johnnyegel/Pico1541/docs/specs/task.md

# Task List: Root Directory Virtual Disk & Unified Location Architecture

- [x] 1. Canonical `DriveLocation` Type (`crates/pico1541-common/src/location.rs`)
- [x] 2. Root Directory Virtual Disk Track 18 Formatter (`crates/pico1541-manager/src/formats/virtual_disk.rs`)
- [x] 3. Unified CD Action Resolution & Location State Machine (`crates/pico1541-manager/src/tasks/mount_manager/cd_handler.rs`)
- [x] 4. Job Queue Selection for Root Slots & Mount Manager Integration (`crates/pico1541-manager/src/tasks/mount_manager/mod.rs`)
- [x] 5. Reactive OLED UI Integration & State Consolidation (`crates/pico1541-manager/src/tasks/ui/`, `rp2040/src/main.rs`, `rp2350/src/main.rs`)
- [x] 6. Full Verification, Release Target Checks & Code Cleanup
