johnnyegel/Pico1541/COMMERCIAL_LICENSE.md

# Commercial Licensing

This project is free for personal, non-commercial use. If you would like to manufacture and sell assembled 
Pico1541 units, I offer a commercial license for a flat royalty fee of 5 EUR/USD per sold unit. 

Please contact me at [johnnyege@gmail.com] to arrange a licensing agreement before beginning production.
