johnnyegel/Pico1541/tmp/1541 ROM disassembly.txt

<!DOCTYPE html>
<html lang="en-US">
<head>
	<meta charset="UTF-8">
	<title>pagetable.com &#8211; Some Assembly Required</title>
<meta name='robots' content='max-image-preview:large' />
<base href="/">
<meta name="viewport" content="width=device-width, initial-scale=1"><link rel="alternate" type="application/rss+xml" title="pagetable.com &raquo; Feed" href="https://www.pagetable.com/?feed=rss2" />
<link rel="alternate" type="application/rss+xml" title="pagetable.com &raquo; Comments Feed" href="https://www.pagetable.com/?feed=comments-rss2" />
<style id="wp-img-auto-sizes-contain-inline-css">
img:is([sizes=auto i],[sizes^="auto," i]){contain-intrinsic-size:3000px 1500px}
/*# sourceURL=wp-img-auto-sizes-contain-inline-css */
</style>
<style id="wp-emoji-styles-inline-css">

	img.wp-smiley, img.emoji {
		display: inline !important;
		border: none !important;
		box-shadow: none !important;
		height: 1em !important;
		width: 1em !important;
		margin: 0 0.07em !important;
		vertical-align: -0.1em !important;
		background: none !important;
		padding: 0 !important;
	}
/*# sourceURL=wp-emoji-styles-inline-css */
</style>
<style id="wp-block-library-inline-css">
:root{--wp-block-synced-color:#7a00df;--wp-block-synced-color--rgb:122,0,223;--wp-bound-block-color:var(--wp-block-synced-color);--wp-editor-canvas-background:#ddd;--wp-admin-theme-color:#007cba;--wp-admin-theme-color--rgb:0,124,186;--wp-admin-theme-color-darker-10:#006ba1;--wp-admin-theme-color-darker-10--rgb:0,107,160.5;--wp-admin-theme-color-darker-20:#005a87;--wp-admin-theme-color-darker-20--rgb:0,90,135;--wp-admin-border-width-focus:2px}@media (min-resolution:192dpi){:root{--wp-admin-border-width-focus:1.5px}}.wp-element-button{cursor:pointer}:root .has-very-light-gray-background-color{background-color:#eee}:root .has-very-dark-gray-background-color{background-color:#313131}:root .has-very-light-gray-color{color:#eee}:root .has-very-dark-gray-color{color:#313131}:root .has-vivid-green-cyan-to-vivid-cyan-blue-gradient-background{background:linear-gradient(135deg,#00d084,#0693e3)}:root .has-purple-crush-gradient-background{background:linear-gradient(135deg,#34e2e4,#4721fb 50%,#ab1dfe)}:root .has-hazy-dawn-gradient-background{background:linear-gradient(135deg,#faaca8,#dad0ec)}:root .has-subdued-olive-gradient-background{background:linear-gradient(135deg,#fafae1,#67a671)}:root .has-atomic-cream-gradient-background{background:linear-gradient(135deg,#fdd79a,#004a59)}:root .has-nightshade-gradient-background{background:linear-gradient(135deg,#330968,#31cdcf)}:root .has-midnight-gradient-background{background:linear-gradient(135deg,#020381,#2874fc)}:root{--wp--preset--font-size--normal:16px;--wp--preset--font-size--huge:42px}.has-regular-font-size{font-size:1em}.has-larger-font-size{font-size:2.625em}.has-normal-font-size{font-size:var(--wp--preset--font-size--normal)}.has-huge-font-size{font-size:var(--wp--preset--font-size--huge)}:root .has-text-align-center{text-align:center}:root .has-text-align-left{text-align:left}:root .has-text-align-right{text-align:right}.has-fit-text{white-space:nowrap!important}#end-resizable-editor-section{display:none}.aligncenter{clear:both}.items-justified-left{justify-content:flex-start}.items-justified-center{justify-content:center}.items-justified-right{justify-content:flex-end}.items-justified-space-between{justify-content:space-between}.screen-reader-text{word-wrap:normal!important;border:0;clip-path:inset(50%);height:1px;margin:-1px;overflow:hidden;padding:0;position:absolute;width:1px}.screen-reader-text:focus{background-color:#ddd;clip-path:none;color:#444;display:block;font-size:1em;height:auto;left:5px;line-height:normal;padding:15px 23px 14px;text-decoration:none;top:5px;width:auto;z-index:100000}html :where(.has-border-color){border-style:solid}html :where([style*=border-color]){border-style:solid}html :where([style*=border-top-color]){border-top-style:solid}html :where([style*=border-right-color]){border-right-style:solid}html :where([style*=border-bottom-color]){border-bottom-style:solid}html :where([style*=border-left-color]){border-left-style:solid}html :where([style*=border-width]){border-style:solid}html :where([style*=border-top-width]){border-top-style:solid}html :where([style*=border-right-width]){border-right-style:solid}html :where([style*=border-bottom-width]){border-bottom-style:solid}html :where([style*=border-left-width]){border-left-style:solid}html :where(img[class*=wp-image-]){height:auto;max-width:100%}:where(figure){margin:0 0 1em}html :where(.is-position-sticky){--wp-admin--admin-bar--position-offset:var(--wp-admin--admin-bar--height,0px)}@media screen and (max-width:600px){html :where(.is-position-sticky){--wp-admin--admin-bar--position-offset:0px}}

/*# sourceURL=/wp-includes/css/dist/block-library/common.min.css */
</style>
<style id="wp-block-heading-inline-css">
h1:where(.wp-block-heading).has-background,h2:where(.wp-block-heading).has-background,h3:where(.wp-block-heading).has-background,h4:where(.wp-block-heading).has-background,h5:where(.wp-block-heading).has-background,h6:where(.wp-block-heading).has-background{padding:1.25em 2.375em}h1.has-text-align-left[style*=writing-mode]:where([style*=vertical-lr]),h1.has-text-align-right[style*=writing-mode]:where([style*=vertical-rl]),h2.has-text-align-left[style*=writing-mode]:where([style*=vertical-lr]),h2.has-text-align-right[style*=writing-mode]:where([style*=vertical-rl]),h3.has-text-align-left[style*=writing-mode]:where([style*=vertical-lr]),h3.has-text-align-right[style*=writing-mode]:where([style*=vertical-rl]),h4.has-text-align-left[style*=writing-mode]:where([style*=vertical-lr]),h4.has-text-align-right[style*=writing-mode]:where([style*=vertical-rl]),h5.has-text-align-left[style*=writing-mode]:where([style*=vertical-lr]),h5.has-text-align-right[style*=writing-mode]:where([style*=vertical-rl]),h6.has-text-align-left[style*=writing-mode]:where([style*=vertical-lr]),h6.has-text-align-right[style*=writing-mode]:where([style*=vertical-rl]){rotate:180deg}
/*# sourceURL=https://www.pagetable.com/wp-includes/blocks/heading/style.min.css */
</style>
<style id="wp-block-latest-comments-inline-css">
ol.wp-block-latest-comments{box-sizing:border-box;margin-left:0}:where(.wp-block-latest-comments:not([style*=line-height] .wp-block-latest-comments__comment)){line-height:1.1}:where(.wp-block-latest-comments:not([style*=line-height] .wp-block-latest-comments__comment-excerpt p)){line-height:1.8}.has-dates :where(.wp-block-latest-comments:not([style*=line-height])),.has-excerpts :where(.wp-block-latest-comments:not([style*=line-height])){line-height:1.5}.wp-block-latest-comments .wp-block-latest-comments{padding-left:0}.wp-block-latest-comments__comment{list-style:none;margin-bottom:1em}.has-avatars .wp-block-latest-comments__comment{list-style:none;min-height:2.25em}.has-avatars .wp-block-latest-comments__comment .wp-block-latest-comments__comment-excerpt,.has-avatars .wp-block-latest-comments__comment .wp-block-latest-comments__comment-meta{margin-left:3.25em}.wp-block-latest-comments__comment-excerpt p{font-size:.875em;margin:.36em 0 1.4em}.wp-block-latest-comments__comment-date{display:block;font-size:.75em}.wp-block-latest-comments .avatar,.wp-block-latest-comments__comment-avatar{border-radius:1.5em;display:block;float:left;height:2.5em;margin-right:.75em;width:2.5em}.wp-block-latest-comments[class*=-font-size] a,.wp-block-latest-comments[style*=font-size] a{font-size:inherit}
/*# sourceURL=https://www.pagetable.com/wp-includes/blocks/latest-comments/style.min.css */
</style>
<style id="wp-block-search-inline-css">
.wp-block-search__button{margin-left:10px;word-break:normal}.wp-block-search__button.has-icon{line-height:0}.wp-block-search__button svg{fill:currentColor;height:1.25em;min-height:24px;min-width:24px;vertical-align:text-bottom;width:1.25em}:where(.wp-block-search__button){border:1px solid #ccc;padding:6px 10px}.wp-block-search__inside-wrapper{display:flex;flex:auto;flex-wrap:nowrap;max-width:100%}.wp-block-search__label{width:100%}.wp-block-search.wp-block-search__button-only .wp-block-search__button{box-sizing:border-box;display:flex;flex-shrink:0;justify-content:center;margin-left:0;max-width:100%}.wp-block-search.wp-block-search__button-only .wp-block-search__inside-wrapper{min-width:0!important;transition-property:width}.wp-block-search.wp-block-search__button-only .wp-block-search__input{flex-basis:100%;transition-duration:.3s}.wp-block-search.wp-block-search__button-only.wp-block-search__searchfield-hidden,.wp-block-search.wp-block-search__button-only.wp-block-search__searchfield-hidden .wp-block-search__inside-wrapper{overflow:hidden}.wp-block-search.wp-block-search__button-only.wp-block-search__searchfield-hidden .wp-block-search__input{border-left-width:0!important;border-right-width:0!important;flex-basis:0;flex-grow:0;margin:0;min-width:0!important;padding-left:0!important;padding-right:0!important;width:0!important}:where(.wp-block-search__input){appearance:none;border:1px solid #949494;flex-grow:1;font-family:inherit;font-size:inherit;font-style:inherit;font-weight:inherit;letter-spacing:inherit;line-height:inherit;margin-left:0;margin-right:0;min-width:3rem;padding:8px;text-decoration:unset!important;text-transform:inherit}:where(.wp-block-search__button-inside .wp-block-search__inside-wrapper){background-color:#fff;border:1px solid #949494;box-sizing:border-box;padding:4px}:where(.wp-block-search__button-inside .wp-block-search__inside-wrapper) .wp-block-search__input{border:none;border-radius:0;padding:0 4px}:where(.wp-block-search__button-inside .wp-block-search__inside-wrapper) .wp-block-search__input:focus{outline:none}:where(.wp-block-search__button-inside .wp-block-search__inside-wrapper) :where(.wp-block-search__button){padding:4px 8px}.wp-block-search.aligncenter .wp-block-search__inside-wrapper{margin:auto}.wp-block[data-align=right] .wp-block-search.wp-block-search__button-only .wp-block-search__inside-wrapper{float:right}
/*# sourceURL=https://www.pagetable.com/wp-includes/blocks/search/style.min.css */
</style>
<style id="wp-block-group-inline-css">
.wp-block-group{box-sizing:border-box}:where(.wp-block-group.wp-block-group-is-layout-constrained){position:relative}
/*# sourceURL=https://www.pagetable.com/wp-includes/blocks/group/style.min.css */
</style>

<style id="classic-theme-styles-inline-css">
/*! This file is auto-generated */
.wp-block-button__link{color:#fff;background-color:#32373c;border-radius:9999px;box-shadow:none;text-decoration:none;padding:calc(.667em + 2px) calc(1.333em + 2px);font-size:1.125em}.wp-block-file__button{background:#32373c;color:#fff;text-decoration:none}
/*# sourceURL=/wp-includes/css/classic-themes.min.css */
</style>

<style id="global-styles-inline-css">
:root{--wp--preset--aspect-ratio--square: 1;--wp--preset--aspect-ratio--4-3: 4/3;--wp--preset--aspect-ratio--3-4: 3/4;--wp--preset--aspect-ratio--3-2: 3/2;--wp--preset--aspect-ratio--2-3: 2/3;--wp--preset--aspect-ratio--16-9: 16/9;--wp--preset--aspect-ratio--9-16: 9/16;--wp--preset--color--black: #000000;--wp--preset--color--cyan-bluish-gray: #abb8c3;--wp--preset--color--white: #ffffff;--wp--preset--color--pale-pink: #f78da7;--wp--preset--color--vivid-red: #cf2e2e;--wp--preset--color--luminous-vivid-orange: #ff6900;--wp--preset--color--luminous-vivid-amber: #fcb900;--wp--preset--color--light-green-cyan: #7bdcb5;--wp--preset--color--vivid-green-cyan: #00d084;--wp--preset--color--pale-cyan-blue: #8ed1fc;--wp--preset--color--vivid-cyan-blue: #0693e3;--wp--preset--color--vivid-purple: #9b51e0;--wp--preset--color--contrast: var(--contrast);--wp--preset--color--contrast-2: var(--contrast-2);--wp--preset--color--contrast-3: var(--contrast-3);--wp--preset--color--base: var(--base);--wp--preset--color--base-2: var(--base-2);--wp--preset--color--base-3: var(--base-3);--wp--preset--color--accent: var(--accent);--wp--preset--gradient--vivid-cyan-blue-to-vivid-purple: linear-gradient(135deg,rgb(6,147,227) 0%,rgb(155,81,224) 100%);--wp--preset--gradient--light-green-cyan-to-vivid-green-cyan: linear-gradient(135deg,rgb(122,220,180) 0%,rgb(0,208,130) 100%);--wp--preset--gradient--luminous-vivid-amber-to-luminous-vivid-orange: linear-gradient(135deg,rgb(252,185,0) 0%,rgb(255,105,0) 100%);--wp--preset--gradient--luminous-vivid-orange-to-vivid-red: linear-gradient(135deg,rgb(255,105,0) 0%,rgb(207,46,46) 100%);--wp--preset--gradient--very-light-gray-to-cyan-bluish-gray: linear-gradient(135deg,rgb(238,238,238) 0%,rgb(169,184,195) 100%);--wp--preset--gradient--cool-to-warm-spectrum: linear-gradient(135deg,rgb(74,234,220) 0%,rgb(151,120,209) 20%,rgb(207,42,186) 40%,rgb(238,44,130) 60%,rgb(251,105,98) 80%,rgb(254,248,76) 100%);--wp--preset--gradient--blush-light-purple: linear-gradient(135deg,rgb(255,206,236) 0%,rgb(152,150,240) 100%);--wp--preset--gradient--blush-bordeaux: linear-gradient(135deg,rgb(254,205,165) 0%,rgb(254,45,45) 50%,rgb(107,0,62) 100%);--wp--preset--gradient--luminous-dusk: linear-gradient(135deg,rgb(255,203,112) 0%,rgb(199,81,192) 50%,rgb(65,88,208) 100%);--wp--preset--gradient--pale-ocean: linear-gradient(135deg,rgb(255,245,203) 0%,rgb(182,227,212) 50%,rgb(51,167,181) 100%);--wp--preset--gradient--electric-grass: linear-gradient(135deg,rgb(202,248,128) 0%,rgb(113,206,126) 100%);--wp--preset--gradient--midnight: linear-gradient(135deg,rgb(2,3,129) 0%,rgb(40,116,252) 100%);--wp--preset--font-size--small: 13px;--wp--preset--font-size--medium: 20px;--wp--preset--font-size--large: 36px;--wp--preset--font-size--x-large: 42px;--wp--preset--spacing--20: 0.44rem;--wp--preset--spacing--30: 0.67rem;--wp--preset--spacing--40: 1rem;--wp--preset--spacing--50: 1.5rem;--wp--preset--spacing--60: 2.25rem;--wp--preset--spacing--70: 3.38rem;--wp--preset--spacing--80: 5.06rem;--wp--preset--shadow--natural: 6px 6px 9px rgba(0, 0, 0, 0.2);--wp--preset--shadow--deep: 12px 12px 50px rgba(0, 0, 0, 0.4);--wp--preset--shadow--sharp: 6px 6px 0px rgba(0, 0, 0, 0.2);--wp--preset--shadow--outlined: 6px 6px 0px -3px rgb(255, 255, 255), 6px 6px rgb(0, 0, 0);--wp--preset--shadow--crisp: 6px 6px 0px rgb(0, 0, 0);}:where(body) { margin: 0; }:where(.is-layout-flex){gap: 0.5em;}:where(.is-layout-grid){gap: 0.5em;}body .is-layout-flex{display: flex;}.is-layout-flex{flex-wrap: wrap;align-items: center;}.is-layout-flex > :is(*, div){margin: 0;}body .is-layout-grid{display: grid;}.is-layout-grid > :is(*, div){margin: 0;}body{padding-top: 0px;padding-right: 0px;padding-bottom: 0px;padding-left: 0px;}:root :where(.wp-element-button, .wp-block-button__link){background-color: #32373c;border-width: 0;color: #fff;font-family: inherit;font-size: inherit;font-style: inherit;font-weight: inherit;letter-spacing: inherit;line-height: inherit;padding-top: calc(0.667em + 2px);padding-right: calc(1.333em + 2px);padding-bottom: calc(0.667em + 2px);padding-left: calc(1.333em + 2px);text-decoration: none;text-transform: inherit;}.has-black-color{color: var(--wp--preset--color--black) !important;}.has-cyan-bluish-gray-color{color: var(--wp--preset--color--cyan-bluish-gray) !important;}.has-white-color{color: var(--wp--preset--color--white) !important;}.has-pale-pink-color{color: var(--wp--preset--color--pale-pink) !important;}.has-vivid-red-color{color: var(--wp--preset--color--vivid-red) !important;}.has-luminous-vivid-orange-color{color: var(--wp--preset--color--luminous-vivid-orange) !important;}.has-luminous-vivid-amber-color{color: var(--wp--preset--color--luminous-vivid-amber) !important;}.has-light-green-cyan-color{color: var(--wp--preset--color--light-green-cyan) !important;}.has-vivid-green-cyan-color{color: var(--wp--preset--color--vivid-green-cyan) !important;}.has-pale-cyan-blue-color{color: var(--wp--preset--color--pale-cyan-blue) !important;}.has-vivid-cyan-blue-color{color: var(--wp--preset--color--vivid-cyan-blue) !important;}.has-vivid-purple-color{color: var(--wp--preset--color--vivid-purple) !important;}.has-contrast-color{color: var(--wp--preset--color--contrast) !important;}.has-contrast-2-color{color: var(--wp--preset--color--contrast-2) !important;}.has-contrast-3-color{color: var(--wp--preset--color--contrast-3) !important;}.has-base-color{color: var(--wp--preset--color--base) !important;}.has-base-2-color{color: var(--wp--preset--color--base-2) !important;}.has-base-3-color{color: var(--wp--preset--color--base-3) !important;}.has-accent-color{color: var(--wp--preset--color--accent) !important;}.has-black-background-color{background-color: var(--wp--preset--color--black) !important;}.has-cyan-bluish-gray-background-color{background-color: var(--wp--preset--color--cyan-bluish-gray) !important;}.has-white-background-color{background-color: var(--wp--preset--color--white) !important;}.has-pale-pink-background-color{background-color: var(--wp--preset--color--pale-pink) !important;}.has-vivid-red-background-color{background-color: var(--wp--preset--color--vivid-red) !important;}.has-luminous-vivid-orange-background-color{background-color: var(--wp--preset--color--luminous-vivid-orange) !important;}.has-luminous-vivid-amber-background-color{background-color: var(--wp--preset--color--luminous-vivid-amber) !important;}.has-light-green-cyan-background-color{background-color: var(--wp--preset--color--light-green-cyan) !important;}.has-vivid-green-cyan-background-color{background-color: var(--wp--preset--color--vivid-green-cyan) !important;}.has-pale-cyan-blue-background-color{background-color: var(--wp--preset--color--pale-cyan-blue) !important;}.has-vivid-cyan-blue-background-color{background-color: var(--wp--preset--color--vivid-cyan-blue) !important;}.has-vivid-purple-background-color{background-color: var(--wp--preset--color--vivid-purple) !important;}.has-contrast-background-color{background-color: var(--wp--preset--color--contrast) !important;}.has-contrast-2-background-color{background-color: var(--wp--preset--color--contrast-2) !important;}.has-contrast-3-background-color{background-color: var(--wp--preset--color--contrast-3) !important;}.has-base-background-color{background-color: var(--wp--preset--color--base) !important;}.has-base-2-background-color{background-color: var(--wp--preset--color--base-2) !important;}.has-base-3-background-color{background-color: var(--wp--preset--color--base-3) !important;}.has-accent-background-color{background-color: var(--wp--preset--color--accent) !important;}.has-black-border-color{border-color: var(--wp--preset--color--black) !important;}.has-cyan-bluish-gray-border-color{border-color: var(--wp--preset--color--cyan-bluish-gray) !important;}.has-white-border-color{border-color: var(--wp--preset--color--white) !important;}.has-pale-pink-border-color{border-color: var(--wp--preset--color--pale-pink) !important;}.has-vivid-red-border-color{border-color: var(--wp--preset--color--vivid-red) !important;}.has-luminous-vivid-orange-border-color{border-color: var(--wp--preset--color--luminous-vivid-orange) !important;}.has-luminous-vivid-amber-border-color{border-color: var(--wp--preset--color--luminous-vivid-amber) !important;}.has-light-green-cyan-border-color{border-color: var(--wp--preset--color--light-green-cyan) !important;}.has-vivid-green-cyan-border-color{border-color: var(--wp--preset--color--vivid-green-cyan) !important;}.has-pale-cyan-blue-border-color{border-color: var(--wp--preset--color--pale-cyan-blue) !important;}.has-vivid-cyan-blue-border-color{border-color: var(--wp--preset--color--vivid-cyan-blue) !important;}.has-vivid-purple-border-color{border-color: var(--wp--preset--color--vivid-purple) !important;}.has-contrast-border-color{border-color: var(--wp--preset--color--contrast) !important;}.has-contrast-2-border-color{border-color: var(--wp--preset--color--contrast-2) !important;}.has-contrast-3-border-color{border-color: var(--wp--preset--color--contrast-3) !important;}.has-base-border-color{border-color: var(--wp--preset--color--base) !important;}.has-base-2-border-color{border-color: var(--wp--preset--color--base-2) !important;}.has-base-3-border-color{border-color: var(--wp--preset--color--base-3) !important;}.has-accent-border-color{border-color: var(--wp--preset--color--accent) !important;}.has-vivid-cyan-blue-to-vivid-purple-gradient-background{background: var(--wp--preset--gradient--vivid-cyan-blue-to-vivid-purple) !important;}.has-light-green-cyan-to-vivid-green-cyan-gradient-background{background: var(--wp--preset--gradient--light-green-cyan-to-vivid-green-cyan) !important;}.has-luminous-vivid-amber-to-luminous-vivid-orange-gradient-background{background: var(--wp--preset--gradient--luminous-vivid-amber-to-luminous-vivid-orange) !important;}.has-luminous-vivid-orange-to-vivid-red-gradient-background{background: var(--wp--preset--gradient--luminous-vivid-orange-to-vivid-red) !important;}.has-very-light-gray-to-cyan-bluish-gray-gradient-background{background: var(--wp--preset--gradient--very-light-gray-to-cyan-bluish-gray) !important;}.has-cool-to-warm-spectrum-gradient-background{background: var(--wp--preset--gradient--cool-to-warm-spectrum) !important;}.has-blush-light-purple-gradient-background{background: var(--wp--preset--gradient--blush-light-purple) !important;}.has-blush-bordeaux-gradient-background{background: var(--wp--preset--gradient--blush-bordeaux) !important;}.has-luminous-dusk-gradient-background{background: var(--wp--preset--gradient--luminous-dusk) !important;}.has-pale-ocean-gradient-background{background: var(--wp--preset--gradient--pale-ocean) !important;}.has-electric-grass-gradient-background{background: var(--wp--preset--gradient--electric-grass) !important;}.has-midnight-gradient-background{background: var(--wp--preset--gradient--midnight) !important;}.has-small-font-size{font-size: var(--wp--preset--font-size--small) !important;}.has-medium-font-size{font-size: var(--wp--preset--font-size--medium) !important;}.has-large-font-size{font-size: var(--wp--preset--font-size--large) !important;}.has-x-large-font-size{font-size: var(--wp--preset--font-size--x-large) !important;}
/*# sourceURL=global-styles-inline-css */
</style>

<link rel='stylesheet' id='generate-style-css' href='https://www.pagetable.com/wp-content/themes/generatepress/assets/css/main.min.css?ver=3.5.1' media='all' />
<style id="generate-style-inline-css">
body{background-color:var(--base-2);color:var(--contrast);}a{color:var(--accent);}a{text-decoration:underline;}.entry-title a, .site-branding a, a.button, .wp-block-button__link, .main-navigation a{text-decoration:none;}a:hover, a:focus, a:active{color:var(--contrast);}.wp-block-group__inner-container{max-width:1200px;margin-left:auto;margin-right:auto;}:root{--contrast:#222222;--contrast-2:#575760;--contrast-3:#b2b2be;--base:#f0f0f0;--base-2:#f7f8f9;--base-3:#ffffff;--accent:#1e73be;}:root .has-contrast-color{color:var(--contrast);}:root .has-contrast-background-color{background-color:var(--contrast);}:root .has-contrast-2-color{color:var(--contrast-2);}:root .has-contrast-2-background-color{background-color:var(--contrast-2);}:root .has-contrast-3-color{color:var(--contrast-3);}:root .has-contrast-3-background-color{background-color:var(--contrast-3);}:root .has-base-color{color:var(--base);}:root .has-base-background-color{background-color:var(--base);}:root .has-base-2-color{color:var(--base-2);}:root .has-base-2-background-color{background-color:var(--base-2);}:root .has-base-3-color{color:var(--base-3);}:root .has-base-3-background-color{background-color:var(--base-3);}:root .has-accent-color{color:var(--accent);}:root .has-accent-background-color{background-color:var(--accent);}.top-bar{background-color:#636363;color:#ffffff;}.top-bar a{color:#ffffff;}.top-bar a:hover{color:#303030;}.site-header{background-color:var(--base-3);}.main-title a,.main-title a:hover{color:var(--contrast);}.site-description{color:var(--contrast-2);}.mobile-menu-control-wrapper .menu-toggle,.mobile-menu-control-wrapper .menu-toggle:hover,.mobile-menu-control-wrapper .menu-toggle:focus,.has-inline-mobile-toggle #site-navigation.toggled{background-color:rgba(0, 0, 0, 0.02);}.main-navigation,.main-navigation ul ul{background-color:var(--base-3);}.main-navigation .main-nav ul li a, .main-navigation .menu-toggle, .main-navigation .menu-bar-items{color:var(--contrast);}.main-navigation .main-nav ul li:not([class*="current-menu-"]):hover > a, .main-navigation .main-nav ul li:not([class*="current-menu-"]):focus > a, .main-navigation .main-nav ul li.sfHover:not([class*="current-menu-"]) > a, .main-navigation .menu-bar-item:hover > a, .main-navigation .menu-bar-item.sfHover > a{color:var(--accent);}button.menu-toggle:hover,button.menu-toggle:focus{color:var(--contrast);}.main-navigation .main-nav ul li[class*="current-menu-"] > a{color:var(--accent);}.navigation-search input[type="search"],.navigation-search input[type="search"]:active, .navigation-search input[type="search"]:focus, .main-navigation .main-nav ul li.search-item.active > a, .main-navigation .menu-bar-items .search-item.active > a{color:var(--accent);}.main-navigation ul ul{background-color:var(--base);}.separate-containers .inside-article, .separate-containers .comments-area, .separate-containers .page-header, .one-container .container, .separate-containers .paging-navigation, .inside-page-header{background-color:var(--base-3);}.entry-title a{color:var(--contrast);}.entry-title a:hover{color:var(--contrast-2);}.entry-meta{color:var(--contrast-2);}.sidebar .widget{background-color:var(--base-3);}.footer-widgets{background-color:var(--base-3);}.site-info{background-color:var(--base-3);}input[type="text"],input[type="email"],input[type="url"],input[type="password"],input[type="search"],input[type="tel"],input[type="number"],textarea,select{color:var(--contrast);background-color:var(--base-2);border-color:var(--base);}input[type="text"]:focus,input[type="email"]:focus,input[type="url"]:focus,input[type="password"]:focus,input[type="search"]:focus,input[type="tel"]:focus,input[type="number"]:focus,textarea:focus,select:focus{color:var(--contrast);background-color:var(--base-2);border-color:var(--contrast-3);}button,html input[type="button"],input[type="reset"],input[type="submit"],a.button,a.wp-block-button__link:not(.has-background){color:#ffffff;background-color:#55555e;}button:hover,html input[type="button"]:hover,input[type="reset"]:hover,input[type="submit"]:hover,a.button:hover,button:focus,html input[type="button"]:focus,input[type="reset"]:focus,input[type="submit"]:focus,a.button:focus,a.wp-block-button__link:not(.has-background):active,a.wp-block-button__link:not(.has-background):focus,a.wp-block-button__link:not(.has-background):hover{color:#ffffff;background-color:#3f4047;}a.generate-back-to-top{background-color:rgba( 0,0,0,0.4 );color:#ffffff;}a.generate-back-to-top:hover,a.generate-back-to-top:focus{background-color:rgba( 0,0,0,0.6 );color:#ffffff;}:root{--gp-search-modal-bg-color:var(--base-3);--gp-search-modal-text-color:var(--contrast);--gp-search-modal-overlay-bg-color:rgba(0,0,0,0.2);}@media (max-width:768px){.main-navigation .menu-bar-item:hover > a, .main-navigation .menu-bar-item.sfHover > a{background:none;color:var(--contrast);}}.nav-below-header .main-navigation .inside-navigation.grid-container, .nav-above-header .main-navigation .inside-navigation.grid-container{padding:0px 20px 0px 20px;}.site-main .wp-block-group__inner-container{padding:40px;}.separate-containers .paging-navigation{padding-top:20px;padding-bottom:20px;}.entry-content .alignwide, body:not(.no-sidebar) .entry-content .alignfull{margin-left:-40px;width:calc(100% + 80px);max-width:calc(100% + 80px);}.rtl .menu-item-has-children .dropdown-menu-toggle{padding-left:20px;}.rtl .main-navigation .main-nav ul li.menu-item-has-children > a{padding-right:20px;}@media (max-width:768px){.separate-containers .inside-article, .separate-containers .comments-area, .separate-containers .page-header, .separate-containers .paging-navigation, .one-container .site-content, .inside-page-header{padding:30px;}.site-main .wp-block-group__inner-container{padding:30px;}.inside-top-bar{padding-right:30px;padding-left:30px;}.inside-header{padding-right:30px;padding-left:30px;}.widget-area .widget{padding-top:30px;padding-right:30px;padding-bottom:30px;padding-left:30px;}.footer-widgets-container{padding-top:30px;padding-right:30px;padding-bottom:30px;padding-left:30px;}.inside-site-info{padding-right:30px;padding-left:30px;}.entry-content .alignwide, body:not(.no-sidebar) .entry-content .alignfull{margin-left:-30px;width:calc(100% + 60px);max-width:calc(100% + 60px);}.one-container .site-main .paging-navigation{margin-bottom:20px;}}/* End cached CSS */.is-right-sidebar{width:30%;}.is-left-sidebar{width:30%;}.site-content .content-area{width:70%;}@media (max-width:768px){.main-navigation .menu-toggle,.sidebar-nav-mobile:not(#sticky-placeholder){display:block;}.main-navigation ul,.gen-sidebar-nav,.main-navigation:not(.slideout-navigation):not(.toggled) .main-nav > ul,.has-inline-mobile-toggle #site-navigation .inside-navigation > *:not(.navigation-search):not(.main-nav){display:none;}.nav-align-right .inside-navigation,.nav-align-center .inside-navigation{justify-content:space-between;}.has-inline-mobile-toggle .mobile-menu-control-wrapper{display:flex;flex-wrap:wrap;}.has-inline-mobile-toggle .inside-header{flex-direction:row;text-align:left;flex-wrap:wrap;}.has-inline-mobile-toggle .header-widget,.has-inline-mobile-toggle #site-navigation{flex-basis:100%;}.nav-float-left .has-inline-mobile-toggle #site-navigation{order:10;}}
/*# sourceURL=generate-style-inline-css */
</style>
<link rel='stylesheet' id='ecae-frontend-css' href='https://www.pagetable.com/wp-content/plugins/easy-custom-auto-excerpt/assets/style-frontend.css?ver=2.5.0' media='all' />
<style id="ecae-frontend-inline-css">
.ecae-button { font-size: 14px !important; }
/*# sourceURL=ecae-frontend-inline-css */
</style>
<link rel='stylesheet' id='ecae-buttonskin-none-css' href='https://www.pagetable.com/wp-content/plugins/easy-custom-auto-excerpt/buttons/ecae-buttonskin-none.css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' media='all' />
<link rel="https://api.w.org/" href="https://www.pagetable.com/index.php?rest_route=/" /><link rel="EditURI" type="application/rsd+xml" title="RSD" href="https://www.pagetable.com/xmlrpc.php?rsd" />
<meta name="generator" content="WordPress 7.0" />
<style id="wp-custom-css">
pre, code { font-family: monospace; font-size: smaller }

blockquote { font-size: 1em }
</style>
</head>

<body class="home blog wp-embed-responsive wp-theme-generatepress right-sidebar nav-float-right separate-containers header-aligned-left dropdown-hover" itemtype="https://schema.org/Blog" itemscope>
	<a class="screen-reader-text skip-link" href="#content" title="Skip to content">Skip to content</a>		<header class="site-header has-inline-mobile-toggle" id="masthead" aria-label="Site"  itemtype="https://schema.org/WPHeader" itemscope>
			<div class="inside-header grid-container">
				<div class="site-branding">
						<h1 class="main-title" itemprop="headline">
					<a href="https://www.pagetable.com/" rel="home">pagetable.com</a>
				</h1>
						<p class="site-description" itemprop="description">Some Assembly Required</p>
					</div>	<nav class="main-navigation mobile-menu-control-wrapper" id="mobile-menu-control-wrapper" aria-label="Mobile Toggle">
				<button data-nav="site-navigation" class="menu-toggle" aria-controls="primary-menu" aria-expanded="false">
			<span class="gp-icon icon-menu-bars"><svg viewBox="0 0 512 512" aria-hidden="true" xmlns="http://www.w3.org/2000/svg" width="1em" height="1em"><path d="M0 96c0-13.255 10.745-24 24-24h464c13.255 0 24 10.745 24 24s-10.745 24-24 24H24c-13.255 0-24-10.745-24-24zm0 160c0-13.255 10.745-24 24-24h464c13.255 0 24 10.745 24 24s-10.745 24-24 24H24c-13.255 0-24-10.745-24-24zm0 160c0-13.255 10.745-24 24-24h464c13.255 0 24 10.745 24 24s-10.745 24-24 24H24c-13.255 0-24-10.745-24-24z" /></svg><svg viewBox="0 0 512 512" aria-hidden="true" xmlns="http://www.w3.org/2000/svg" width="1em" height="1em"><path d="M71.029 71.029c9.373-9.372 24.569-9.372 33.942 0L256 222.059l151.029-151.03c9.373-9.372 24.569-9.372 33.942 0 9.372 9.373 9.372 24.569 0 33.942L289.941 256l151.03 151.029c9.372 9.373 9.372 24.569 0 33.942-9.373 9.372-24.569 9.372-33.942 0L256 289.941l-151.029 151.03c-9.373 9.372-24.569 9.372-33.942 0-9.372-9.373-9.372-24.569 0-33.942L222.059 256 71.029 104.971c-9.372-9.373-9.372-24.569 0-33.942z" /></svg></span><span class="screen-reader-text">Menu</span>		</button>
	</nav>
			<nav class="main-navigation sub-menu-right" id="site-navigation" aria-label="Primary"  itemtype="https://schema.org/SiteNavigationElement" itemscope>
			<div class="inside-navigation grid-container">
								<button class="menu-toggle" aria-controls="primary-menu" aria-expanded="false">
					<span class="gp-icon icon-menu-bars"><svg viewBox="0 0 512 512" aria-hidden="true" xmlns="http://www.w3.org/2000/svg" width="1em" height="1em"><path d="M0 96c0-13.255 10.745-24 24-24h464c13.255 0 24 10.745 24 24s-10.745 24-24 24H24c-13.255 0-24-10.745-24-24zm0 160c0-13.255 10.745-24 24-24h464c13.255 0 24 10.745 24 24s-10.745 24-24 24H24c-13.255 0-24-10.745-24-24zm0 160c0-13.255 10.745-24 24-24h464c13.255 0 24 10.745 24 24s-10.745 24-24 24H24c-13.255 0-24-10.745-24-24z" /></svg><svg viewBox="0 0 512 512" aria-hidden="true" xmlns="http://www.w3.org/2000/svg" width="1em" height="1em"><path d="M71.029 71.029c9.373-9.372 24.569-9.372 33.942 0L256 222.059l151.029-151.03c9.373-9.372 24.569-9.372 33.942 0 9.372 9.373 9.372 24.569 0 33.942L289.941 256l151.03 151.029c9.372 9.373 9.372 24.569 0 33.942-9.373 9.372-24.569 9.372-33.942 0L256 289.941l-151.029 151.03c-9.373 9.372-24.569 9.372-33.942 0-9.372-9.373-9.372-24.569 0-33.942L222.059 256 71.029 104.971c-9.372-9.373-9.372-24.569 0-33.942z" /></svg></span><span class="mobile-menu">Menu</span>				</button>
						<div id="primary-menu" class="main-nav">
			<ul class="menu sf-menu">
				<li class="page_item page-item-7"><a href="https://www.pagetable.com/?page_id=7">About</a></li>
			</ul>
		</div>
					</div>
		</nav>
					</div>
		</header>
		
	<div class="site grid-container container hfeed" id="page">
				<div class="site-content" id="content">
			
	<div class="content-area" id="primary">
		<main class="site-main" id="main">
			<article id="post-1844" class="post-1844 post type-post status-publish format-standard hentry category-c64 category-commodore category-literature" itemtype="https://schema.org/CreativeWork" itemscope>
	<div class="inside-article">
					<header class="entry-header">
				<h2 class="entry-title" itemprop="headline"><a href="https://www.pagetable.com/?p=1844" rel="bookmark">Das Statistikbuch zum Commodore 64 [PDF]</a></h2>		<div class="entry-meta">
			<span class="posted-on"><time class="entry-date published" datetime="2026-06-06T10:00:00+02:00" itemprop="datePublished">2026-06-06</time></span> <span class="byline">by <span class="author vcard" itemprop="author" itemtype="https://schema.org/Person" itemscope><a class="url fn n" href="https://www.pagetable.com/?author=1" title="View all posts by Michael Steil" rel="author" itemprop="url"><span class="author-name" itemprop="name">Michael Steil</span></a></span></span> 		</div>
					</header>
			
			<div class="entry-summary" itemprop="text">
				<!-- Begin :: Generated by Easy Custom Auto Excerpt --><div class="ecae" style=""><div class="ecae-image ecae-table-right"><div class='ecae-table-cell'><p><a href="docs/dirk_books/Das Statistikbuch zum Commodore 64.pdf"><br />
Werner Vo&szlig;:<br />
<b>Das Statistikbuch zum Commodore 64</b><br />
D&uuml;sseldorf: Data Becker, 1985.<br />
ISBN 3-89011-102-5.<br />
(468 pages, 33 MB)</a><br />
<em>Danke an Dirk Wagner f&uuml;r die Bereitstellung des Buchs.</em><span class="ecae-button ecae-buttonskin-none" style="text-align:left" >  <a class="ecae-link" href="https://www.pagetable.com/?p=1844"><span>read more</span></a></span></p></div></div><!-- End :: Generated by Easy Custom Auto Excerpt -->			</div>

				<footer class="entry-meta" aria-label="Entry meta">
			<span class="cat-links"><span class="gp-icon icon-categories"><svg viewBox="0 0 512 512" aria-hidden="true" xmlns="http://www.w3.org/2000/svg" width="1em" height="1em"><path d="M0 112c0-26.51 21.49-48 48-48h110.014a48 48 0 0143.592 27.907l12.349 26.791A16 16 0 00228.486 128H464c26.51 0 48 21.49 48 48v224c0 26.51-21.49 48-48 48H48c-26.51 0-48-21.49-48-48V112z" /></svg></span><span class="screen-reader-text">Categories </span><a href="https://www.pagetable.com/?cat=41" rel="category">C64</a>, <a href="https://www.pagetable.com/?cat=8" rel="category">Commodore</a>, <a href="https://www.pagetable.com/?cat=20" rel="category">Literature</a></span> <span class="comments-link"><span class="gp-icon icon-comments"><svg viewBox="0 0 512 512" aria-hidden="true" xmlns="http://www.w3.org/2000/svg" width="1em" height="1em"><path d="M132.838 329.973a435.298 435.298 0 0016.769-9.004c13.363-7.574 26.587-16.142 37.419-25.507 7.544.597 15.27.925 23.098.925 54.905 0 105.634-15.311 143.285-41.28 23.728-16.365 43.115-37.692 54.155-62.645 54.739 22.205 91.498 63.272 91.498 110.286 0 42.186-29.558 79.498-75.09 102.828 23.46 49.216 75.09 101.709 75.09 101.709s-115.837-38.35-154.424-78.46c-9.956 1.12-20.297 1.758-30.793 1.758-88.727 0-162.927-43.071-181.007-100.61z"/><path d="M383.371 132.502c0 70.603-82.961 127.787-185.216 127.787-10.496 0-20.837-.639-30.793-1.757-38.587 40.093-154.424 78.429-154.424 78.429s51.63-52.472 75.09-101.67c-45.532-23.321-75.09-60.619-75.09-102.79C12.938 61.9 95.9 4.716 198.155 4.716 300.41 4.715 383.37 61.9 383.37 132.502z" /></svg></span><a href="https://www.pagetable.com/?p=1844#respond">Leave a comment</a></span> 		</footer>
			</div>
</article>
<article id="post-1842" class="post-1842 post type-post status-publish format-standard hentry category-c64 category-commodore category-literature" itemtype="https://schema.org/CreativeWork" itemscope>
	<div class="inside-article">
					<header class="entry-header">
				<h2 class="entry-title" itemprop="headline"><a href="https://www.pagetable.com/?p=1842" rel="bookmark">Das Schulbuch zum Commodore 64 [PDF]</a></h2>		<div class="entry-meta">
			<span class="posted-on"><time class="entry-date published" datetime="2026-05-30T10:00:00+02:00" itemprop="datePublished">2026-05-30</time></span> <span class="byline">by <span class="author vcard" itemprop="author" itemtype="https://schema.org/Person" itemscope><a class="url fn n" href="https://www.pagetable.com/?author=1" title="View all posts by Michael Steil" rel="author" itemprop="url"><span class="author-name" itemprop="name">Michael Steil</span></a></span></span> 		</div>
					</header>
			
			<div class="entry-summary" itemprop="text">
				<!-- Begin :: Generated by Easy Custom Auto Excerpt --><div class="ecae" style=""><div class="ecae-image ecae-table-right"><div class='ecae-table-cell'><p><a href="docs/dirk_books/Das Schulbuch zum Commodore 64.pdf"><br />
Werner Vo&szlig;:<br />
<b>Das Schulbuch zum Commodore 64</b><br />
D&uuml;sseldorf: Data Becker, 1984.<br />
ISBN 3-89011-019-3.<br />
(354 pages, 21 MB)</a><br />
<em>Danke an Dirk Wagner f&uuml;r die Bereitstellung des Buchs.</em><span class="ecae-button ecae-buttonskin-none" style="text-align:left" >  <a class="ecae-link" href="https://www.pagetable.com/?p=1842"><span>read more</span></a></span></p></div></div><!-- End :: Generated by Easy Custom Auto Excerpt -->			</div>

				<footer class="entry-meta" aria-label="Entry meta">
			<span class="cat-links"><span class="gp-icon icon-categories"><svg viewBox="0 0 512 512" aria-hidden="true" xmlns="http://www.w3.org/2000/svg" width="1em" height="1em"><path d="M0 112c0-26.51 21.49-48 48-48h110.014a48 48 0 0143.592 27.907l12.349 26.791A16 16 0 00228.486 128H464c26.51 0 48 21.49 48 48v224c0 26.51-21.49 48-48 48H48c-26.51 0-48-21.49-48-48V112z" /></svg></span><span class="screen-reader-text">Categories </span><a href="https://www.pagetable.com/?cat=41" rel="category">C64</a>, <a href="https://www.pagetable.com/?cat=8" rel="category">Commodore</a>, <a href="https://www.pagetable.com/?cat=20" rel="category">Literature</a></span> <span class="comments-link"><span class="gp-icon icon-comments"><svg viewBox="0 0 512 512" aria-hidden="true" xmlns="http://www.w3.org/2000/svg" width="1em" height="1em"><path d="M132.838 329.973a435.298 435.298 0 0016.769-9.004c13.363-7.574 26.587-16.142 37.419-25.507 7.544.597 15.27.925 23.098.925 54.905 0 105.634-15.311 143.285-41.28 23.728-16.365 43.115-37.692 54.155-62.645 54.739 22.205 91.498 63.272 91.498 110.286 0 42.186-29.558 79.498-75.09 102.828 23.46 49.216 75.09 101.709 75.09 101.709s-115.837-38.35-154.424-78.46c-9.956 1.12-20.297 1.758-30.793 1.758-88.727 0-162.927-43.071-181.007-100.61z"/><path d="M383.371 132.502c0 70.603-82.961 127.787-185.216 127.787-10.496 0-20.837-.639-30.793-1.757-38.587 40.093-154.424 78.429-154.424 78.429s51.63-52.472 75.09-101.67c-45.532-23.321-75.09-60.619-75.09-102.79C12.938 61.9 95.9 4.716 198.155 4.716 300.41 4.715 383.37 61.9 383.37 132.502z" /></svg></span><a href="https://www.pagetable.com/?p=1842#comments">2 Comments</a></span> 		</footer>
			</div>
</article>
<article id="post-1840" class="post-1840 post type-post status-publish format-standard hentry category-c64 category-commodore category-literature" itemtype="https://schema.org/CreativeWork" itemscope>
	<div class="inside-article">
					<header class="entry-header">
				<h2 class="entry-title" itemprop="headline"><a href="https://www.pagetable.com/?p=1840" rel="bookmark">Das Grafikbuch zum Commodore 64 [PDF]</a></h2>		<div class="entry-meta">
			<span class="posted-on"><time class="entry-date published" datetime="2026-05-23T10:00:00+02:00" itemprop="datePublished">2026-05-23</time></span> <span class="byline">by <span class="author vcard" itemprop="author" itemtype="https://schema.org/Person" itemscope><a class="url fn n" href="https://www.pagetable.com/?author=1" title="View all posts by Michael Steil" rel="author" itemprop="url"><span class="author-name" itemprop="name">Michael Steil</span></a></span></span> 		</div>
					</header>
			
			<div class="entry-summary" itemprop="text">
				<!-- Begin :: Generated by Easy Custom Auto Excerpt --><div class="ecae" style=""><div class="ecae-image ecae-table-right"><div class='ecae-table-cell'><p><a href="docs/dirk_books/Das Grafikbuch zum Commodore 64.pdf"><br />
Axel Plenge:<br />
<b>Das Grafikbuch zum Commodore 64</b><br />
D&uuml;sseldorf: Data Becker, 1984.<br />
ISBN 3-89011-009-6.<br />
(305 pages, 28 MB)</a><br />
<em>Danke an Dirk Wagner f&uuml;r die Bereitstellung des Buchs.</em><span class="ecae-button ecae-buttonskin-none" style="text-align:left" >  <a class="ecae-link" href="https://www.pagetable.com/?p=1840"><span>read more</span></a></span></p></div></div><!-- End :: Generated by Easy Custom Auto Excerpt -->			</div>

				<footer class="entry-meta" aria-label="Entry meta">
			<span class="cat-links"><span class="gp-icon icon-categories"><svg viewBox="0 0 512 512" aria-hidden="true" xmlns="http://www.w3.org/2000/svg" width="1em" height="1em"><path d="M0 112c0-26.51 21.49-48 48-48h110.014a48 48 0 0143.592 27.907l12.349 26.791A16 16 0 00228.486 128H464c26.51 0 48 21.49 48 48v224c0 26.51-21.49 48-48 48H48c-26.51 0-48-21.49-48-48V112z" /></svg></span><span class="screen-reader-text">Categories </span><a href="https://www.pagetable.com/?cat=41" rel="category">C64</a>, <a href="https://www.pagetable.com/?cat=8" rel="category">Commodore</a>, <a href="https://www.pagetable.com/?cat=20" rel="category">Literature</a></span> <span class="comments-link"><span class="gp-icon icon-comments"><svg viewBox="0 0 512 512" aria-hidden="true" xmlns="http://www.w3.org/2000/svg" width="1em" height="1em"><path d="M132.838 329.973a435.298 435.298 0 0016.769-9.004c13.363-7.574 26.587-16.142 37.419-25.507 7.544.597 15.27.925 23.098.925 54.905 0 105.634-15.311 143.285-41.28 23.728-16.365 43.115-37.692 54.155-62.645 54.739 22.205 91.498 63.272 91.498 110.286 0 42.186-29.558 79.498-75.09 102.828 23.46 49.216 75.09 101.709 75.09 101.709s-115.837-38.35-154.424-78.46c-9.956 1.12-20.297 1.758-30.793 1.758-88.727 0-162.927-43.071-181.007-100.61z"/><path d="M383.371 132.502c0 70.603-82.961 127.787-185.216 127.787-10.496 0-20.837-.639-30.793-1.757-38.587 40.093-154.424 78.429-154.424 78.429s51.63-52.472 75.09-101.67c-45.532-23.321-75.09-60.619-75.09-102.79C12.938 61.9 95.9 4.716 198.155 4.716 300.41 4.715 383.37 61.9 383.37 132.502z" /></svg></span><a href="https://www.pagetable.com/?p=1840#comments">2 Comments</a></span> 		</footer>
			</div>
</article>
<article id="post-1837" class="post-1837 post type-post status-publish format-standard hentry category-c64 category-commodore category-literature" itemtype="https://schema.org/CreativeWork" itemscope>
	<div class="inside-article">
					<header class="entry-header">
				<h2 class="entry-title" itemprop="headline"><a href="https://www.pagetable.com/?p=1837" rel="bookmark">Das Commodore-64-Spiele-Buch [PDF]</a></h2>		<div class="entry-meta">
			<span class="posted-on"><time class="entry-date published" datetime="2026-05-16T10:00:00+02:00" itemprop="datePublished">2026-05-16</time></span> <span class="byline">by <span class="author vcard" itemprop="author" itemtype="https://schema.org/Person" itemscope><a class="url fn n" href="https://www.pagetable.com/?author=1" title="View all posts by Michael Steil" rel="author" itemprop="url"><span class="author-name" itemprop="name">Michael Steil</span></a></span></span> 		</div>
					</header>
			
			<div class="entry-summary" itemprop="text">
				<!-- Begin :: Generated by Easy Custom Auto Excerpt --><div class="ecae" style=""><div class="ecae-image ecae-table-right"><div class='ecae-table-cell'><p><a href="docs/dirk_books/Das Commodore 64 Spiele-Buch.pdf"><br />
Owen Bishop:<br />
<b>Das Commodore-64-Spiele-Buch</b><br />
Frankfurt/M.: Commodore, 1984. (Commodore-Sachbuchreihe, Bd. 4)<br />
ISBN 3-89133-002-2.<br />
(162 pages, 29 MB)<br />
Aus dem Englischen &uuml;bertragen von Gudrun Breiter. Originaltitel: <i>The Commodore 64 Games Book &ndash; 21 Sensational Games</i> (Granada Publishing, 1983).</a><br />
<em>Danke an Dirk Wagner f&uuml;r die Bereitstellung des Buchs.</em><span class="ecae-button ecae-buttonskin-none" style="text-align:left" >  <a class="ecae-link" href="https://www.pagetable.com/?p=1837"><span>read more</span></a></span></p></div></div><!-- End :: Generated by Easy Custom Auto Excerpt -->			</div>

				<footer class="entry-meta" aria-label="Entry meta">
			<span class="cat-links"><span class="gp-icon icon-categories"><svg viewBox="0 0 512 512" aria-hidden="true" xmlns="http://www.w3.org/2000/svg" width="1em" height="1em"><path d="M0 112c0-26.51 21.49-48 48-48h110.014a48 48 0 0143.592 27.907l12.349 26.791A16 16 0 00228.486 128H464c26.51 0 48 21.49 48 48v224c0 26.51-21.49 48-48 48H48c-26.51 0-48-21.49-48-48V112z" /></svg></span><span class="screen-reader-text">Categories </span><a href="https://www.pagetable.com/?cat=41" rel="category">C64</a>, <a href="https://www.pagetable.com/?cat=8" rel="category">Commodore</a>, <a href="https://www.pagetable.com/?cat=20" rel="category">Literature</a></span> <span class="comments-link"><span class="gp-icon icon-comments"><svg viewBox="0 0 512 512" aria-hidden="true" xmlns="http://www.w3.org/2000/svg" width="1em" height="1em"><path d="M132.838 329.973a435.298 435.298 0 0016.769-9.004c13.363-7.574 26.587-16.142 37.419-25.507 7.544.597 15.27.925 23.098.925 54.905 0 105.634-15.311 143.285-41.28 23.728-16.365 43.115-37.692 54.155-62.645 54.739 22.205 91.498 63.272 91.498 110.286 0 42.186-29.558 79.498-75.09 102.828 23.46 49.216 75.09 101.709 75.09 101.709s-115.837-38.35-154.424-78.46c-9.956 1.12-20.297 1.758-30.793 1.758-88.727 0-162.927-43.071-181.007-100.61z"/><path d="M383.371 132.502c0 70.603-82.961 127.787-185.216 127.787-10.496 0-20.837-.639-30.793-1.757-38.587 40.093-154.424 78.429-154.424 78.429s51.63-52.472 75.09-101.67c-45.532-23.321-75.09-60.619-75.09-102.79C12.938 61.9 95.9 4.716 198.155 4.716 300.41 4.715 383.37 61.9 383.37 132.502z" /></svg></span><a href="https://www.pagetable.com/?p=1837#comments">6 Comments</a></span> 		</footer>
			</div>
</article>
<article id="post-1860" class="post-1860 post type-post status-publish format-standard hentry category-2 category-archeology category-basic category-c64 category-commodore category-literature" itemtype="https://schema.org/CreativeWork" itemscope>
	<div class="inside-article">
					<header class="entry-header">
				<h2 class="entry-title" itemprop="headline"><a href="https://www.pagetable.com/?p=1860" rel="bookmark">Das Nikolaus-Heusler-Archiv</a></h2>		<div class="entry-meta">
			<span class="posted-on"><time class="entry-date published" datetime="2026-05-09T08:47:24+02:00" itemprop="datePublished">2026-05-09</time></span> <span class="byline">by <span class="author vcard" itemprop="author" itemtype="https://schema.org/Person" itemscope><a class="url fn n" href="https://www.pagetable.com/?author=1" title="View all posts by Michael Steil" rel="author" itemprop="url"><span class="author-name" itemprop="name">Michael Steil</span></a></span></span> 		</div>
					</header>
			
			<div class="entry-summary" itemprop="text">
				<!-- Begin :: Generated by Easy Custom Auto Excerpt --><div class="ecae" style=""><div class="ecae-image ecae-table-right"><div class="ecae-table-cell" style="width:200px;padding:0px 0px 0px 0px;"><a href="/docs/nheusler/">Screenshot des Heusler-Archivs auf pagetable.com</a></div><div class='ecae-table-cell'><p>Nikolaus Heusler zählt zu den produktivsten Autoren des <em>64&#8217;er Magazins</em>: hunderte Beiträge zwischen 1987 und 1995. Heusler, Jahrgang 1969, hatte seinen C64 zu Weihnachten 1983 bekommen; heute arbeitet er beim Europäischen Patentamt in München.<span class="ecae-button ecae-buttonskin-none" style="text-align:left" >  <a class="ecae-link" href="https://www.pagetable.com/?p=1860"><span>read more</span></a></span></p></div></div><!-- End :: Generated by Easy Custom Auto Excerpt -->			</div>

				<footer class="entry-meta" aria-label="Entry meta">
			<span class="cat-links"><span class="gp-icon icon-categories"><svg viewBox="0 0 512 512" aria-hidden="true" xmlns="http://www.w3.org/2000/svg" width="1em" height="1em"><path d="M0 112c0-26.51 21.49-48 48-48h110.014a48 48 0 0143.592 27.907l12.349 26.791A16 16 0 00228.486 128H464c26.51 0 48 21.49 48 48v224c0 26.51-21.49 48-48 48H48c-26.51 0-48-21.49-48-48V112z" /></svg></span><span class="screen-reader-text">Categories </span><a href="https://www.pagetable.com/?cat=2" rel="category">6502</a>, <a href="https://www.pagetable.com/?cat=5" rel="category">Archeology</a>, <a href="https://www.pagetable.com/?cat=6" rel="category">BASIC</a>, <a href="https://www.pagetable.com/?cat=41" rel="category">C64</a>, <a href="https://www.pagetable.com/?cat=8" rel="category">Commodore</a>, <a href="https://www.pagetable.com/?cat=20" rel="category">Literature</a></span> <span class="comments-link"><span class="gp-icon icon-comments"><svg viewBox="0 0 512 512" aria-hidden="true" xmlns="http://www.w3.org/2000/svg" width="1em" height="1em"><path d="M132.838 329.973a435.298 435.298 0 0016.769-9.004c13.363-7.574 26.587-16.142 37.419-25.507 7.544.597 15.27.925 23.098.925 54.905 0 105.634-15.311 143.285-41.28 23.728-16.365 43.115-37.692 54.155-62.645 54.739 22.205 91.498 63.272 91.498 110.286 0 42.186-29.558 79.498-75.09 102.828 23.46 49.216 75.09 101.709 75.09 101.709s-115.837-38.35-154.424-78.46c-9.956 1.12-20.297 1.758-30.793 1.758-88.727 0-162.927-43.071-181.007-100.61z"/><path d="M383.371 132.502c0 70.603-82.961 127.787-185.216 127.787-10.496 0-20.837-.639-30.793-1.757-38.587 40.093-154.424 78.429-154.424 78.429s51.63-52.472 75.09-101.67c-45.532-23.321-75.09-60.619-75.09-102.79C12.938 61.9 95.9 4.716 198.155 4.716 300.41 4.715 383.37 61.9 383.37 132.502z" /></svg></span><a href="https://www.pagetable.com/?p=1860#comments">3 Comments</a></span> 		</footer>
			</div>
</article>
<article id="post-1854" class="post-1854 post type-post status-publish format-standard hentry category-archeology category-postscript" itemtype="https://schema.org/CreativeWork" itemscope>
	<div class="inside-article">
					<header class="entry-header">
				<h2 class="entry-title" itemprop="headline"><a href="https://www.pagetable.com/?p=1854" rel="bookmark">Running Adobe&#8217;s 1991 PostScript Interpreter in the Browser</a></h2>		<div class="entry-meta">
			<span class="posted-on"><time class="updated" datetime="2026-05-01T15:04:54+02:00" itemprop="dateModified">2026-05-01</time><time class="entry-date published" datetime="2026-05-01T13:51:35+02:00" itemprop="datePublished">2026-05-01</time></span> <span class="byline">by <span class="author vcard" itemprop="author" itemtype="https://schema.org/Person" itemscope><a class="url fn n" href="https://www.pagetable.com/?author=1" title="View all posts by Michael Steil" rel="author" itemprop="url"><span class="author-name" itemprop="name">Michael Steil</span></a></span></span> 		</div>
					</header>
			
			<div class="entry-summary" itemprop="text">
				<!-- Begin :: Generated by Easy Custom Auto Excerpt --><div class="ecae" style=""><div class="ecae-image ecae-table-right"><div class="ecae-table-cell" style="width:200px;padding:0px 0px 0px 0px;"><a href="https://www.pagetable.com/retro-ps/">retro-ps in the browser, rendering the cart's own test page</a></div><div class='ecae-table-cell'><p>The <a href="https://www.pagetable.com/?p=1673">HP C2089A &ldquo;PostScript Cartridge Plus&rdquo;</a>, a 1991 add-on for the LaserJet II/III, adds PostScript Level 2 support through Adobe&rsquo;s own reference interpreter (version 2010.118) on a 2 MB ROM.<span class="ecae-button ecae-buttonskin-none" style="text-align:left" >  <a class="ecae-link" href="https://www.pagetable.com/?p=1854"><span>read more</span></a></span></p></div></div><!-- End :: Generated by Easy Custom Auto Excerpt -->			</div>

				<footer class="entry-meta" aria-label="Entry meta">
			<span class="cat-links"><span class="gp-icon icon-categories"><svg viewBox="0 0 512 512" aria-hidden="true" xmlns="http://www.w3.org/2000/svg" width="1em" height="1em"><path d="M0 112c0-26.51 21.49-48 48-48h110.014a48 48 0 0143.592 27.907l12.349 26.791A16 16 0 00228.486 128H464c26.51 0 48 21.49 48 48v224c0 26.51-21.49 48-48 48H48c-26.51 0-48-21.49-48-48V112z" /></svg></span><span class="screen-reader-text">Categories </span><a href="https://www.pagetable.com/?cat=5" rel="category">Archeology</a>, <a href="https://www.pagetable.com/?cat=24" rel="category">PostScript</a></span> <span class="comments-link"><span class="gp-icon icon-comments"><svg viewBox="0 0 512 512" aria-hidden="true" xmlns="http://www.w3.org/2000/svg" width="1em" height="1em"><path d="M132.838 329.973a435.298 435.298 0 0016.769-9.004c13.363-7.574 26.587-16.142 37.419-25.507 7.544.597 15.27.925 23.098.925 54.905 0 105.634-15.311 143.285-41.28 23.728-16.365 43.115-37.692 54.155-62.645 54.739 22.205 91.498 63.272 91.498 110.286 0 42.186-29.558 79.498-75.09 102.828 23.46 49.216 75.09 101.709 75.09 101.709s-115.837-38.35-154.424-78.46c-9.956 1.12-20.297 1.758-30.793 1.758-88.727 0-162.927-43.071-181.007-100.61z"/><path d="M383.371 132.502c0 70.603-82.961 127.787-185.216 127.787-10.496 0-20.837-.639-30.793-1.757-38.587 40.093-154.424 78.429-154.424 78.429s51.63-52.472 75.09-101.67c-45.532-23.321-75.09-60.619-75.09-102.79C12.938 61.9 95.9 4.716 198.155 4.716 300.41 4.715 383.37 61.9 383.37 132.502z" /></svg></span><a href="https://www.pagetable.com/?p=1854#comments">8 Comments</a></span> 		</footer>
			</div>
</article>
<article id="post-1850" class="post-1850 post type-post status-publish format-standard hentry category-archeology category-postscript" itemtype="https://schema.org/CreativeWork" itemscope>
	<div class="inside-article">
					<header class="entry-header">
				<h2 class="entry-title" itemprop="headline"><a href="https://www.pagetable.com/?p=1850" rel="bookmark">PacificPage P·E PostScript Cartridge for HP LaserJet II/III</a></h2>		<div class="entry-meta">
			<span class="posted-on"><time class="entry-date published" datetime="2026-04-25T10:00:00+02:00" itemprop="datePublished">2026-04-25</time></span> <span class="byline">by <span class="author vcard" itemprop="author" itemtype="https://schema.org/Person" itemscope><a class="url fn n" href="https://www.pagetable.com/?author=1" title="View all posts by Michael Steil" rel="author" itemprop="url"><span class="author-name" itemprop="name">Michael Steil</span></a></span></span> 		</div>
					</header>
			
			<div class="entry-summary" itemprop="text">
				<!-- Begin :: Generated by Easy Custom Auto Excerpt --><div class="ecae" style=""><div class="ecae-image ecae-table-right"><div class="ecae-table-cell" style="width:200px;padding:0px 0px 0px 0px;"></div><div class='ecae-table-cell'><p>PostScript came to the desktop in 1985 with the Apple LaserWriter, and within a year or two several other companies had joined Adobe&rsquo;s licensee list. HP was late — its own Adobe PostScript cartridge for the LaserJet II/III family didn&rsquo;t ship until 1991.<span class="ecae-button ecae-buttonskin-none" style="text-align:left" >  <a class="ecae-link" href="https://www.pagetable.com/?p=1850"><span>read more</span></a></span></p></div></div><!-- End :: Generated by Easy Custom Auto Excerpt -->			</div>

				<footer class="entry-meta" aria-label="Entry meta">
			<span class="cat-links"><span class="gp-icon icon-categories"><svg viewBox="0 0 512 512" aria-hidden="true" xmlns="http://www.w3.org/2000/svg" width="1em" height="1em"><path d="M0 112c0-26.51 21.49-48 48-48h110.014a48 48 0 0143.592 27.907l12.349 26.791A16 16 0 00228.486 128H464c26.51 0 48 21.49 48 48v224c0 26.51-21.49 48-48 48H48c-26.51 0-48-21.49-48-48V112z" /></svg></span><span class="screen-reader-text">Categories </span><a href="https://www.pagetable.com/?cat=5" rel="category">Archeology</a>, <a href="https://www.pagetable.com/?cat=24" rel="category">PostScript</a></span> <span class="comments-link"><span class="gp-icon icon-comments"><svg viewBox="0 0 512 512" aria-hidden="true" xmlns="http://www.w3.org/2000/svg" width="1em" height="1em"><path d="M132.838 329.973a435.298 435.298 0 0016.769-9.004c13.363-7.574 26.587-16.142 37.419-25.507 7.544.597 15.27.925 23.098.925 54.905 0 105.634-15.311 143.285-41.28 23.728-16.365 43.115-37.692 54.155-62.645 54.739 22.205 91.498 63.272 91.498 110.286 0 42.186-29.558 79.498-75.09 102.828 23.46 49.216 75.09 101.709 75.09 101.709s-115.837-38.35-154.424-78.46c-9.956 1.12-20.297 1.758-30.793 1.758-88.727 0-162.927-43.071-181.007-100.61z"/><path d="M383.371 132.502c0 70.603-82.961 127.787-185.216 127.787-10.496 0-20.837-.639-30.793-1.757-38.587 40.093-154.424 78.429-154.424 78.429s51.63-52.472 75.09-101.67c-45.532-23.321-75.09-60.619-75.09-102.79C12.938 61.9 95.9 4.716 198.155 4.716 300.41 4.715 383.37 61.9 383.37 132.502z" /></svg></span><a href="https://www.pagetable.com/?p=1850#comments">3 Comments</a></span> 		</footer>
			</div>
</article>
<article id="post-1827" class="post-1827 post type-post status-publish format-standard hentry category-c64 category-commodore category-literature" itemtype="https://schema.org/CreativeWork" itemscope>
	<div class="inside-article">
					<header class="entry-header">
				<h2 class="entry-title" itemprop="headline"><a href="https://www.pagetable.com/?p=1827" rel="bookmark">Lohnsteuerjahresausgleich? Einkommensteuererklärung? Mein C 64 hilft mir dabei! [PDF]</a></h2>		<div class="entry-meta">
			<span class="posted-on"><time class="entry-date published" datetime="2026-04-18T10:00:00+02:00" itemprop="datePublished">2026-04-18</time></span> <span class="byline">by <span class="author vcard" itemprop="author" itemtype="https://schema.org/Person" itemscope><a class="url fn n" href="https://www.pagetable.com/?author=1" title="View all posts by Michael Steil" rel="author" itemprop="url"><span class="author-name" itemprop="name">Michael Steil</span></a></span></span> 		</div>
					</header>
			
			<div class="entry-summary" itemprop="text">
				<!-- Begin :: Generated by Easy Custom Auto Excerpt --><div class="ecae" style=""><div class="ecae-image ecae-table-right"><div class='ecae-table-cell'><p><a href="docs/dirk_books/Lohnsteuerjahresausgleich.pdf"><br />
Ilona Kwiatkowski, Peter Vogt:<br />
<b>Lohnsteuerjahresausgleich? Einkommensteuererkl&auml;rung? Mein C 64 hilft mir dabei!</b><br />
Heidelberg: H&uuml;thig, 1985.<br />
(204 pages, 16 MB)</a><br />
<em>Danke an Dirk Wagner f&uuml;r die Bereitstellung des Buchs.</em><span class="ecae-button ecae-buttonskin-none" style="text-align:left" >  <a class="ecae-link" href="https://www.pagetable.com/?p=1827"><span>read more</span></a></span></p></div></div><!-- End :: Generated by Easy Custom Auto Excerpt -->			</div>

				<footer class="entry-meta" aria-label="Entry meta">
			<span class="cat-links"><span class="gp-icon icon-categories"><svg viewBox="0 0 512 512" aria-hidden="true" xmlns="http://www.w3.org/2000/svg" width="1em" height="1em"><path d="M0 112c0-26.51 21.49-48 48-48h110.014a48 48 0 0143.592 27.907l12.349 26.791A16 16 0 00228.486 128H464c26.51 0 48 21.49 48 48v224c0 26.51-21.49 48-48 48H48c-26.51 0-48-21.49-48-48V112z" /></svg></span><span class="screen-reader-text">Categories </span><a href="https://www.pagetable.com/?cat=41" rel="category">C64</a>, <a href="https://www.pagetable.com/?cat=8" rel="category">Commodore</a>, <a href="https://www.pagetable.com/?cat=20" rel="category">Literature</a></span> <span class="comments-link"><span class="gp-icon icon-comments"><svg viewBox="0 0 512 512" aria-hidden="true" xmlns="http://www.w3.org/2000/svg" width="1em" height="1em"><path d="M132.838 329.973a435.298 435.298 0 0016.769-9.004c13.363-7.574 26.587-16.142 37.419-25.507 7.544.597 15.27.925 23.098.925 54.905 0 105.634-15.311 143.285-41.28 23.728-16.365 43.115-37.692 54.155-62.645 54.739 22.205 91.498 63.272 91.498 110.286 0 42.186-29.558 79.498-75.09 102.828 23.46 49.216 75.09 101.709 75.09 101.709s-115.837-38.35-154.424-78.46c-9.956 1.12-20.297 1.758-30.793 1.758-88.727 0-162.927-43.071-181.007-100.61z"/><path d="M383.371 132.502c0 70.603-82.961 127.787-185.216 127.787-10.496 0-20.837-.639-30.793-1.757-38.587 40.093-154.424 78.429-154.424 78.429s51.63-52.472 75.09-101.67c-45.532-23.321-75.09-60.619-75.09-102.79C12.938 61.9 95.9 4.716 198.155 4.716 300.41 4.715 383.37 61.9 383.37 132.502z" /></svg></span><a href="https://www.pagetable.com/?p=1827#comments">1 Comment</a></span> 		</footer>
			</div>
</article>
<article id="post-1825" class="post-1825 post type-post status-publish format-standard hentry category-c64 category-commodore category-literature" itemtype="https://schema.org/CreativeWork" itemscope>
	<div class="inside-article">
					<header class="entry-header">
				<h2 class="entry-title" itemprop="headline"><a href="https://www.pagetable.com/?p=1825" rel="bookmark">Einführung in CAD mit dem Commodore 64 [PDF]</a></h2>		<div class="entry-meta">
			<span class="posted-on"><time class="updated" datetime="2026-04-16T07:36:38+02:00" itemprop="dateModified">2026-04-16</time><time class="entry-date published" datetime="2026-04-15T19:08:05+02:00" itemprop="datePublished">2026-04-15</time></span> <span class="byline">by <span class="author vcard" itemprop="author" itemtype="https://schema.org/Person" itemscope><a class="url fn n" href="https://www.pagetable.com/?author=1" title="View all posts by Michael Steil" rel="author" itemprop="url"><span class="author-name" itemprop="name">Michael Steil</span></a></span></span> 		</div>
					</header>
			
			<div class="entry-summary" itemprop="text">
				<!-- Begin :: Generated by Easy Custom Auto Excerpt --><div class="ecae" style=""><div class="ecae-image ecae-table-right"><div class='ecae-table-cell'><p><a href="docs/dirk_books/Einführung in CAD mit dem Commodore 64.pdf"><br />
Werner Heift:<br />
<b>Einf&uuml;hrung in CAD mit dem Commodore 64</b><br />
D&uuml;sseldorf: Data Becker, 1985.<br />
ISBN 3-89011-067-3.<br />
(322 pages, 18 MB)</a><br />
<em>Danke an Dirk Wagner f&uuml;r die Bereitstellung des Buchs.</em><span class="ecae-button ecae-buttonskin-none" style="text-align:left" >  <a class="ecae-link" href="https://www.pagetable.com/?p=1825"><span>read more</span></a></span></p></div></div><!-- End :: Generated by Easy Custom Auto Excerpt -->			</div>

				<footer class="entry-meta" aria-label="Entry meta">
			<span class="cat-links"><span class="gp-icon icon-categories"><svg viewBox="0 0 512 512" aria-hidden="true" xmlns="http://www.w3.org/2000/svg" width="1em" height="1em"><path d="M0 112c0-26.51 21.49-48 48-48h110.014a48 48 0 0143.592 27.907l12.349 26.791A16 16 0 00228.486 128H464c26.51 0 48 21.49 48 48v224c0 26.51-21.49 48-48 48H48c-26.51 0-48-21.49-48-48V112z" /></svg></span><span class="screen-reader-text">Categories </span><a href="https://www.pagetable.com/?cat=41" rel="category">C64</a>, <a href="https://www.pagetable.com/?cat=8" rel="category">Commodore</a>, <a href="https://www.pagetable.com/?cat=20" rel="category">Literature</a></span> <span class="comments-link"><span class="gp-icon icon-comments"><svg viewBox="0 0 512 512" aria-hidden="true" xmlns="http://www.w3.org/2000/svg" width="1em" height="1em"><path d="M132.838 329.973a435.298 435.298 0 0016.769-9.004c13.363-7.574 26.587-16.142 37.419-25.507 7.544.597 15.27.925 23.098.925 54.905 0 105.634-15.311 143.285-41.28 23.728-16.365 43.115-37.692 54.155-62.645 54.739 22.205 91.498 63.272 91.498 110.286 0 42.186-29.558 79.498-75.09 102.828 23.46 49.216 75.09 101.709 75.09 101.709s-115.837-38.35-154.424-78.46c-9.956 1.12-20.297 1.758-30.793 1.758-88.727 0-162.927-43.071-181.007-100.61z"/><path d="M383.371 132.502c0 70.603-82.961 127.787-185.216 127.787-10.496 0-20.837-.639-30.793-1.757-38.587 40.093-154.424 78.429-154.424 78.429s51.63-52.472 75.09-101.67c-45.532-23.321-75.09-60.619-75.09-102.79C12.938 61.9 95.9 4.716 198.155 4.716 300.41 4.715 383.37 61.9 383.37 132.502z" /></svg></span><a href="https://www.pagetable.com/?p=1825#comments">1 Comment</a></span> 		</footer>
			</div>
</article>
<article id="post-1820" class="post-1820 post type-post status-publish format-standard hentry category-c64 category-commodore category-literature" itemtype="https://schema.org/CreativeWork" itemscope>
	<div class="inside-article">
					<header class="entry-header">
				<h2 class="entry-title" itemprop="headline"><a href="https://www.pagetable.com/?p=1820" rel="bookmark">Das große Drucker-Buch [PDF]</a></h2>		<div class="entry-meta">
			<span class="posted-on"><time class="updated" datetime="2026-04-16T07:36:40+02:00" itemprop="dateModified">2026-04-16</time><time class="entry-date published" datetime="2026-04-04T22:18:34+02:00" itemprop="datePublished">2026-04-04</time></span> <span class="byline">by <span class="author vcard" itemprop="author" itemtype="https://schema.org/Person" itemscope><a class="url fn n" href="https://www.pagetable.com/?author=1" title="View all posts by Michael Steil" rel="author" itemprop="url"><span class="author-name" itemprop="name">Michael Steil</span></a></span></span> 		</div>
					</header>
			
			<div class="entry-summary" itemprop="text">
				<!-- Begin :: Generated by Easy Custom Auto Excerpt --><div class="ecae" style=""><div class="ecae-image ecae-table-right"><div class='ecae-table-cell'><p><a href="/docs/dirk_books/Das große Drucker-Buch.pdf"><br />
Rolf Br&uuml;ckmann, Klaus Gerits, Thomas Wiens:<br />
<b>Das gro&szlig;e Drucker-Buch</b><br />
D&uuml;sseldorf: Data Becker, 1984.<br />
ISBN 3-89011-020-7.<br />
(392 pages, 26 MB)</a><br />
<em>Danke an Dirk Wagner f&uuml;r die Bereitstellung des Buchs.</em><span class="ecae-button ecae-buttonskin-none" style="text-align:left" >  <a class="ecae-link" href="https://www.pagetable.com/?p=1820"><span>read more</span></a></span></p></div></div><!-- End :: Generated by Easy Custom Auto Excerpt -->			</div>

				<footer class="entry-meta" aria-label="Entry meta">
			<span class="cat-links"><span class="gp-icon icon-categories"><svg viewBox="0 0 512 512" aria-hidden="true" xmlns="http://www.w3.org/2000/svg" width="1em" height="1em"><path d="M0 112c0-26.51 21.49-48 48-48h110.014a48 48 0 0143.592 27.907l12.349 26.791A16 16 0 00228.486 128H464c26.51 0 48 21.49 48 48v224c0 26.51-21.49 48-48 48H48c-26.51 0-48-21.49-48-48V112z" /></svg></span><span class="screen-reader-text">Categories </span><a href="https://www.pagetable.com/?cat=41" rel="category">C64</a>, <a href="https://www.pagetable.com/?cat=8" rel="category">Commodore</a>, <a href="https://www.pagetable.com/?cat=20" rel="category">Literature</a></span> <span class="comments-link"><span class="gp-icon icon-comments"><svg viewBox="0 0 512 512" aria-hidden="true" xmlns="http://www.w3.org/2000/svg" width="1em" height="1em"><path d="M132.838 329.973a435.298 435.298 0 0016.769-9.004c13.363-7.574 26.587-16.142 37.419-25.507 7.544.597 15.27.925 23.098.925 54.905 0 105.634-15.311 143.285-41.28 23.728-16.365 43.115-37.692 54.155-62.645 54.739 22.205 91.498 63.272 91.498 110.286 0 42.186-29.558 79.498-75.09 102.828 23.46 49.216 75.09 101.709 75.09 101.709s-115.837-38.35-154.424-78.46c-9.956 1.12-20.297 1.758-30.793 1.758-88.727 0-162.927-43.071-181.007-100.61z"/><path d="M383.371 132.502c0 70.603-82.961 127.787-185.216 127.787-10.496 0-20.837-.639-30.793-1.757-38.587 40.093-154.424 78.429-154.424 78.429s51.63-52.472 75.09-101.67c-45.532-23.321-75.09-60.619-75.09-102.79C12.938 61.9 95.9 4.716 198.155 4.716 300.41 4.715 383.37 61.9 383.37 132.502z" /></svg></span><a href="https://www.pagetable.com/?p=1820#comments">1 Comment</a></span> 		</footer>
			</div>
</article>
<article id="post-1816" class="post-1816 post type-post status-publish format-standard hentry category-archeology category-c128 category-c64 category-commodore category-floppy-disks category-geos category-uncategorized" itemtype="https://schema.org/CreativeWork" itemscope>
	<div class="inside-article">
					<header class="entry-header">
				<h2 class="entry-title" itemprop="headline"><a href="https://www.pagetable.com/?p=1816" rel="bookmark">Klaus Finke&rsquo;s Commodore 64/128 GEOS Disk Collection</a></h2>		<div class="entry-meta">
			<span class="posted-on"><time class="entry-date published" datetime="2026-03-30T20:26:48+02:00" itemprop="datePublished">2026-03-30</time></span> <span class="byline">by <span class="author vcard" itemprop="author" itemtype="https://schema.org/Person" itemscope><a class="url fn n" href="https://www.pagetable.com/?author=1" title="View all posts by Michael Steil" rel="author" itemprop="url"><span class="author-name" itemprop="name">Michael Steil</span></a></span></span> 		</div>
					</header>
			
			<div class="entry-summary" itemprop="text">
				<!-- Begin :: Generated by Easy Custom Auto Excerpt --><div class="ecae" style=""><p>This is a collection of 111 Commodore 64/128 disk images from a box of CMD FD-2000 high-density floppy disks. The disks came from the estate of Klaus Finke (1945–2016), a GEOS community organizer from Suhl, Thuringia.<span class="ecae-button ecae-buttonskin-none" style="text-align:left" >  <a class="ecae-link" href="https://www.pagetable.com/?p=1816"><span>read more</span></a></span></p></div><!-- End :: Generated by Easy Custom Auto Excerpt -->			</div>

				<footer class="entry-meta" aria-label="Entry meta">
			<span class="cat-links"><span class="gp-icon icon-categories"><svg viewBox="0 0 512 512" aria-hidden="true" xmlns="http://www.w3.org/2000/svg" width="1em" height="1em"><path d="M0 112c0-26.51 21.49-48 48-48h110.014a48 48 0 0143.592 27.907l12.349 26.791A16 16 0 00228.486 128H464c26.51 0 48 21.49 48 48v224c0 26.51-21.49 48-48 48H48c-26.51 0-48-21.49-48-48V112z" /></svg></span><span class="screen-reader-text">Categories </span><a href="https://www.pagetable.com/?cat=5" rel="category">Archeology</a>, <a href="https://www.pagetable.com/?cat=40" rel="category">C128</a>, <a href="https://www.pagetable.com/?cat=41" rel="category">C64</a>, <a href="https://www.pagetable.com/?cat=8" rel="category">Commodore</a>, <a href="https://www.pagetable.com/?cat=13" rel="category">Floppy Disks</a>, <a href="https://www.pagetable.com/?cat=15" rel="category">GEOS</a>, <a href="https://www.pagetable.com/?cat=1" rel="category">Uncategorized</a></span> <span class="comments-link"><span class="gp-icon icon-comments"><svg viewBox="0 0 512 512" aria-hidden="true" xmlns="http://www.w3.org/2000/svg" width="1em" height="1em"><path d="M132.838 329.973a435.298 435.298 0 0016.769-9.004c13.363-7.574 26.587-16.142 37.419-25.507 7.544.597 15.27.925 23.098.925 54.905 0 105.634-15.311 143.285-41.28 23.728-16.365 43.115-37.692 54.155-62.645 54.739 22.205 91.498 63.272 91.498 110.286 0 42.186-29.558 79.498-75.09 102.828 23.46 49.216 75.09 101.709 75.09 101.709s-115.837-38.35-154.424-78.46c-9.956 1.12-20.297 1.758-30.793 1.758-88.727 0-162.927-43.071-181.007-100.61z"/><path d="M383.371 132.502c0 70.603-82.961 127.787-185.216 127.787-10.496 0-20.837-.639-30.793-1.757-38.587 40.093-154.424 78.429-154.424 78.429s51.63-52.472 75.09-101.67c-45.532-23.321-75.09-60.619-75.09-102.79C12.938 61.9 95.9 4.716 198.155 4.716 300.41 4.715 383.37 61.9 383.37 132.502z" /></svg></span><a href="https://www.pagetable.com/?p=1816#respond">Leave a comment</a></span> 		</footer>
			</div>
</article>
<article id="post-1810" class="post-1810 post type-post status-publish format-standard hentry category-2 category-c64 category-commodore category-final-cartridge-iii" itemtype="https://schema.org/CreativeWork" itemscope>
	<div class="inside-article">
					<header class="entry-header">
				<h2 class="entry-title" itemprop="headline"><a href="https://www.pagetable.com/?p=1810" rel="bookmark">How the Final Cartridge III Freezer works</a></h2>		<div class="entry-meta">
			<span class="posted-on"><time class="entry-date published" datetime="2025-06-14T18:21:34+02:00" itemprop="datePublished">2025-06-14</time></span> <span class="byline">by <span class="author vcard" itemprop="author" itemtype="https://schema.org/Person" itemscope><a class="url fn n" href="https://www.pagetable.com/?author=1" title="View all posts by Michael Steil" rel="author" itemprop="url"><span class="author-name" itemprop="name">Michael Steil</span></a></span></span> 		</div>
					</header>
			
			<div class="entry-summary" itemprop="text">
				<!-- Begin :: Generated by Easy Custom Auto Excerpt --><div class="ecae" style=""><div class="ecae-image ecae-table-right"><div class='ecae-table-cell'><p><em>by Daniël Mantione</em><span class="ecae-button ecae-buttonskin-none" style="text-align:left" >  <a class="ecae-link" href="https://www.pagetable.com/?p=1810"><span>read more</span></a></span></p></div></div><!-- End :: Generated by Easy Custom Auto Excerpt -->			</div>

				<footer class="entry-meta" aria-label="Entry meta">
			<span class="cat-links"><span class="gp-icon icon-categories"><svg viewBox="0 0 512 512" aria-hidden="true" xmlns="http://www.w3.org/2000/svg" width="1em" height="1em"><path d="M0 112c0-26.51 21.49-48 48-48h110.014a48 48 0 0143.592 27.907l12.349 26.791A16 16 0 00228.486 128H464c26.51 0 48 21.49 48 48v224c0 26.51-21.49 48-48 48H48c-26.51 0-48-21.49-48-48V112z" /></svg></span><span class="screen-reader-text">Categories </span><a href="https://www.pagetable.com/?cat=2" rel="category">6502</a>, <a href="https://www.pagetable.com/?cat=41" rel="category">C64</a>, <a href="https://www.pagetable.com/?cat=8" rel="category">Commodore</a>, <a href="https://www.pagetable.com/?cat=12" rel="category">Final Cartridge III</a></span> <span class="comments-link"><span class="gp-icon icon-comments"><svg viewBox="0 0 512 512" aria-hidden="true" xmlns="http://www.w3.org/2000/svg" width="1em" height="1em"><path d="M132.838 329.973a435.298 435.298 0 0016.769-9.004c13.363-7.574 26.587-16.142 37.419-25.507 7.544.597 15.27.925 23.098.925 54.905 0 105.634-15.311 143.285-41.28 23.728-16.365 43.115-37.692 54.155-62.645 54.739 22.205 91.498 63.272 91.498 110.286 0 42.186-29.558 79.498-75.09 102.828 23.46 49.216 75.09 101.709 75.09 101.709s-115.837-38.35-154.424-78.46c-9.956 1.12-20.297 1.758-30.793 1.758-88.727 0-162.927-43.071-181.007-100.61z"/><path d="M383.371 132.502c0 70.603-82.961 127.787-185.216 127.787-10.496 0-20.837-.639-30.793-1.757-38.587 40.093-154.424 78.429-154.424 78.429s51.63-52.472 75.09-101.67c-45.532-23.321-75.09-60.619-75.09-102.79C12.938 61.9 95.9 4.716 198.155 4.716 300.41 4.715 383.37 61.9 383.37 132.502z" /></svg></span><a href="https://www.pagetable.com/?p=1810#comments">10 Comments</a></span> 		</footer>
			</div>
</article>
<article id="post-1804" class="post-1804 post type-post status-publish format-standard hentry category-c64 category-literature" itemtype="https://schema.org/CreativeWork" itemscope>
	<div class="inside-article">
					<header class="entry-header">
				<h2 class="entry-title" itemprop="headline"><a href="https://www.pagetable.com/?p=1804" rel="bookmark">64 Tips &amp; Tricks [PDF]</a></h2>		<div class="entry-meta">
			<span class="posted-on"><time class="entry-date published" datetime="2025-05-25T16:53:12+02:00" itemprop="datePublished">2025-05-25</time></span> <span class="byline">by <span class="author vcard" itemprop="author" itemtype="https://schema.org/Person" itemscope><a class="url fn n" href="https://www.pagetable.com/?author=1" title="View all posts by Michael Steil" rel="author" itemprop="url"><span class="author-name" itemprop="name">Michael Steil</span></a></span></span> 		</div>
					</header>
			
			<div class="entry-summary" itemprop="text">
				<!-- Begin :: Generated by Easy Custom Auto Excerpt --><div class="ecae" style=""><div class="ecae-image ecae-table-right"><div class='ecae-table-cell'><p><a href="docs/dirk_books/64 Tips &#038; Tricks.pdf"><br />Michael Angerhausen, Lothar Englisch, Klaus Gerits, Frank Thrun:<br />64 Tips &amp; Tricks<br />Düsseldorf: Data Becker, 1984. (4. erweiterte und überarbeitete Auflage)<br />ISBN 3-89011-001-0.<br />(386 pages, 26 MB)</a><br />
<em>Danke an Dirk Wagner für die Bereitstellung des Buchs.</em><span class="ecae-button ecae-buttonskin-none" style="text-align:left" >  <a class="ecae-link" href="https://www.pagetable.com/?p=1804"><span>read more</span></a></span></p></div></div><!-- End :: Generated by Easy Custom Auto Excerpt -->			</div>

				<footer class="entry-meta" aria-label="Entry meta">
			<span class="cat-links"><span class="gp-icon icon-categories"><svg viewBox="0 0 512 512" aria-hidden="true" xmlns="http://www.w3.org/2000/svg" width="1em" height="1em"><path d="M0 112c0-26.51 21.49-48 48-48h110.014a48 48 0 0143.592 27.907l12.349 26.791A16 16 0 00228.486 128H464c26.51 0 48 21.49 48 48v224c0 26.51-21.49 48-48 48H48c-26.51 0-48-21.49-48-48V112z" /></svg></span><span class="screen-reader-text">Categories </span><a href="https://www.pagetable.com/?cat=41" rel="category">C64</a>, <a href="https://www.pagetable.com/?cat=20" rel="category">Literature</a></span> <span class="comments-link"><span class="gp-icon icon-comments"><svg viewBox="0 0 512 512" aria-hidden="true" xmlns="http://www.w3.org/2000/svg" width="1em" height="1em"><path d="M132.838 329.973a435.298 435.298 0 0016.769-9.004c13.363-7.574 26.587-16.142 37.419-25.507 7.544.597 15.27.925 23.098.925 54.905 0 105.634-15.311 143.285-41.28 23.728-16.365 43.115-37.692 54.155-62.645 54.739 22.205 91.498 63.272 91.498 110.286 0 42.186-29.558 79.498-75.09 102.828 23.46 49.216 75.09 101.709 75.09 101.709s-115.837-38.35-154.424-78.46c-9.956 1.12-20.297 1.758-30.793 1.758-88.727 0-162.927-43.071-181.007-100.61z"/><path d="M383.371 132.502c0 70.603-82.961 127.787-185.216 127.787-10.496 0-20.837-.639-30.793-1.757-38.587 40.093-154.424 78.429-154.424 78.429s51.63-52.472 75.09-101.67c-45.532-23.321-75.09-60.619-75.09-102.79C12.938 61.9 95.9 4.716 198.155 4.716 300.41 4.715 383.37 61.9 383.37 132.502z" /></svg></span><a href="https://www.pagetable.com/?p=1804#comments">3 Comments</a></span> 		</footer>
			</div>
</article>
<article id="post-1798" class="post-1798 post type-post status-publish format-standard hentry category-2 category-archeology category-literature" itemtype="https://schema.org/CreativeWork" itemscope>
	<div class="inside-article">
					<header class="entry-header">
				<h2 class="entry-title" itemprop="headline"><a href="https://www.pagetable.com/?p=1798" rel="bookmark">6502 Illegal Opcodes in the Siemens PC 100 Assembly Manual (1980)</a></h2>		<div class="entry-meta">
			<span class="posted-on"><time class="updated" datetime="2025-05-13T15:16:54+02:00" itemprop="dateModified">2025-05-13</time><time class="entry-date published" datetime="2025-05-08T14:17:06+02:00" itemprop="datePublished">2025-05-08</time></span> <span class="byline">by <span class="author vcard" itemprop="author" itemtype="https://schema.org/Person" itemscope><a class="url fn n" href="https://www.pagetable.com/?author=1" title="View all posts by Michael Steil" rel="author" itemprop="url"><span class="author-name" itemprop="name">Michael Steil</span></a></span></span> 		</div>
					</header>
			
			<div class="entry-summary" itemprop="text">
				<!-- Begin :: Generated by Easy Custom Auto Excerpt --><div class="ecae" style=""><div class="ecae-image ecae-table-right"><div class='ecae-table-cell'><p>The 6502&rsquo;s <a href="https://www.pagetable.com/?p=39">&ldquo;illegal&rdquo; opcodes</a> were of intense interest to home computer enthusiasts, and analyses were published in <a href="https://www.atarimagazines.com/compute/issue41/Extra_Instructions.php">various</a> <a href="https://www.64er-magazin.de/8503/opcodes.html">magazines</a>. But one would have never expected a company like Siemens to document illegal opcodes in a programming manual from 1980.<span class="ecae-button ecae-buttonskin-none" style="text-align:left" >  <a class="ecae-link" href="https://www.pagetable.com/?p=1798"><span>read more</span></a></span></p></div></div><!-- End :: Generated by Easy Custom Auto Excerpt -->			</div>

				<footer class="entry-meta" aria-label="Entry meta">
			<span class="cat-links"><span class="gp-icon icon-categories"><svg viewBox="0 0 512 512" aria-hidden="true" xmlns="http://www.w3.org/2000/svg" width="1em" height="1em"><path d="M0 112c0-26.51 21.49-48 48-48h110.014a48 48 0 0143.592 27.907l12.349 26.791A16 16 0 00228.486 128H464c26.51 0 48 21.49 48 48v224c0 26.51-21.49 48-48 48H48c-26.51 0-48-21.49-48-48V112z" /></svg></span><span class="screen-reader-text">Categories </span><a href="https://www.pagetable.com/?cat=2" rel="category">6502</a>, <a href="https://www.pagetable.com/?cat=5" rel="category">Archeology</a>, <a href="https://www.pagetable.com/?cat=20" rel="category">Literature</a></span> <span class="comments-link"><span class="gp-icon icon-comments"><svg viewBox="0 0 512 512" aria-hidden="true" xmlns="http://www.w3.org/2000/svg" width="1em" height="1em"><path d="M132.838 329.973a435.298 435.298 0 0016.769-9.004c13.363-7.574 26.587-16.142 37.419-25.507 7.544.597 15.27.925 23.098.925 54.905 0 105.634-15.311 143.285-41.28 23.728-16.365 43.115-37.692 54.155-62.645 54.739 22.205 91.498 63.272 91.498 110.286 0 42.186-29.558 79.498-75.09 102.828 23.46 49.216 75.09 101.709 75.09 101.709s-115.837-38.35-154.424-78.46c-9.956 1.12-20.297 1.758-30.793 1.758-88.727 0-162.927-43.071-181.007-100.61z"/><path d="M383.371 132.502c0 70.603-82.961 127.787-185.216 127.787-10.496 0-20.837-.639-30.793-1.757-38.587 40.093-154.424 78.429-154.424 78.429s51.63-52.472 75.09-101.67c-45.532-23.321-75.09-60.619-75.09-102.79C12.938 61.9 95.9 4.716 198.155 4.716 300.41 4.715 383.37 61.9 383.37 132.502z" /></svg></span><a href="https://www.pagetable.com/?p=1798#comments">1 Comment</a></span> 		</footer>
			</div>
</article>
<article id="post-1795" class="post-1795 post type-post status-publish format-standard hentry category-2 category-archeology category-literature" itemtype="https://schema.org/CreativeWork" itemscope>
	<div class="inside-article">
					<header class="entry-header">
				<h2 class="entry-title" itemprop="headline"><a href="https://www.pagetable.com/?p=1795" rel="bookmark">Siemens Personal Computer PC 100 Bedienungsanleitung, Ausgabe 1981/1982</a></h2>		<div class="entry-meta">
			<span class="posted-on"><time class="updated" datetime="2025-05-08T14:17:40+02:00" itemprop="dateModified">2025-05-08</time><time class="entry-date published" datetime="2025-05-07T17:44:39+02:00" itemprop="datePublished">2025-05-07</time></span> <span class="byline">by <span class="author vcard" itemprop="author" itemtype="https://schema.org/Person" itemscope><a class="url fn n" href="https://www.pagetable.com/?author=1" title="View all posts by Michael Steil" rel="author" itemprop="url"><span class="author-name" itemprop="name">Michael Steil</span></a></span></span> 		</div>
					</header>
			
			<div class="entry-summary" itemprop="text">
				<!-- Begin :: Generated by Easy Custom Auto Excerpt --><div class="ecae" style=""><div class="ecae-image ecae-table-right"><div class='ecae-table-cell'><p>The Siemens PC 100 was a version of the 6502-based &ldquo;AIM-65&rdquo; SBC in a case and with slightly modified ROMs. Siemens offered a set of German-language manuals, which included translated Assembler (<a href="https://www.pagetable.com/?p=1522">MOS Resident Assembler</a>) and BASIC (<a href="https://www.pagetable.com/?p=46">Microsoft</a> <a href="https://www.pagetable.com/?p=774">BASIC</a>) manuals, but also a general manual (&ldquo;Bedienungsanleitung&rdquo;).<span class="ecae-button ecae-buttonskin-none" style="text-align:left" >  <a class="ecae-link" href="https://www.pagetable.com/?p=1795"><span>read more</span></a></span></p></div></div><!-- End :: Generated by Easy Custom Auto Excerpt -->			</div>

				<footer class="entry-meta" aria-label="Entry meta">
			<span class="cat-links"><span class="gp-icon icon-categories"><svg viewBox="0 0 512 512" aria-hidden="true" xmlns="http://www.w3.org/2000/svg" width="1em" height="1em"><path d="M0 112c0-26.51 21.49-48 48-48h110.014a48 48 0 0143.592 27.907l12.349 26.791A16 16 0 00228.486 128H464c26.51 0 48 21.49 48 48v224c0 26.51-21.49 48-48 48H48c-26.51 0-48-21.49-48-48V112z" /></svg></span><span class="screen-reader-text">Categories </span><a href="https://www.pagetable.com/?cat=2" rel="category">6502</a>, <a href="https://www.pagetable.com/?cat=5" rel="category">Archeology</a>, <a href="https://www.pagetable.com/?cat=20" rel="category">Literature</a></span> <span class="comments-link"><span class="gp-icon icon-comments"><svg viewBox="0 0 512 512" aria-hidden="true" xmlns="http://www.w3.org/2000/svg" width="1em" height="1em"><path d="M132.838 329.973a435.298 435.298 0 0016.769-9.004c13.363-7.574 26.587-16.142 37.419-25.507 7.544.597 15.27.925 23.098.925 54.905 0 105.634-15.311 143.285-41.28 23.728-16.365 43.115-37.692 54.155-62.645 54.739 22.205 91.498 63.272 91.498 110.286 0 42.186-29.558 79.498-75.09 102.828 23.46 49.216 75.09 101.709 75.09 101.709s-115.837-38.35-154.424-78.46c-9.956 1.12-20.297 1.758-30.793 1.758-88.727 0-162.927-43.071-181.007-100.61z"/><path d="M383.371 132.502c0 70.603-82.961 127.787-185.216 127.787-10.496 0-20.837-.639-30.793-1.757-38.587 40.093-154.424 78.429-154.424 78.429s51.63-52.472 75.09-101.67c-45.532-23.321-75.09-60.619-75.09-102.79C12.938 61.9 95.9 4.716 198.155 4.716 300.41 4.715 383.37 61.9 383.37 132.502z" /></svg></span><a href="https://www.pagetable.com/?p=1795#respond">Leave a comment</a></span> 		</footer>
			</div>
</article>
<article id="post-1792" class="post-1792 post type-post status-publish format-standard hentry category-c64 category-commodore" itemtype="https://schema.org/CreativeWork" itemscope>
	<div class="inside-article">
					<header class="entry-header">
				<h2 class="entry-title" itemprop="headline"><a href="https://www.pagetable.com/?p=1792" rel="bookmark">Brotkastenfreunde Interview</a></h2>		<div class="entry-meta">
			<span class="posted-on"><time class="entry-date published" datetime="2025-05-04T14:58:02+02:00" itemprop="datePublished">2025-05-04</time></span> <span class="byline">by <span class="author vcard" itemprop="author" itemtype="https://schema.org/Person" itemscope><a class="url fn n" href="https://www.pagetable.com/?author=1" title="View all posts by Michael Steil" rel="author" itemprop="url"><span class="author-name" itemprop="name">Michael Steil</span></a></span></span> 		</div>
					</header>
			
			<div class="entry-summary" itemprop="text">
				<!-- Begin :: Generated by Easy Custom Auto Excerpt --><div class="ecae" style=""><p>In <a href="https://sgs6bw.podcaster.de/brotkastenfreunde/brotkastenfreunde-017-interview-mit-michael-steil/">Folge 017</a> des C64-Podcasts Brotkastenfreunde bin ich diesmal Gast.</p></div><!-- End :: Generated by Easy Custom Auto Excerpt -->			</div>

				<footer class="entry-meta" aria-label="Entry meta">
			<span class="cat-links"><span class="gp-icon icon-categories"><svg viewBox="0 0 512 512" aria-hidden="true" xmlns="http://www.w3.org/2000/svg" width="1em" height="1em"><path d="M0 112c0-26.51 21.49-48 48-48h110.014a48 48 0 0143.592 27.907l12.349 26.791A16 16 0 00228.486 128H464c26.51 0 48 21.49 48 48v224c0 26.51-21.49 48-48 48H48c-26.51 0-48-21.49-48-48V112z" /></svg></span><span class="screen-reader-text">Categories </span><a href="https://www.pagetable.com/?cat=41" rel="category">C64</a>, <a href="https://www.pagetable.com/?cat=8" rel="category">Commodore</a></span> <span class="comments-link"><span class="gp-icon icon-comments"><svg viewBox="0 0 512 512" aria-hidden="true" xmlns="http://www.w3.org/2000/svg" width="1em" height="1em"><path d="M132.838 329.973a435.298 435.298 0 0016.769-9.004c13.363-7.574 26.587-16.142 37.419-25.507 7.544.597 15.27.925 23.098.925 54.905 0 105.634-15.311 143.285-41.28 23.728-16.365 43.115-37.692 54.155-62.645 54.739 22.205 91.498 63.272 91.498 110.286 0 42.186-29.558 79.498-75.09 102.828 23.46 49.216 75.09 101.709 75.09 101.709s-115.837-38.35-154.424-78.46c-9.956 1.12-20.297 1.758-30.793 1.758-88.727 0-162.927-43.071-181.007-100.61z"/><path d="M383.371 132.502c0 70.603-82.961 127.787-185.216 127.787-10.496 0-20.837-.639-30.793-1.757-38.587 40.093-154.424 78.429-154.424 78.429s51.63-52.472 75.09-101.67c-45.532-23.321-75.09-60.619-75.09-102.79C12.938 61.9 95.9 4.716 198.155 4.716 300.41 4.715 383.37 61.9 383.37 132.502z" /></svg></span><a href="https://www.pagetable.com/?p=1792#comments">2 Comments</a></span> 		</footer>
			</div>
</article>
<article id="post-1788" class="post-1788 post type-post status-publish format-standard hentry category-archeology category-c64 category-literature" itemtype="https://schema.org/CreativeWork" itemscope>
	<div class="inside-article">
					<header class="entry-header">
				<h2 class="entry-title" itemprop="headline"><a href="https://www.pagetable.com/?p=1788" rel="bookmark">Das Titelbild vom 64&#8217;er Sonderheft 2/85</a></h2>		<div class="entry-meta">
			<span class="posted-on"><time class="entry-date published" datetime="2025-04-06T21:48:34+02:00" itemprop="datePublished">2025-04-06</time></span> <span class="byline">by <span class="author vcard" itemprop="author" itemtype="https://schema.org/Person" itemscope><a class="url fn n" href="https://www.pagetable.com/?author=1" title="View all posts by Michael Steil" rel="author" itemprop="url"><span class="author-name" itemprop="name">Michael Steil</span></a></span></span> 		</div>
					</header>
			
			<div class="entry-summary" itemprop="text">
				<!-- Begin :: Generated by Easy Custom Auto Excerpt --><div class="ecae" style=""><div class="ecae-image ecae-table-right"><div class='ecae-table-cell'><p>Am 25. März 1985 kam das zweite 64&#8217;er Sonderheft mit dem Thema <em>Abenteuerspiele</em> raus. Genau 40 Jahre später ist es nun <a href="https://www.64er-magazin.de/SH8502/">als HTML und PDF online verfügbar</a> – im Kontext des Projekts <a href="https://www.64er-magazin.de">64er-magazin.de</a>. Der Drachenreiter auf dem Original-Titelblatt ist der damals 18jährige <a href="http://www.dreisechzig.net">Boris Schneider-Johne</a> – wer genau schaut, wird auf der Website erkennen, dass wir das Bild aktualisiert haben:<span class="ecae-button ecae-buttonskin-none" style="text-align:left" >  <a class="ecae-link" href="https://www.pagetable.com/?p=1788"><span>read more</span></a></span></p></div></div><!-- End :: Generated by Easy Custom Auto Excerpt -->			</div>

				<footer class="entry-meta" aria-label="Entry meta">
			<span class="cat-links"><span class="gp-icon icon-categories"><svg viewBox="0 0 512 512" aria-hidden="true" xmlns="http://www.w3.org/2000/svg" width="1em" height="1em"><path d="M0 112c0-26.51 21.49-48 48-48h110.014a48 48 0 0143.592 27.907l12.349 26.791A16 16 0 00228.486 128H464c26.51 0 48 21.49 48 48v224c0 26.51-21.49 48-48 48H48c-26.51 0-48-21.49-48-48V112z" /></svg></span><span class="screen-reader-text">Categories </span><a href="https://www.pagetable.com/?cat=5" rel="category">Archeology</a>, <a href="https://www.pagetable.com/?cat=41" rel="category">C64</a>, <a href="https://www.pagetable.com/?cat=20" rel="category">Literature</a></span> <span class="comments-link"><span class="gp-icon icon-comments"><svg viewBox="0 0 512 512" aria-hidden="true" xmlns="http://www.w3.org/2000/svg" width="1em" height="1em"><path d="M132.838 329.973a435.298 435.298 0 0016.769-9.004c13.363-7.574 26.587-16.142 37.419-25.507 7.544.597 15.27.925 23.098.925 54.905 0 105.634-15.311 143.285-41.28 23.728-16.365 43.115-37.692 54.155-62.645 54.739 22.205 91.498 63.272 91.498 110.286 0 42.186-29.558 79.498-75.09 102.828 23.46 49.216 75.09 101.709 75.09 101.709s-115.837-38.35-154.424-78.46c-9.956 1.12-20.297 1.758-30.793 1.758-88.727 0-162.927-43.071-181.007-100.61z"/><path d="M383.371 132.502c0 70.603-82.961 127.787-185.216 127.787-10.496 0-20.837-.639-30.793-1.757-38.587 40.093-154.424 78.429-154.424 78.429s51.63-52.472 75.09-101.67c-45.532-23.321-75.09-60.619-75.09-102.79C12.938 61.9 95.9 4.716 198.155 4.716 300.41 4.715 383.37 61.9 383.37 132.502z" /></svg></span><a href="https://www.pagetable.com/?p=1788#comments">1 Comment</a></span> 		</footer>
			</div>
</article>
<article id="post-1764" class="post-1764 post type-post status-publish format-standard hentry category-2 category-c128 category-c64 category-commodore category-github category-literature category-vic-20" itemtype="https://schema.org/CreativeWork" itemscope>
	<div class="inside-article">
					<header class="entry-header">
				<h2 class="entry-title" itemprop="headline"><a href="https://www.pagetable.com/?p=1764" rel="bookmark">64&#039;er Magazin – mit 40 Jahren Verzögerung jetzt monatlich im Web</a></h2>		<div class="entry-meta">
			<span class="posted-on"><time class="entry-date published" datetime="2024-03-20T09:15:35+01:00" itemprop="datePublished">2024-03-20</time></span> <span class="byline">by <span class="author vcard" itemprop="author" itemtype="https://schema.org/Person" itemscope><a class="url fn n" href="https://www.pagetable.com/?author=1" title="View all posts by Michael Steil" rel="author" itemprop="url"><span class="author-name" itemprop="name">Michael Steil</span></a></span></span> 		</div>
					</header>
			
			<div class="entry-summary" itemprop="text">
				<!-- Begin :: Generated by Easy Custom Auto Excerpt --><div class="ecae" style=""><div class="ecae-image ecae-table-right"><div class='ecae-table-cell'><p>Zum 40jährigen Jubiläum des <em>64&#8217;er Magazins</em> präsentieren wir das Kunstprojekt <a href="https://www.64er-magazin.de">www.64er-magazin.de</a>: eine Website, die so tut, als wäre 1984. Exakt 40 Jahre nach der ursprünglichen Veröffentlichung erscheint hier jeden Monat eine neue Ausgabe:<span class="ecae-button ecae-buttonskin-none" style="text-align:left" >  <a class="ecae-link" href="https://www.pagetable.com/?p=1764"><span>read more</span></a></span></p></div></div><!-- End :: Generated by Easy Custom Auto Excerpt -->			</div>

				<footer class="entry-meta" aria-label="Entry meta">
			<span class="cat-links"><span class="gp-icon icon-categories"><svg viewBox="0 0 512 512" aria-hidden="true" xmlns="http://www.w3.org/2000/svg" width="1em" height="1em"><path d="M0 112c0-26.51 21.49-48 48-48h110.014a48 48 0 0143.592 27.907l12.349 26.791A16 16 0 00228.486 128H464c26.51 0 48 21.49 48 48v224c0 26.51-21.49 48-48 48H48c-26.51 0-48-21.49-48-48V112z" /></svg></span><span class="screen-reader-text">Categories </span><a href="https://www.pagetable.com/?cat=2" rel="category">6502</a>, <a href="https://www.pagetable.com/?cat=40" rel="category">C128</a>, <a href="https://www.pagetable.com/?cat=41" rel="category">C64</a>, <a href="https://www.pagetable.com/?cat=8" rel="category">Commodore</a>, <a href="https://www.pagetable.com/?cat=16" rel="category">GitHub</a>, <a href="https://www.pagetable.com/?cat=20" rel="category">Literature</a>, <a href="https://www.pagetable.com/?cat=34" rel="category">VIC-20</a></span> <span class="comments-link"><span class="gp-icon icon-comments"><svg viewBox="0 0 512 512" aria-hidden="true" xmlns="http://www.w3.org/2000/svg" width="1em" height="1em"><path d="M132.838 329.973a435.298 435.298 0 0016.769-9.004c13.363-7.574 26.587-16.142 37.419-25.507 7.544.597 15.27.925 23.098.925 54.905 0 105.634-15.311 143.285-41.28 23.728-16.365 43.115-37.692 54.155-62.645 54.739 22.205 91.498 63.272 91.498 110.286 0 42.186-29.558 79.498-75.09 102.828 23.46 49.216 75.09 101.709 75.09 101.709s-115.837-38.35-154.424-78.46c-9.956 1.12-20.297 1.758-30.793 1.758-88.727 0-162.927-43.071-181.007-100.61z"/><path d="M383.371 132.502c0 70.603-82.961 127.787-185.216 127.787-10.496 0-20.837-.639-30.793-1.757-38.587 40.093-154.424 78.429-154.424 78.429s51.63-52.472 75.09-101.67c-45.532-23.321-75.09-60.619-75.09-102.79C12.938 61.9 95.9 4.716 198.155 4.716 300.41 4.715 383.37 61.9 383.37 132.502z" /></svg></span><a href="https://www.pagetable.com/?p=1764#comments">13 Comments</a></span> 		</footer>
			</div>
</article>
<article id="post-1760" class="post-1760 post type-post status-publish format-standard hentry category-2 category-basic category-c64 category-commodore category-trivia" itemtype="https://schema.org/CreativeWork" itemscope>
	<div class="inside-article">
					<header class="entry-header">
				<h2 class="entry-title" itemprop="headline"><a href="https://www.pagetable.com/?p=1760" rel="bookmark">Silo S01E06: 38911 BYTES FREE</a></h2>		<div class="entry-meta">
			<span class="posted-on"><time class="entry-date published" datetime="2023-07-21T22:53:22+02:00" itemprop="datePublished">2023-07-21</time></span> <span class="byline">by <span class="author vcard" itemprop="author" itemtype="https://schema.org/Person" itemscope><a class="url fn n" href="https://www.pagetable.com/?author=1" title="View all posts by Michael Steil" rel="author" itemprop="url"><span class="author-name" itemprop="name">Michael Steil</span></a></span></span> 		</div>
					</header>
			
			<div class="entry-summary" itemprop="text">
				<!-- Begin :: Generated by Easy Custom Auto Excerpt --><div class="ecae" style=""><div class="ecae-image ecae-table-right"><div class='ecae-table-cell'>
<p><video width="100%" autoplay loop muted><source src="docs/silo_38911/silo_38911.mp4" type="video/mp4"></video></p></div></div><!-- End :: Generated by Easy Custom Auto Excerpt -->			</div>

				<footer class="entry-meta" aria-label="Entry meta">
			<span class="cat-links"><span class="gp-icon icon-categories"><svg viewBox="0 0 512 512" aria-hidden="true" xmlns="http://www.w3.org/2000/svg" width="1em" height="1em"><path d="M0 112c0-26.51 21.49-48 48-48h110.014a48 48 0 0143.592 27.907l12.349 26.791A16 16 0 00228.486 128H464c26.51 0 48 21.49 48 48v224c0 26.51-21.49 48-48 48H48c-26.51 0-48-21.49-48-48V112z" /></svg></span><span class="screen-reader-text">Categories </span><a href="https://www.pagetable.com/?cat=2" rel="category">6502</a>, <a href="https://www.pagetable.com/?cat=6" rel="category">BASIC</a>, <a href="https://www.pagetable.com/?cat=41" rel="category">C64</a>, <a href="https://www.pagetable.com/?cat=8" rel="category">Commodore</a>, <a href="https://www.pagetable.com/?cat=33" rel="category">Trivia</a></span> <span class="comments-link"><span class="gp-icon icon-comments"><svg viewBox="0 0 512 512" aria-hidden="true" xmlns="http://www.w3.org/2000/svg" width="1em" height="1em"><path d="M132.838 329.973a435.298 435.298 0 0016.769-9.004c13.363-7.574 26.587-16.142 37.419-25.507 7.544.597 15.27.925 23.098.925 54.905 0 105.634-15.311 143.285-41.28 23.728-16.365 43.115-37.692 54.155-62.645 54.739 22.205 91.498 63.272 91.498 110.286 0 42.186-29.558 79.498-75.09 102.828 23.46 49.216 75.09 101.709 75.09 101.709s-115.837-38.35-154.424-78.46c-9.956 1.12-20.297 1.758-30.793 1.758-88.727 0-162.927-43.071-181.007-100.61z"/><path d="M383.371 132.502c0 70.603-82.961 127.787-185.216 127.787-10.496 0-20.837-.639-30.793-1.757-38.587 40.093-154.424 78.429-154.424 78.429s51.63-52.472 75.09-101.67c-45.532-23.321-75.09-60.619-75.09-102.79C12.938 61.9 95.9 4.716 198.155 4.716 300.41 4.715 383.37 61.9 383.37 132.502z" /></svg></span><a href="https://www.pagetable.com/?p=1760#respond">Leave a comment</a></span> 		</footer>
			</div>
</article>
<article id="post-1753" class="post-1753 post type-post status-publish format-standard hentry category-archeology category-presentation" itemtype="https://schema.org/CreativeWork" itemscope>
	<div class="inside-article">
					<header class="entry-header">
				<h2 class="entry-title" itemprop="headline"><a href="https://www.pagetable.com/?p=1753" rel="bookmark">[Ankündigung] Vortrag &#8220;Apollo Guidance Computer&#8221; an der Embedded Computing Conference in Winterthur</a></h2>		<div class="entry-meta">
			<span class="posted-on"><time class="entry-date published" datetime="2023-05-16T14:44:05+02:00" itemprop="datePublished">2023-05-16</time></span> <span class="byline">by <span class="author vcard" itemprop="author" itemtype="https://schema.org/Person" itemscope><a class="url fn n" href="https://www.pagetable.com/?author=1" title="View all posts by Michael Steil" rel="author" itemprop="url"><span class="author-name" itemprop="name">Michael Steil</span></a></span></span> 		</div>
					</header>
			
			<div class="entry-summary" itemprop="text">
				<!-- Begin :: Generated by Easy Custom Auto Excerpt --><div class="ecae" style=""><div class="ecae-image ecae-table-right"><div class='ecae-table-cell'><p><em>This post is about an upcoming talk in German.</em><span class="ecae-button ecae-buttonskin-none" style="text-align:left" >  <a class="ecae-link" href="https://www.pagetable.com/?p=1753"><span>read more</span></a></span></p></div></div><!-- End :: Generated by Easy Custom Auto Excerpt -->			</div>

				<footer class="entry-meta" aria-label="Entry meta">
			<span class="cat-links"><span class="gp-icon icon-categories"><svg viewBox="0 0 512 512" aria-hidden="true" xmlns="http://www.w3.org/2000/svg" width="1em" height="1em"><path d="M0 112c0-26.51 21.49-48 48-48h110.014a48 48 0 0143.592 27.907l12.349 26.791A16 16 0 00228.486 128H464c26.51 0 48 21.49 48 48v224c0 26.51-21.49 48-48 48H48c-26.51 0-48-21.49-48-48V112z" /></svg></span><span class="screen-reader-text">Categories </span><a href="https://www.pagetable.com/?cat=5" rel="category">Archeology</a>, <a href="https://www.pagetable.com/?cat=25" rel="category">Presentation</a></span> <span class="comments-link"><span class="gp-icon icon-comments"><svg viewBox="0 0 512 512" aria-hidden="true" xmlns="http://www.w3.org/2000/svg" width="1em" height="1em"><path d="M132.838 329.973a435.298 435.298 0 0016.769-9.004c13.363-7.574 26.587-16.142 37.419-25.507 7.544.597 15.27.925 23.098.925 54.905 0 105.634-15.311 143.285-41.28 23.728-16.365 43.115-37.692 54.155-62.645 54.739 22.205 91.498 63.272 91.498 110.286 0 42.186-29.558 79.498-75.09 102.828 23.46 49.216 75.09 101.709 75.09 101.709s-115.837-38.35-154.424-78.46c-9.956 1.12-20.297 1.758-30.793 1.758-88.727 0-162.927-43.071-181.007-100.61z"/><path d="M383.371 132.502c0 70.603-82.961 127.787-185.216 127.787-10.496 0-20.837-.639-30.793-1.757-38.587 40.093-154.424 78.429-154.424 78.429s51.63-52.472 75.09-101.67c-45.532-23.321-75.09-60.619-75.09-102.79C12.938 61.9 95.9 4.716 198.155 4.716 300.41 4.715 383.37 61.9 383.37 132.502z" /></svg></span><a href="https://www.pagetable.com/?p=1753#comments">2 Comments</a></span> 		</footer>
			</div>
</article>
		<nav id="nav-below" class="paging-navigation" aria-label="Archive Page">
								<div class="nav-previous">
						<span class="gp-icon icon-arrow"><svg viewBox="0 0 330 512" aria-hidden="true" xmlns="http://www.w3.org/2000/svg" width="1em" height="1em"><path d="M305.913 197.085c0 2.266-1.133 4.815-2.833 6.514L171.087 335.593c-1.7 1.7-4.249 2.832-6.515 2.832s-4.815-1.133-6.515-2.832L26.064 203.599c-1.7-1.7-2.832-4.248-2.832-6.514s1.132-4.816 2.832-6.515l14.162-14.163c1.7-1.699 3.966-2.832 6.515-2.832 2.266 0 4.815 1.133 6.515 2.832l111.316 111.317 111.316-111.317c1.7-1.699 4.249-2.832 6.515-2.832s4.815 1.133 6.515 2.832l14.162 14.163c1.7 1.7 2.833 4.249 2.833 6.515z" /></svg></span>						<span class="prev" title="Previous"><a href="https://www.pagetable.com/docs/1541rom/1541%20ROM%20disassembly.txt/?paged=2" >Older posts</a></span>
					</div>
					<div class="nav-links"><span aria-current="page" class="page-numbers current"><span class="screen-reader-text">Page</span>1</span>
<a class="page-numbers" href="https://www.pagetable.com/docs/1541rom/1541%20ROM%20disassembly.txt/?paged=2"><span class="screen-reader-text">Page</span>2</a>
<span class="page-numbers dots">&hellip;</span>
<a class="page-numbers" href="https://www.pagetable.com/docs/1541rom/1541%20ROM%20disassembly.txt/?paged=15"><span class="screen-reader-text">Page</span>15</a>
<a class="next page-numbers" href="https://www.pagetable.com/docs/1541rom/1541%20ROM%20disassembly.txt/?paged=2">Next <span aria-hidden="true">&rarr;</span></a></div>		</nav>
				</main>
	</div>

	<div class="widget-area sidebar is-right-sidebar" id="right-sidebar">
	<div class="inside-right-sidebar">
		<aside id="block-2" class="widget inner-padding widget_block widget_search"><form role="search" method="get" action="https://www.pagetable.com/" class="wp-block-search__button-outside wp-block-search__text-button wp-block-search"    ><label class="wp-block-search__label" for="wp-block-search__input-1" >Search</label><div class="wp-block-search__inside-wrapper" ><input class="wp-block-search__input" id="wp-block-search__input-1" placeholder="" value="" type="search" name="s" required /><button aria-label="Search" class="wp-block-search__button wp-element-button" type="submit" >Search</button></div></form></aside><aside id="block-8" class="widget inner-padding widget_block">Mastodon:<br/><a rel="me" href="https://mastodon.social/@pagetable">@pagetable@mastodon.social</a>
<br/><br/>
GitHub:<br/><a href="https://github.com/mist64">github.com/mist64</a></aside><aside id="meta-2" class="widget inner-padding widget_meta"><h2 class="widget-title">Meta</h2>
		<ul>
						<li><a href="https://www.pagetable.com/wp-login.php">Log in</a></li>
			<li><a href="https://www.pagetable.com/?feed=rss2">Entries feed</a></li>
			<li><a href="https://www.pagetable.com/?feed=comments-rss2">Comments feed</a></li>

			<li><a href="https://wordpress.org/">WordPress.org</a></li>
		</ul>

		</aside><aside id="block-4" class="widget inner-padding widget_block">
<div class="wp-block-group"><div class="wp-block-group__inner-container is-layout-flow wp-block-group-is-layout-flow">
<h2 class="wp-block-heading">Recent Comments</h2>

<ol class="wp-block-latest-comments"><li class="wp-block-latest-comments__comment"><article><footer class="wp-block-latest-comments__comment-meta"><a class="wp-block-latest-comments__comment-author" href="https://www.pallawi.com/mumbai-airport-escorts.html">Mumbai Airport Escorts</a> on <a class="wp-block-latest-comments__comment-link" href="https://www.pagetable.com/?p=978#comment-112282">A Visual Defragmenter for the Commodore 64</a></footer></article></li><li class="wp-block-latest-comments__comment"><article><footer class="wp-block-latest-comments__comment-meta"><a class="wp-block-latest-comments__comment-author" href="https://www.ishasharma.net/">Mumbai model hot sexy Girls</a> on <a class="wp-block-latest-comments__comment-link" href="https://www.pagetable.com/?p=978#comment-112277">A Visual Defragmenter for the Commodore 64</a></footer></article></li><li class="wp-block-latest-comments__comment"><article><footer class="wp-block-latest-comments__comment-meta"><a class="wp-block-latest-comments__comment-author" href="https://www.pallawi.com/">Escort In mumbai</a> on <a class="wp-block-latest-comments__comment-link" href="https://www.pagetable.com/?p=978#comment-112275">A Visual Defragmenter for the Commodore 64</a></footer></article></li><li class="wp-block-latest-comments__comment"><article><footer class="wp-block-latest-comments__comment-meta"><a class="wp-block-latest-comments__comment-author" href="https://www.aditiraut.com/">Mumbai Escorts Services</a> on <a class="wp-block-latest-comments__comment-link" href="https://www.pagetable.com/?p=978#comment-112274">A Visual Defragmenter for the Commodore 64</a></footer></article></li><li class="wp-block-latest-comments__comment"><article><footer class="wp-block-latest-comments__comment-meta"><a class="wp-block-latest-comments__comment-author" href="https://www.seona.in/">Escorts In Mumbai</a> on <a class="wp-block-latest-comments__comment-link" href="https://www.pagetable.com/?p=978#comment-112273">A Visual Defragmenter for the Commodore 64</a></footer></article></li></ol></div></div>
</aside>	</div>
</div>

	</div>
</div>

<div class="site-footer">
			<footer class="site-info" aria-label="Site"  itemtype="https://schema.org/WPFooter" itemscope>
			<div class="inside-site-info grid-container">
								<div class="copyright-bar">
					<span class="copyright">&copy; 2026 pagetable.com</span> &bull; Built with <a href="https://generatepress.com" itemprop="url">GeneratePress</a>				</div>
			</div>
		</footer>
		</div>

<script id="generate-a11y">!function(){"use strict";if("querySelector"in document&&"addEventListener"in window){var e=document.body;e.addEventListener("mousedown",function(){e.classList.add("using-mouse")}),e.addEventListener("keydown",function(){e.classList.remove("using-mouse")})}}();</script><script id="generate-menu-js-extra">
var generatepressMenu = {"toggleOpenedSubMenus":"1","openSubMenuLabel":"Open Sub-Menu","closeSubMenuLabel":"Close Sub-Menu"};
//# sourceURL=generate-menu-js-extra
</script>
<script id="generate-menu-js" src="https://www.pagetable.com/wp-content/themes/generatepress/assets/js/menu.min.js?ver=3.5.1"></script>
<script id="wp-emoji-settings" type="application/json">
{"baseUrl":"https://s.w.org/images/core/emoji/17.0.2/72x72/","ext":".png","svgUrl":"https://s.w.org/images/core/emoji/17.0.2/svg/","svgExt":".svg","source":{"concatemoji":"https://www.pagetable.com/wp-includes/js/wp-emoji-release.min.js?ver=7.0"}}
</script>
<script type="module">
/*! This file is auto-generated */
const a=JSON.parse(document.getElementById("wp-emoji-settings").textContent),o=(window._wpemojiSettings=a,"wpEmojiSettingsSupports"),s=["flag","emoji"];function i(e){try{var t={supportTests:e,timestamp:(new Date).valueOf()};sessionStorage.setItem(o,JSON.stringify(t))}catch(e){}}function c(e,t,n){e.clearRect(0,0,e.canvas.width,e.canvas.height),e.fillText(t,0,0);t=new Uint32Array(e.getImageData(0,0,e.canvas.width,e.canvas.height).data);e.clearRect(0,0,e.canvas.width,e.canvas.height),e.fillText(n,0,0);const a=new Uint32Array(e.getImageData(0,0,e.canvas.width,e.canvas.height).data);return t.every((e,t)=>e===a[t])}function p(e,t){e.clearRect(0,0,e.canvas.width,e.canvas.height),e.fillText(t,0,0);var n=e.getImageData(16,16,1,1);for(let e=0;e<n.data.length;e++)if(0!==n.data[e])return!1;return!0}function u(e,t,n,a){switch(t){case"flag":return n(e,"\ud83c\udff3\ufe0f\u200d\u26a7\ufe0f","\ud83c\udff3\ufe0f\u200b\u26a7\ufe0f")?!1:!n(e,"\ud83c\udde8\ud83c\uddf6","\ud83c\udde8\u200b\ud83c\uddf6")&&!n(e,"\ud83c\udff4\udb40\udc67\udb40\udc62\udb40\udc65\udb40\udc6e\udb40\udc67\udb40\udc7f","\ud83c\udff4\u200b\udb40\udc67\u200b\udb40\udc62\u200b\udb40\udc65\u200b\udb40\udc6e\u200b\udb40\udc67\u200b\udb40\udc7f");case"emoji":return!a(e,"\ud83e\u1fac8")}return!1}function f(e,t,n,a){let r;const o=(r="undefined"!=typeof WorkerGlobalScope&&self instanceof WorkerGlobalScope?new OffscreenCanvas(300,150):document.createElement("canvas")).getContext("2d",{willReadFrequently:!0}),s=(o.textBaseline="top",o.font="600 32px Arial",{});return e.forEach(e=>{s[e]=t(o,e,n,a)}),s}function r(e){var t=document.createElement("script");t.src=e,t.defer=!0,document.head.appendChild(t)}a.supports={everything:!0,everythingExceptFlag:!0},new Promise(t=>{let n=function(){try{var e=JSON.parse(sessionStorage.getItem(o));if("object"==typeof e&&"number"==typeof e.timestamp&&(new Date).valueOf()<e.timestamp+604800&&"object"==typeof e.supportTests)return e.supportTests}catch(e){}return null}();if(!n){if("undefined"!=typeof Worker&&"undefined"!=typeof OffscreenCanvas&&"undefined"!=typeof URL&&URL.createObjectURL&&"undefined"!=typeof Blob)try{var e="postMessage("+f.toString()+"("+[JSON.stringify(s),u.toString(),c.toString(),p.toString()].join(",")+"));",a=new Blob([e],{type:"text/javascript"});const r=new Worker(URL.createObjectURL(a),{name:"wpTestEmojiSupports"});return void(r.onmessage=e=>{i(n=e.data),r.terminate(),t(n)})}catch(e){}i(n=f(s,u,c,p))}t(n)}).then(e=>{for(const n in e)a.supports[n]=e[n],a.supports.everything=a.supports.everything&&a.supports[n],"flag"!==n&&(a.supports.everythingExceptFlag=a.supports.everythingExceptFlag&&a.supports[n]);var t;a.supports.everythingExceptFlag=a.supports.everythingExceptFlag&&!a.supports.flag,a.supports.everything||((t=a.source||{}).concatemoji?r(t.concatemoji):t.wpemoji&&t.twemoji&&(r(t.twemoji),r(t.wpemoji)))});
//# sourceURL=https://www.pagetable.com/wp-includes/js/wp-emoji-loader.min.js
</script>

</body>
</html>
