johnnyegel/Pico1541/hardware/kicad/Pico1541v2/Pico1541v2-schematic.pdf

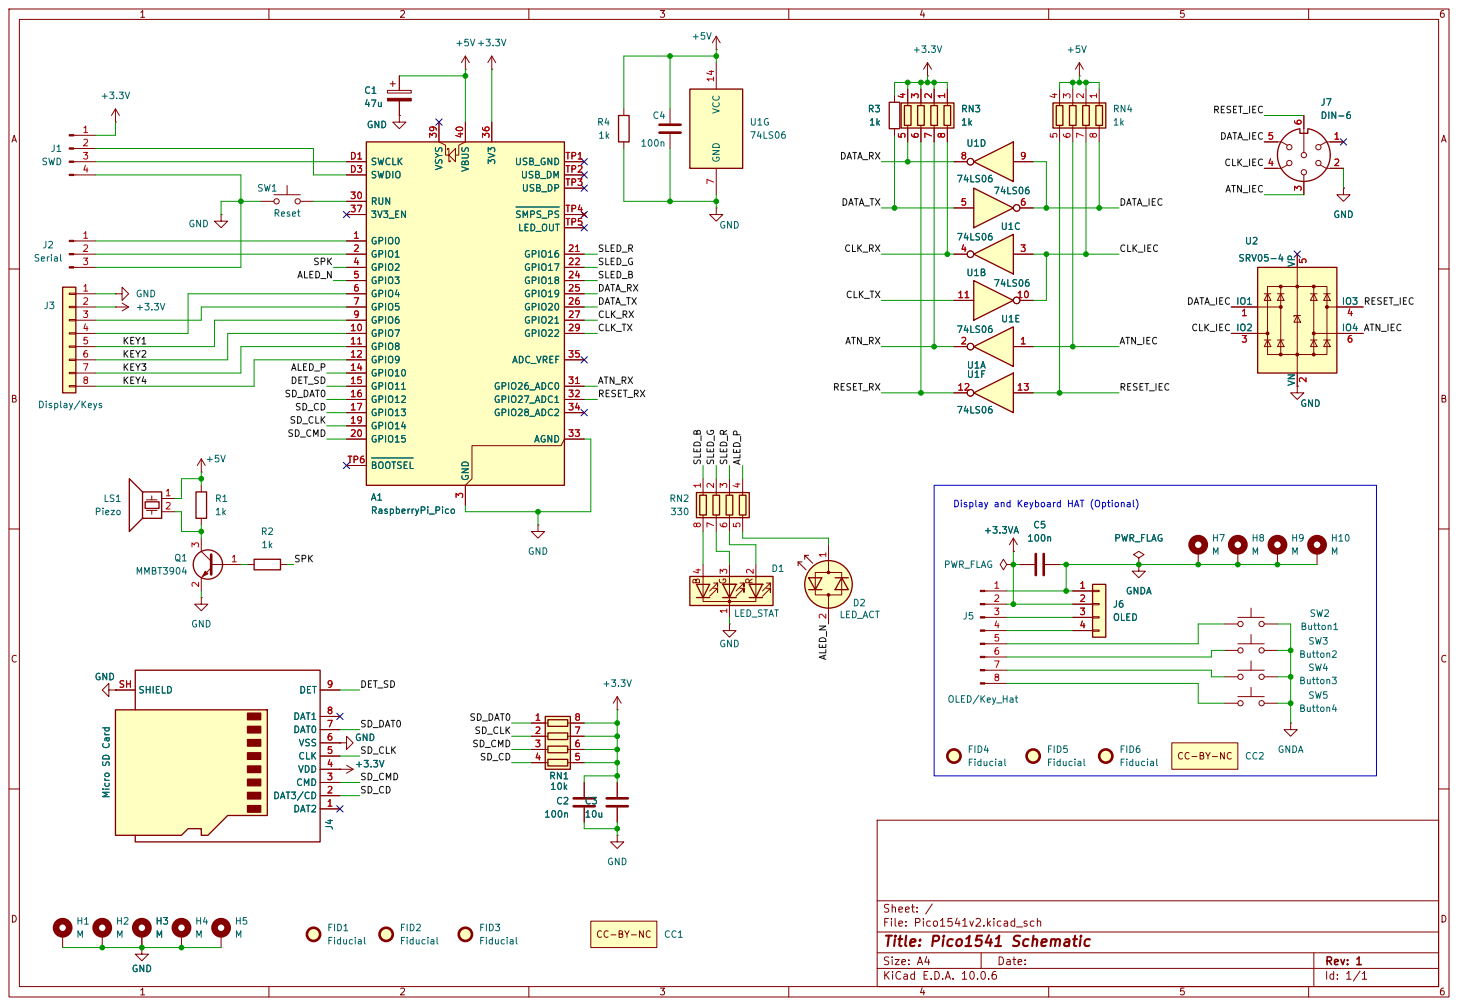
[picture p1: page 1]

Size: A4 | Rev: 1
KiCad E.D.A. 10.0.6 | Id: 1/1
