johnnyegel/Pico1541/hardware/kicad/Pico1541v2/Pico1541v2.pdf

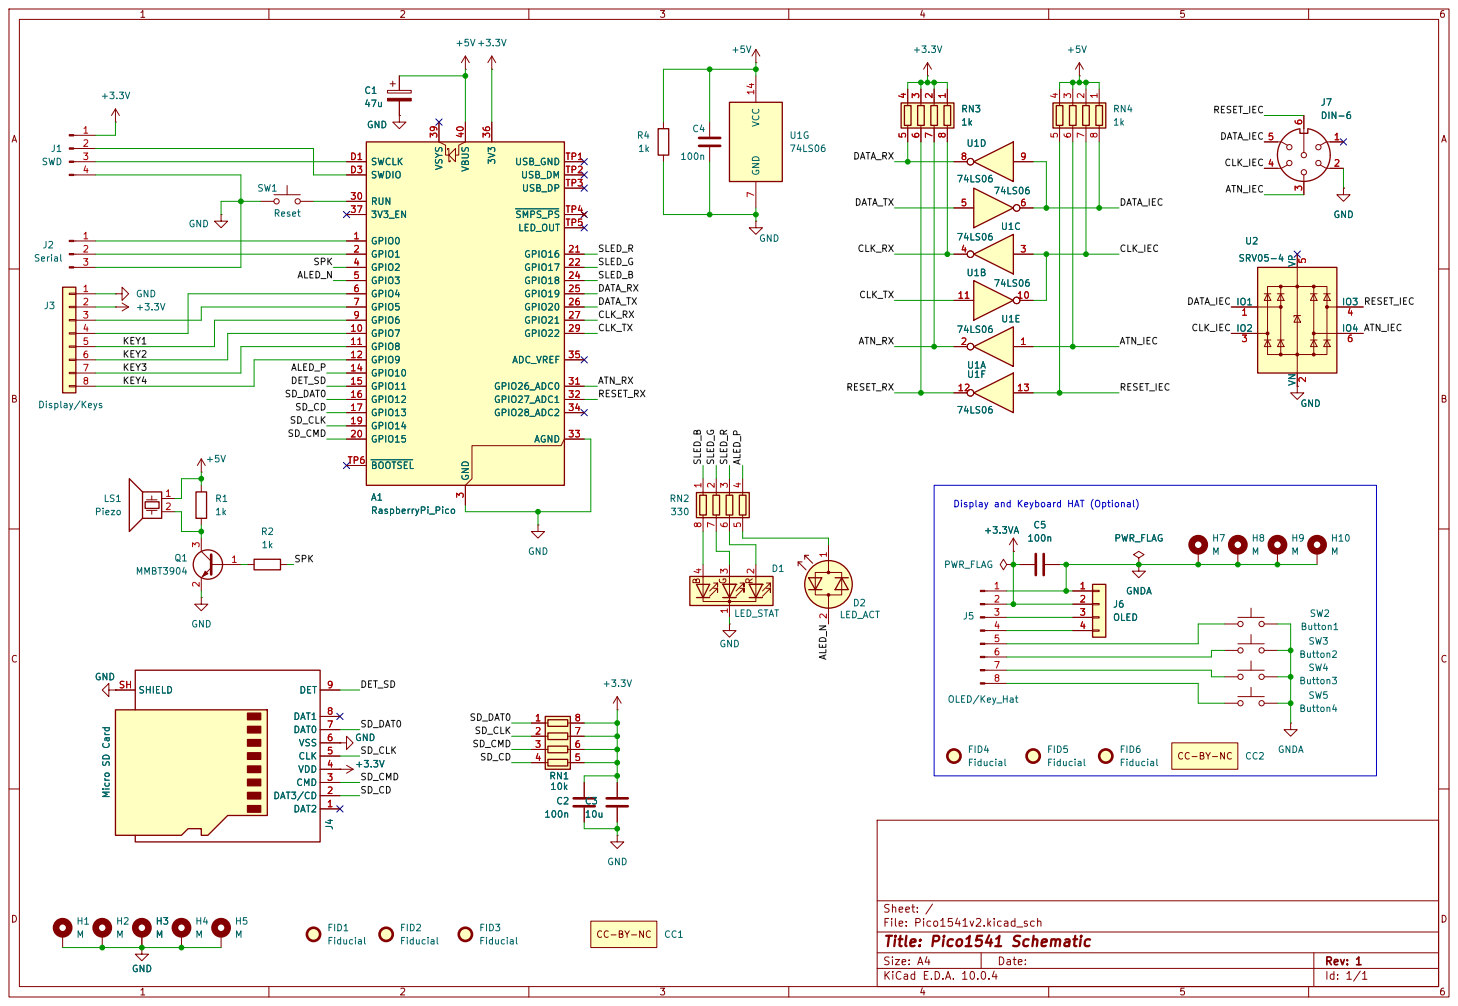
[picture p2: page 1]

Size: A4 | Rev: 1
KiCad E.D.A. 10.0.4 | Id: 1/1
