johnnyegel/Pico1541/hardware/kicad/Pico1541/Pico1541.pdf

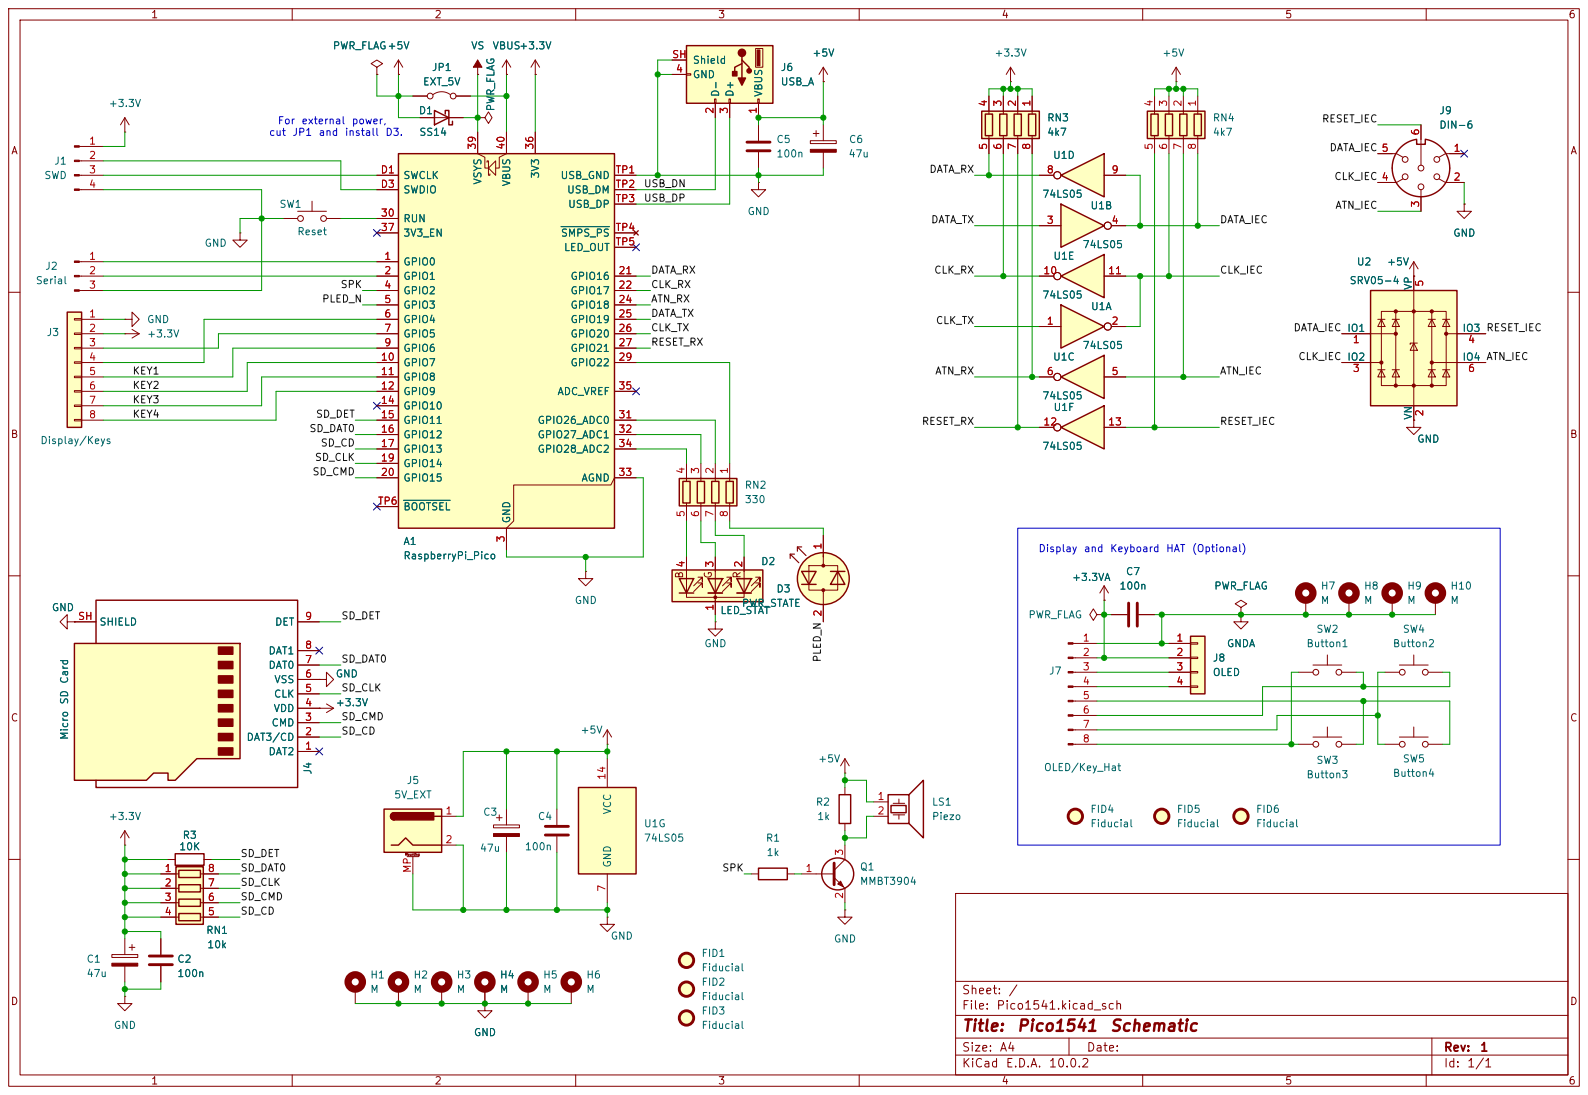
[picture p3: page 1]

3 3 | 10k 1 6 6
2 2 | 7 7

Size: A4 | Rev: 1
KiCad E.D.A. 10.0.2 | Id: 1/1
