johnnyegel/Pico1541/hardware/kicad/Pico1541/Pico1541-schematic.pdf

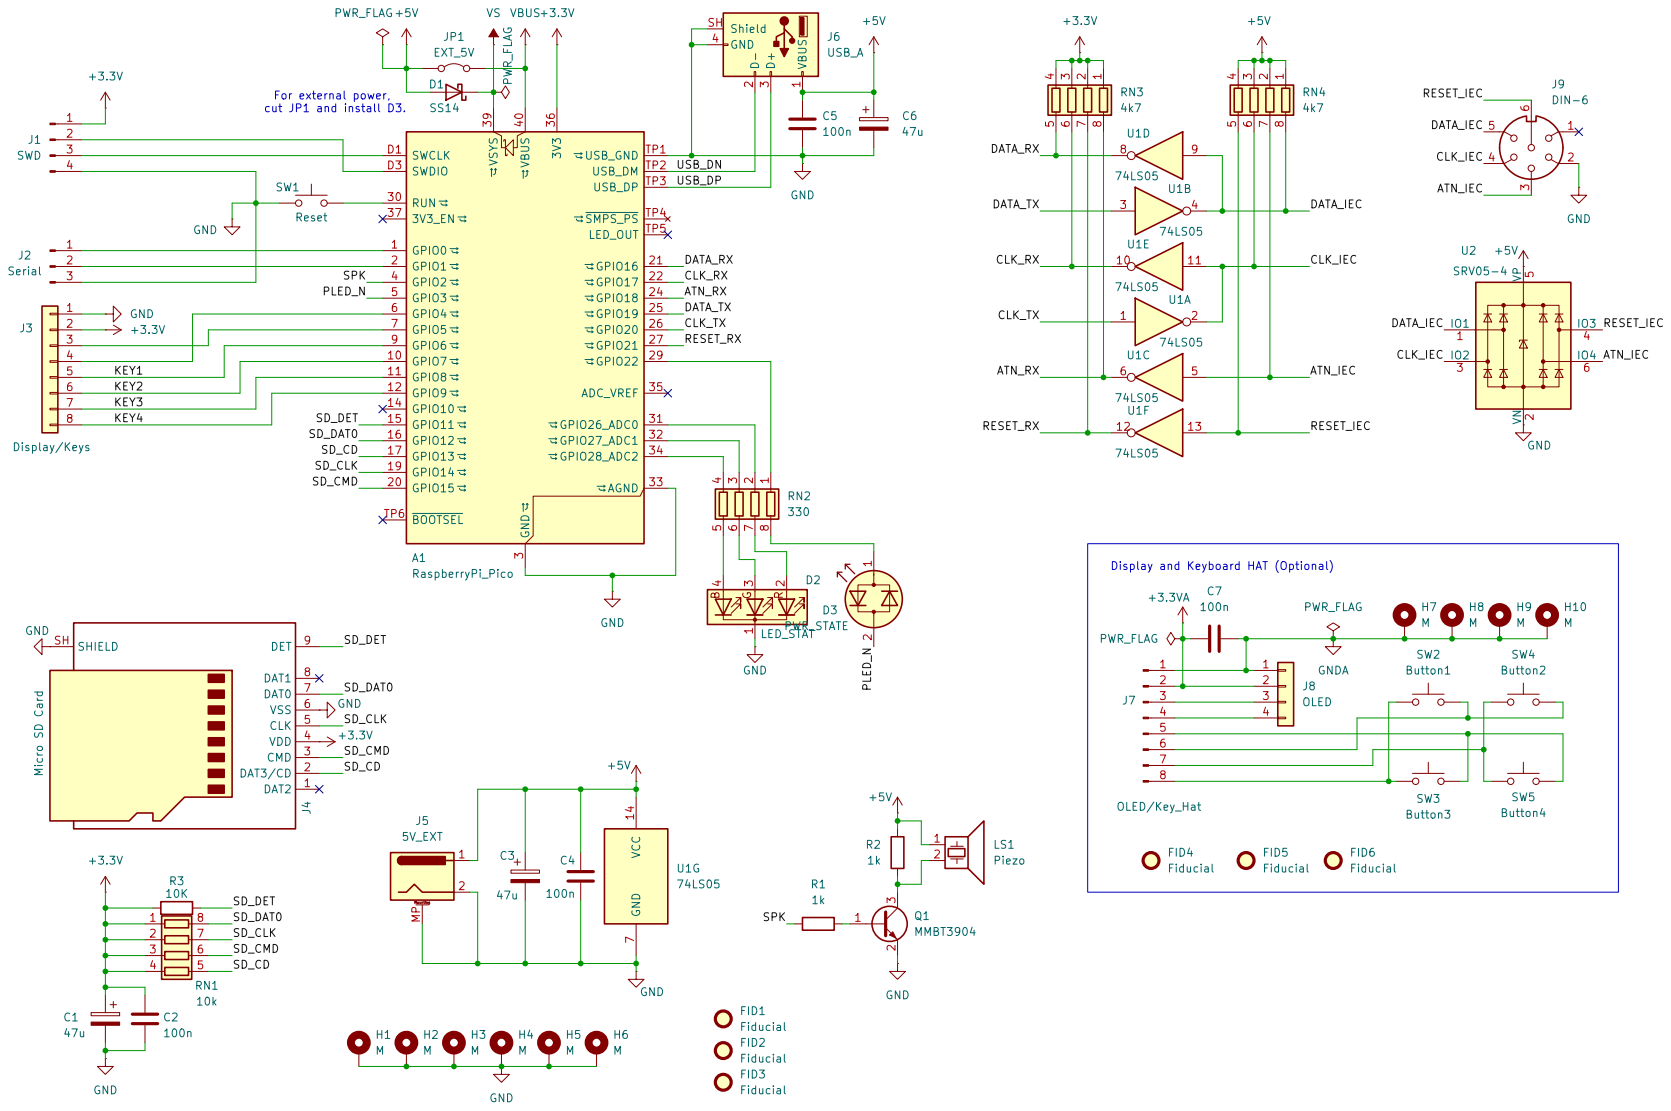
[picture p4: page 1]
