johnnyegel/Pico1541/hardware/kicad/Pico1541v2/Pico1541v2.kicad_pcb

## KiCad design hardware/kicad/Pico1541v2/Pico1541v2.kicad_pcb (2026-08-21)

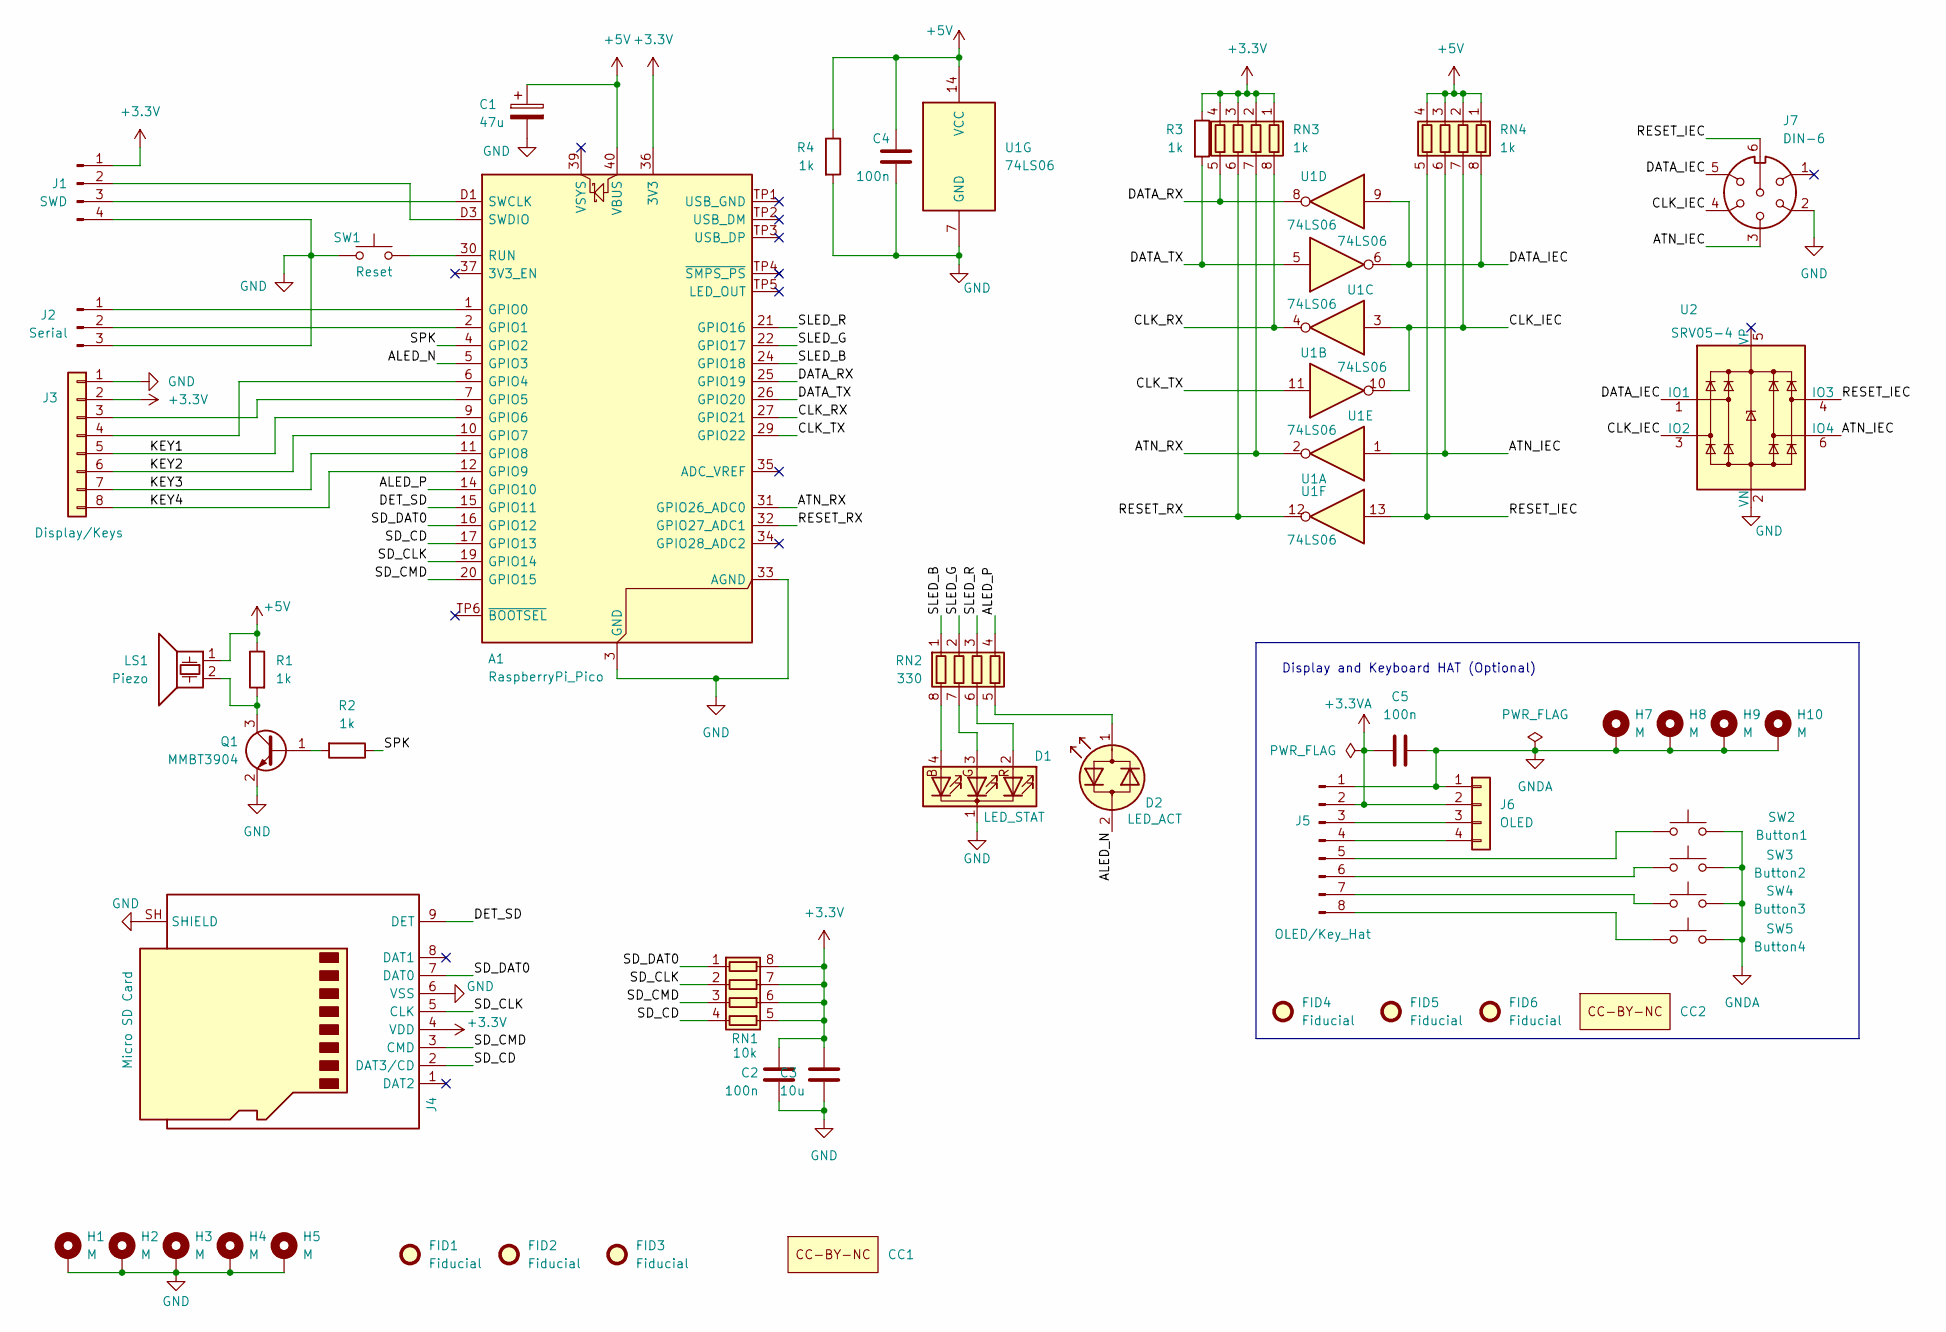
[picture p5: schematic Pico1541v2.kicad_sch, Pico1541 Schematic]

Parts:
A1: RaspberryPi_Pico; RaspberryPi_Pico_SMD
C1: 47u; CP_Elec_5x4.5
C2, C4, C5: 100n; C_0603_1608Metric_Pad1.08x0.95mm_HandSolder
C3: 10u; C_0603_1608Metric_Pad1.08x0.95mm_HandSolder
CC1, CC2: Symbol_CC-Noncommercial_CopperTop_Small
D1: LED_STAT; LED_D5.0mm-4_RGB_CorrectStaggered_Pins
D2: LED_ACT; LED_D5.0mm
FID1, FID2, FID3, FID4, FID5, FID6: Fiducial; Fiducial_1mm_Mask3mm
H1, H2, H3, H4, H5, H7, H8, H9, H10: M; MountingHole_2.5mm_Pad_Via
J1: SWD; PinHeader_1x04_P2.54mm_Vertical
J2: Serial; PinHeader_1x03_P2.54mm_Vertical
J3: Display/Keys; PinSocket_1x08_P2.54mm_Vertical
J4: Micro SD Card; MicroSD_HPJF
J5: OLED/Key_Hat; PinHeader_1x08_P2.54mm_Vertical
J6: OLED; PinSocket_1x04_P2.54mm_Vertical
J7: DIN-6; DIN-6-240deg
LS1: Piezo; PinSocket_1x02_P2.54mm_Vertical
Q1: MMBT3904; SOT-23
R1, R2, R3, R4: 1k; R_0603_1608Metric_Pad0.98x0.95mm_HandSolder
RN1: 10k; R_Array_Convex_4x0603
RN2: 330; R_Array_Convex_4x0603
RN3, RN4: 1k; R_Array_Convex_4x0603
SW1: Reset; SW_Tactile_SPST_Angled_PTS645Vx83-2LFS
SW2: Button1; SW_SPST_Omron_B3FS-100xP
SW3: Button2; SW_SPST_Omron_B3FS-100xP
SW4: Button3; SW_SPST_Omron_B3FS-100xP
SW5: Button4; SW_SPST_Omron_B3FS-100xP
U1: 74LS06; SO-14_3.9x8.65mm_P1.27mm
U2: SRV05-4; SOT-23-6

Connections:
+3.3V: A1.36 (3V3), C2.1, C3.1, J1.1, J3.2, J4.4 (VDD), R3.1, RN1.5 (R4.2), RN1.6 (R3.2), RN1.7 (R2.2), RN1.8 (R1.2), RN3.1 (R1.1), RN3.2 (R2.1), RN3.3 (R3.1), RN3.4 (R4.1)
+3.3VA: C5.1, J5.2, J6.2
+5V: A1.40 (VBUS), C1.1, C4.1, LS1.1, R1.1, R4.1, RN4.1 (R1.1), RN4.2 (R2.1), RN4.3 (R3.1), RN4.4 (R4.1), U1.14 (VCC)
/ALED_N: A1.5 (GPIO3), D2.2 (AK)
/ALED_P: A1.14 (GPIO10), RN2.4 (R4.1)
/ATN_IEC: J7.3, RN4.6 (R3.2), U1.1, U2.6 (IO4)
/ATN_RX: A1.31 (GPIO26_ADC0), RN3.7 (R2.2), U1.2
/CLK_IEC: J7.4, RN4.7 (R2.2), U1.3, U1.10, U2.3 (IO2)
/CLK_RX: A1.27 (GPIO21), RN3.8 (R1.2), U1.4
/CLK_TX: A1.29 (GPIO22), U1.11
/DATA_IEC: J7.5, RN4.8 (R1.2), U1.6, U1.9, U2.1 (IO1)
/DATA_RX: A1.25 (GPIO19), RN3.5 (R4.2), U1.8
/DATA_TX: A1.26 (GPIO20), R3.2, U1.5
/DET_SD: A1.15 (GPIO11), J4.9 (DET)
/KEY1: A1.9 (GPIO6), J3.5
/KEY2: A1.10 (GPIO7), J3.6
/KEY3: A1.11 (GPIO8), J3.7
/KEY4: A1.12 (GPIO9), J3.8
/RESET_IEC: J7.6, RN4.5 (R4.2), U1.13, U2.4 (IO3)
/RESET_RX: A1.32 (GPIO27_ADC1), RN3.6 (R3.2), U1.12
/SD_CD: A1.17 (GPIO13), J4.2 (DAT3/CD), RN1.4 (R4.1)
/SD_CLK: A1.19 (GPIO14), J4.5 (CLK), RN1.2 (R2.1)
/SD_CMD: A1.20 (GPIO15), J4.3 (CMD), RN1.3 (R3.1)
/SD_DAT0: A1.16 (GPIO12), J4.7 (DAT0), RN1.1 (R1.1)
/SLED_B: A1.24 (GPIO18), RN2.1 (R1.1)
/SLED_G: A1.22 (GPIO17), RN2.2 (R2.1)
/SLED_R: A1.21 (GPIO16), RN2.3 (R3.1)
/SPK: A1.4 (GPIO2), R2.1
GND: A1.3 (GND), A1.8 (GND), A1.13 (GND), A1.18 (GND), A1.23 (GND), A1.28 (GND), A1.33 (AGND), A1.38 (GND), A1.D2 (GND), C1.2, C2.2, C3.2, C4.2, D1.1 (K), H1.1 (1_1), H2.1 (1_1), H3.1 (1_1), H4.1 (1_1), H5.1 (1_1), J1.4, J2.3, J3.1, J4.6 (VSS), J4.SH (SHIELD), J7.2, Q1.2 (E), R4.2, SW1.1, U1.7 (GND), U2.2 (VN)
GNDA: C5.2, H7.1 (1_1), H8.1 (1_1), H9.1 (1_1), H10.1 (1_1), J5.1, J6.1, SW2.2, SW3.2, SW4.2, SW5.2
unnamed: A1.1 (GPIO0), J2.1
unnamed: A1.2 (GPIO1), J2.2
unnamed: A1.6 (GPIO4), J3.4
unnamed: A1.7 (GPIO5), J3.3
unnamed: A1.30 (RUN), SW1.2
unnamed: A1.D1 (SWCLK), J1.3
unnamed: A1.D3 (SWDIO), J1.2
unnamed: D1.4 (BA), RN2.8 (R1.2)
unnamed: D1.3 (GA), RN2.7 (R2.2)
unnamed: D1.2 (RA), RN2.6 (R3.2)
unnamed: D2.1 (KA), RN2.5 (R4.2)
unnamed: J5.3, J6.3
unnamed: J5.4, J6.4
unnamed: J5.5, SW2.1
unnamed: J5.6, SW3.1
unnamed: J5.7, SW4.1
unnamed: J5.8, SW5.1
unnamed: Q1.1 (B), R2.2
unnamed: LS1.2, Q1.3 (C), R1.2

Notes on the sheet:
Display and Keyboard HAT (Optional)

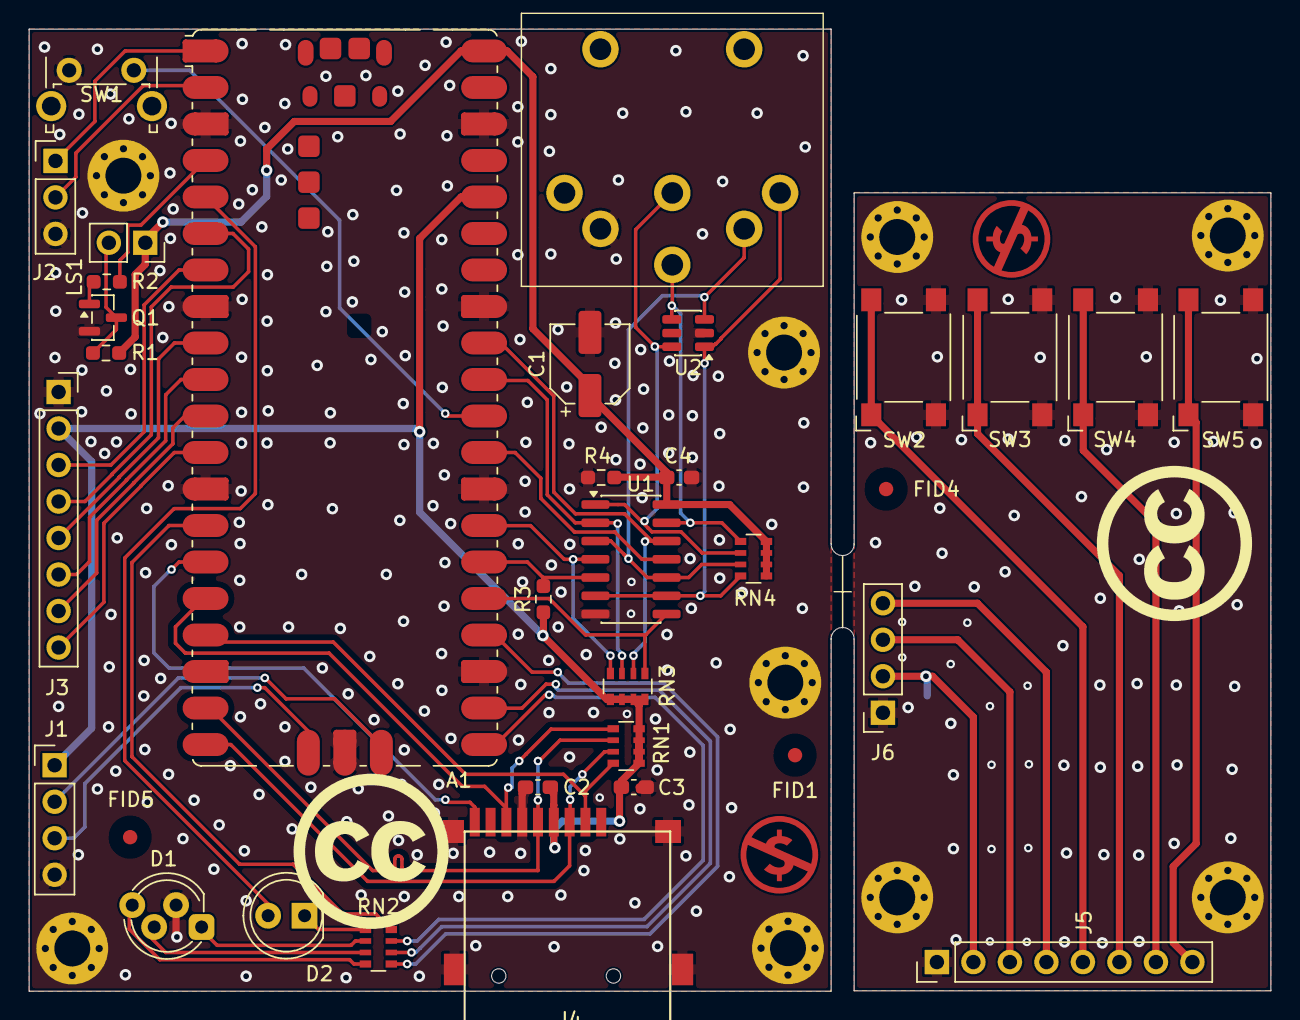
[picture p6: board Pico1541v2.kicad_pcb from above]

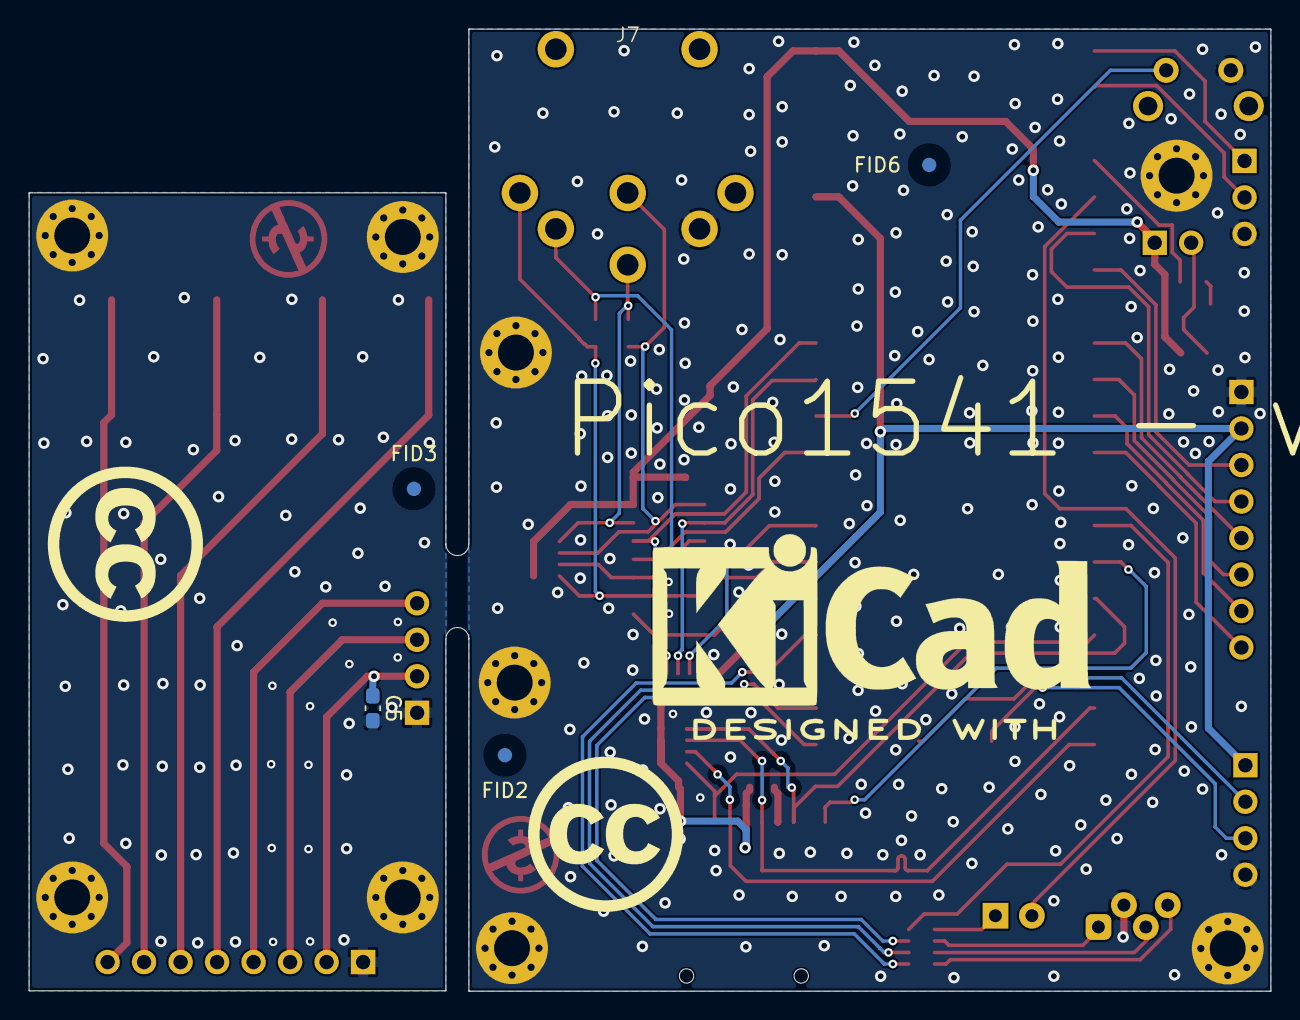
[picture p7: board Pico1541v2.kicad_pcb from below]

Board: 2 copper layers, 86.4 x 66.9 mm, 49 parts (4 on the bottom side), 49 nets.
