johnnyegel/Pico1541/hardware/kicad/Pico1541/Pico1541.kicad_pcb

## KiCad design hardware/kicad/Pico1541/Pico1541.kicad_pcb (2026-06-29)

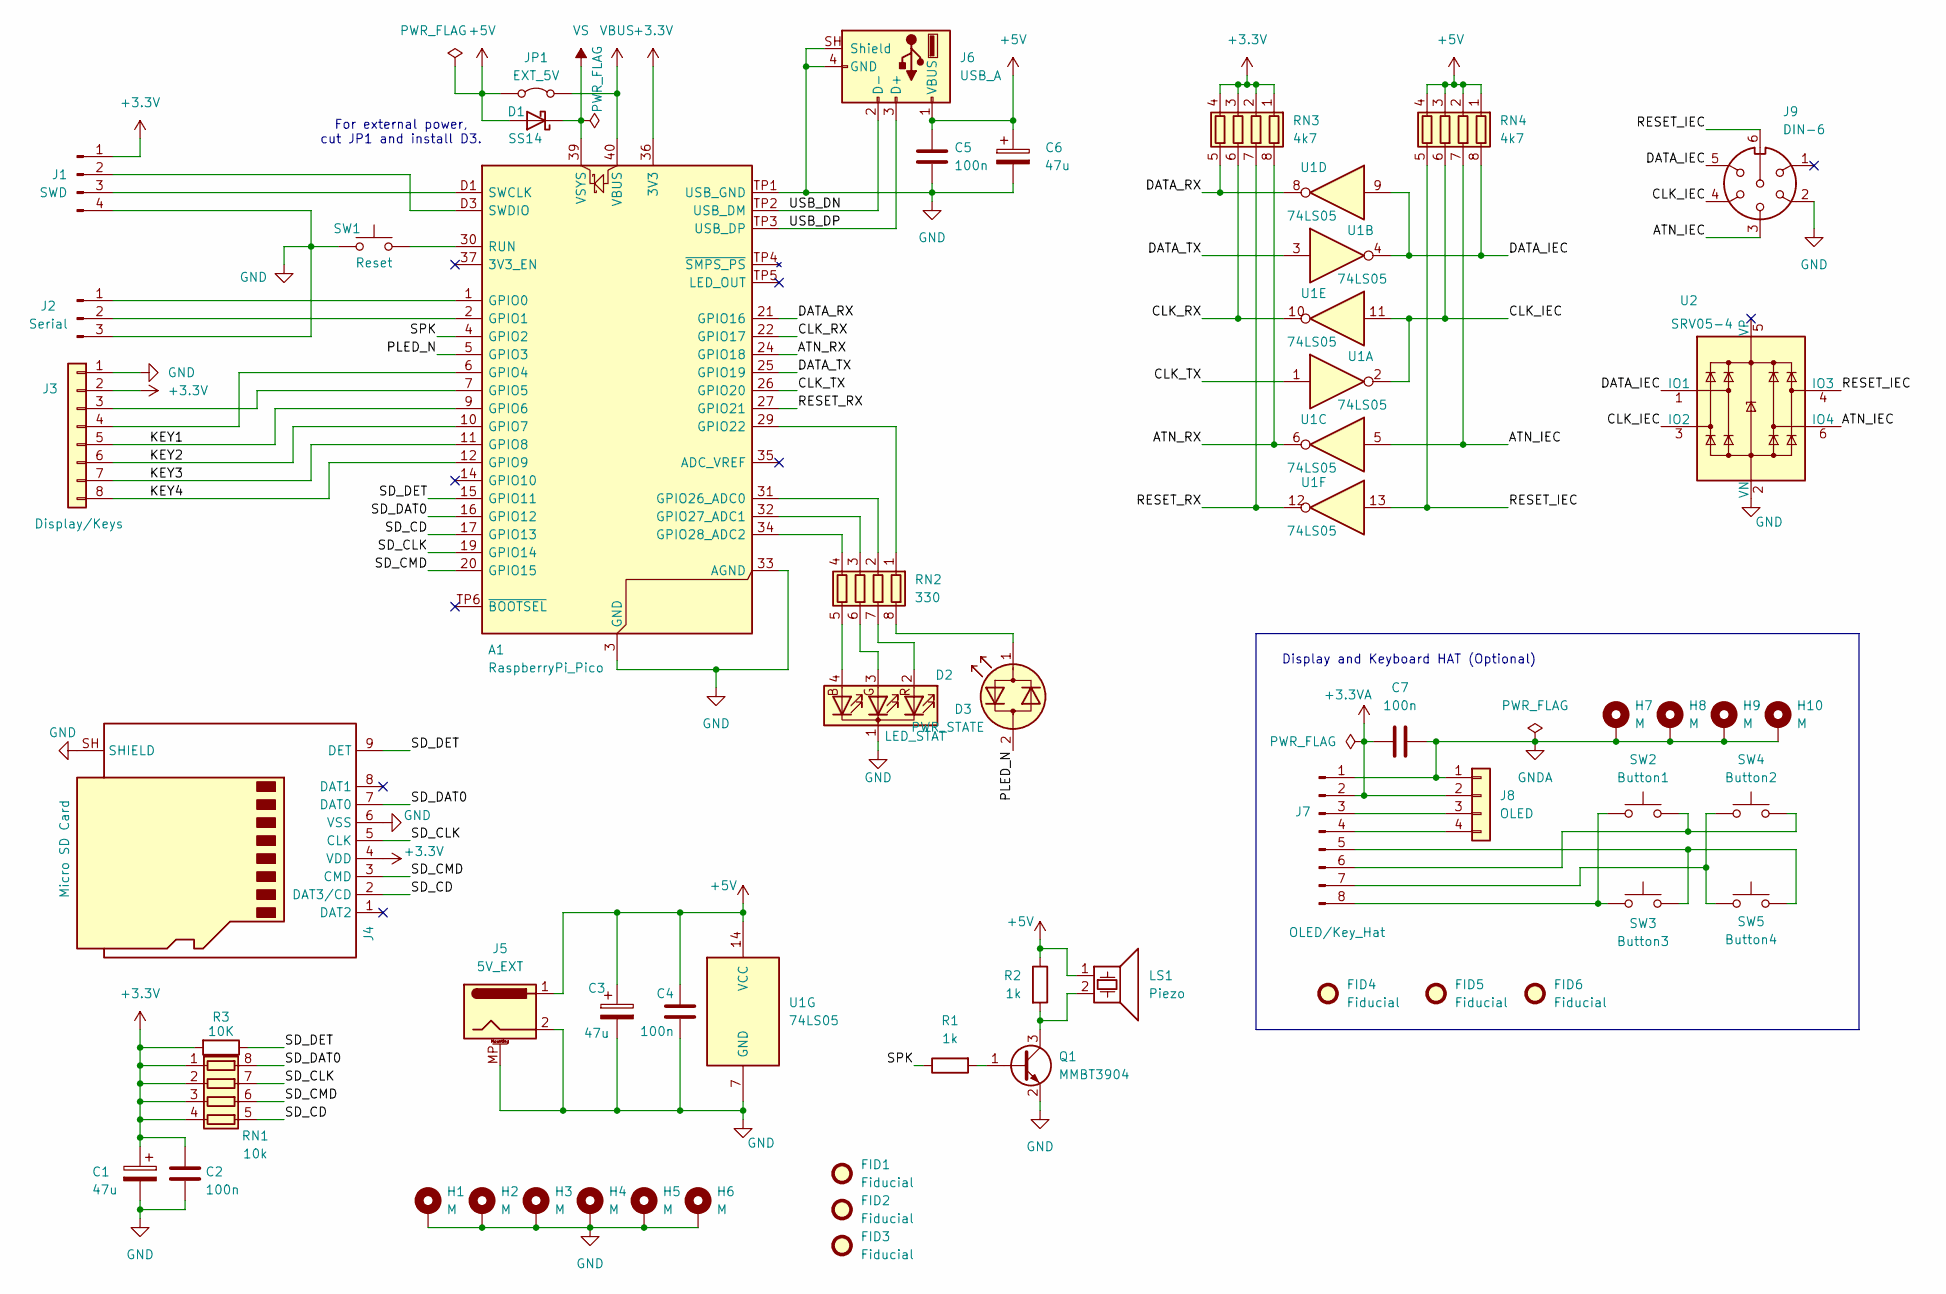
[picture p8: schematic Pico1541.kicad_sch, Pico1541 Schematic]

Parts:
A1: RaspberryPi_Pico; RaspberryPi_Pico_SMD
C1, C3, C6: 47u; CP_Elec_5x5.4
C2, C4, C5, C7: 100n; C_0603_1608Metric_Pad1.08x0.95mm_HandSolder
D1: SS14; D_SMA
D2: LED_STAT; LED_D5.0mm-4_RGB_CorrectStaggered_Pins
D3: PWR_STATE; LED_D5.0mm
FID1, FID2, FID3, FID4, FID5, FID6: Fiducial; Fiducial_1mm_Mask3mm
H1, H2, H3, H4, H5, H6, H7, H8, H9, H10: M; MountingHole_2.5mm_Pad_Via
J1: SWD; PinHeader_1x04_P2.54mm_Vertical
J2: Serial; PinHeader_1x03_P2.54mm_Vertical
J3: Display/Keys; PinSocket_1x08_P2.54mm_Vertical
J4: Micro SD Card; MicroSD_HPJF
J5: 5V_EXT; BarrelJack_CUI_PJ-063AH_Horizontal_CircularHoles
J6: USB_A; USB_A_Connfly_DS1095
J7: OLED/Key_Hat; PinHeader_1x08_P2.54mm_Vertical
J8: OLED; PinSocket_1x04_P2.54mm_Vertical
J9: DIN-6; DIN-6-240deg
JP1: EXT_5V; SolderJumper-2_P1.3mm_Bridged_RoundedPad1.0x1.5mm
LS1: Piezo; PinSocket_1x02_P2.54mm_Vertical
Q1: MMBT3904; SOT-23
R1, R2: 1k; R_0603_1608Metric_Pad0.98x0.95mm_HandSolder
R3: 10K; R_0603_1608Metric_Pad0.98x0.95mm_HandSolder
RN1: 10k; R_Array_Convex_4x0603
RN2: 330; R_Array_Convex_4x0603
RN3, RN4: 4k7; R_Array_Convex_4x0603
SW1: Reset; SW_Tactile_SPST_Angled_PTS645Vx83-2LFS
SW2: Button1; SW_SPST_EVPBF
SW3: Button3; SW_SPST_EVPBF
SW4: Button2; SW_SPST_EVPBF
SW5: Button4; SW_SPST_EVPBF
U1: 74LS05; SO-14_3.9x8.65mm_P1.27mm
U2: SRV05-4; SOT-23-6

Connections:
+3.3V: A1.36 (3V3), C1.1, C2.1, J1.1, J3.2, J4.4 (VDD), R3.2, RN1.1 (R1.1), RN1.2 (R2.1), RN1.3 (R3.1), RN1.4 (R4.1), RN3.1 (R1.1), RN3.2 (R2.1), RN3.3 (R3.1), RN3.4 (R4.1)
+3.3VA: C7.1, J7.2, J8.2
+5V: C3.1, C4.1, C5.1, C6.1, D1.2 (A), J5.1, J6.1 (VBUS), JP1.1 (A), LS1.1, R2.1, RN4.1 (R1.1), RN4.2 (R2.1), RN4.3 (R3.1), RN4.4 (R4.1), U1.14 (VCC)
/ATN_IEC: J9.3, RN4.7 (R2.2), U1.5, U2.6 (IO4)
/ATN_RX: A1.24 (GPIO18), RN3.8 (R1.2), U1.6
/CLK_IEC: J9.4, RN4.6 (R3.2), U1.2, U1.11, U2.3 (IO2)
/CLK_RX: A1.22 (GPIO17), RN3.6 (R3.2), U1.10
/CLK_TX: A1.26 (GPIO20), U1.1
/DATA_IEC: J9.5, RN4.8 (R1.2), U1.4, U1.9, U2.1 (IO1)
/DATA_RX: A1.21 (GPIO16), RN3.5 (R4.2), U1.8
/DATA_TX: A1.25 (GPIO19), U1.3
/KEY1: A1.9 (GPIO6), J3.5
/KEY2: A1.10 (GPIO7), J3.6
/KEY3: A1.11 (GPIO8), J3.7
/KEY4: A1.12 (GPIO9), J3.8
/PLED_N: A1.5 (GPIO3), D3.2 (AK)
/RESET_IEC: J9.6, RN4.5 (R4.2), U1.13, U2.4 (IO3)
/RESET_RX: A1.27 (GPIO21), RN3.7 (R2.2), U1.12
/SD_CD: A1.17 (GPIO13), J4.2 (DAT3/CD), RN1.5 (R4.2)
/SD_CLK: A1.19 (GPIO14), J4.5 (CLK), RN1.7 (R2.2)
/SD_CMD: A1.20 (GPIO15), J4.3 (CMD), RN1.6 (R3.2)
/SD_DAT0: A1.16 (GPIO12), J4.7 (DAT0), RN1.8 (R1.2)
/SD_DET: A1.15 (GPIO11), J4.9 (DET), R3.1
/SPK: A1.4 (GPIO2), R1.1
/USB_DN: A1.TP2 (USB_DM), J6.2 (D-)
/USB_DP: A1.TP3 (USB_DP), J6.3 (D+)
GND: A1.3 (GND), A1.8 (GND), A1.13 (GND), A1.18 (GND), A1.23 (GND), A1.28 (GND), A1.33 (AGND), A1.38 (GND), A1.D2 (GND), A1.TP1 (USB_GND), C1.2, C2.2, C3.2, C4.2, C5.2, C6.2, D2.1 (K), H1.1 (1_1), H2.1 (1_1), H3.1 (1_1), H4.1 (1_1), H5.1 (1_1), H6.1 (1_1), J1.4, J2.3, J3.1, J4.6 (VSS), J4.SH (SHIELD), J5.2, J5.MP (MountPin_MP), J6.4 (GND), J6.SH (Shield), J9.2, Q1.2 (E), SW1.1, U1.7 (GND), U2.2 (VN)
GNDA: C7.2, H7.1 (1_1), H8.1 (1_1), H9.1 (1_1), H10.1 (1_1), J7.1, J8.1
unnamed: A1.1 (GPIO0), J2.1
unnamed: A1.2 (GPIO1), J2.2
unnamed: A1.6 (GPIO4), J3.4
unnamed: A1.7 (GPIO5), J3.3
unnamed: A1.29 (GPIO22), RN2.1 (R1.1)
unnamed: A1.31 (GPIO26_ADC0), RN2.2 (R2.1)
unnamed: A1.32 (GPIO27_ADC1), RN2.3 (R3.1)
unnamed: A1.34 (GPIO28_ADC2), RN2.4 (R4.1)
unnamed: A1.30 (RUN), SW1.2
unnamed: A1.D1 (SWCLK), J1.3
unnamed: A1.D3 (SWDIO), J1.2
unnamed: D2.4 (BA), RN2.5 (R4.2)
unnamed: D2.3 (GA), RN2.6 (R3.2)
unnamed: D2.2 (RA), RN2.7 (R2.2)
unnamed: D3.1 (KA), RN2.8 (R1.2)
unnamed: J7.3, J8.3
unnamed: J7.4, J8.4
unnamed: J7.5, SW3.2, SW5.2
unnamed: J7.6, SW2.2, SW4.2
unnamed: J7.7, SW4.1, SW5.1
unnamed: J7.8, SW2.1, SW3.1
unnamed: Q1.1 (B), R1.2
unnamed: LS1.2, Q1.3 (C), R2.2
VBUS: A1.40 (VBUS), JP1.2 (B)
VS: A1.39 (VSYS), D1.1 (K)

Notes on the sheet:
For external power, cut JP1 and install D3.
Display and Keyboard HAT (Optional)

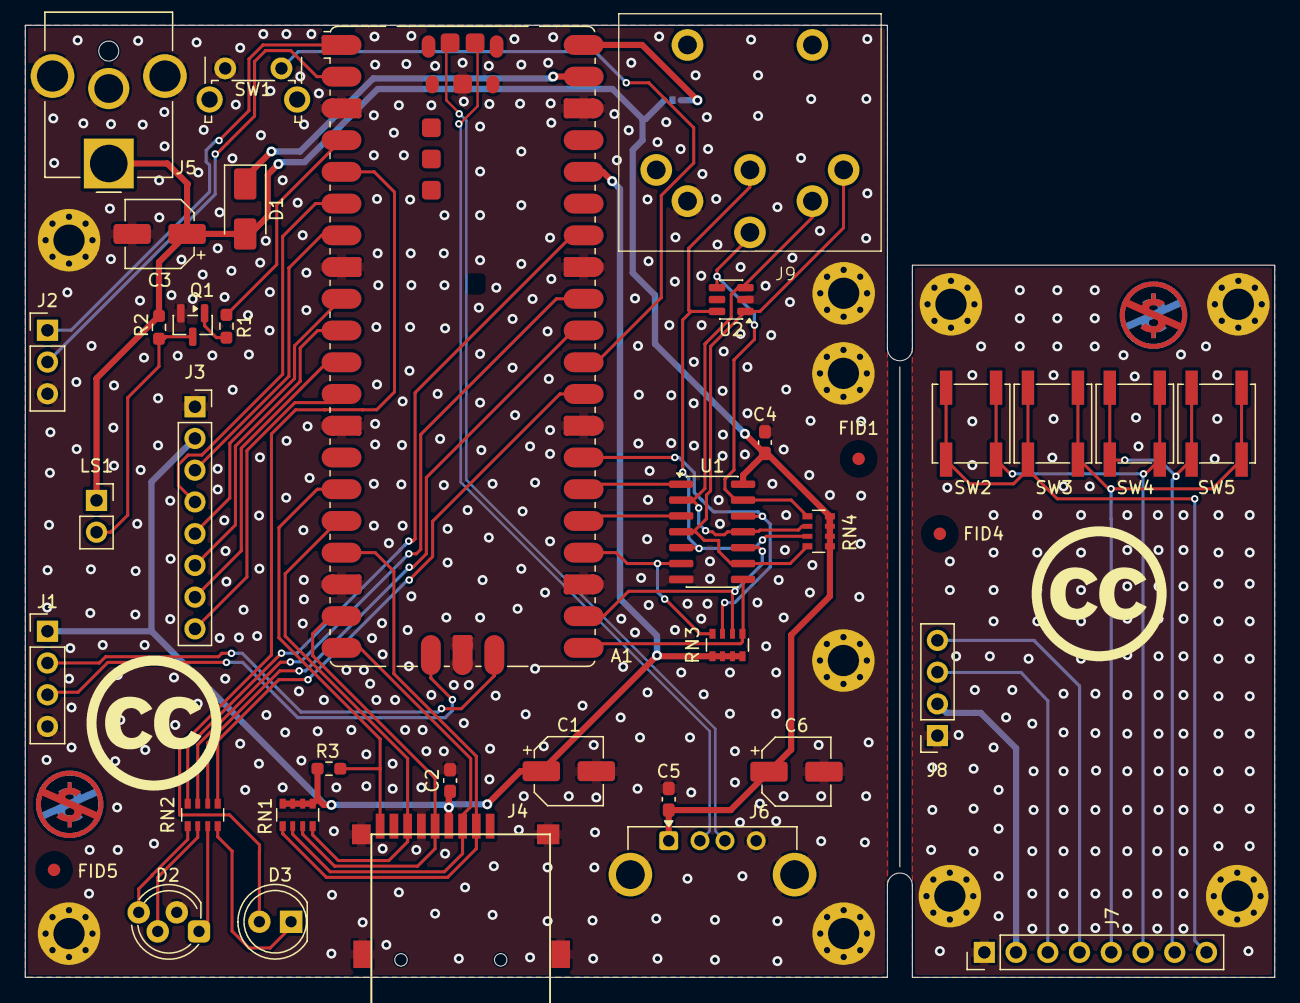
[picture p9: board Pico1541.kicad_pcb from above]

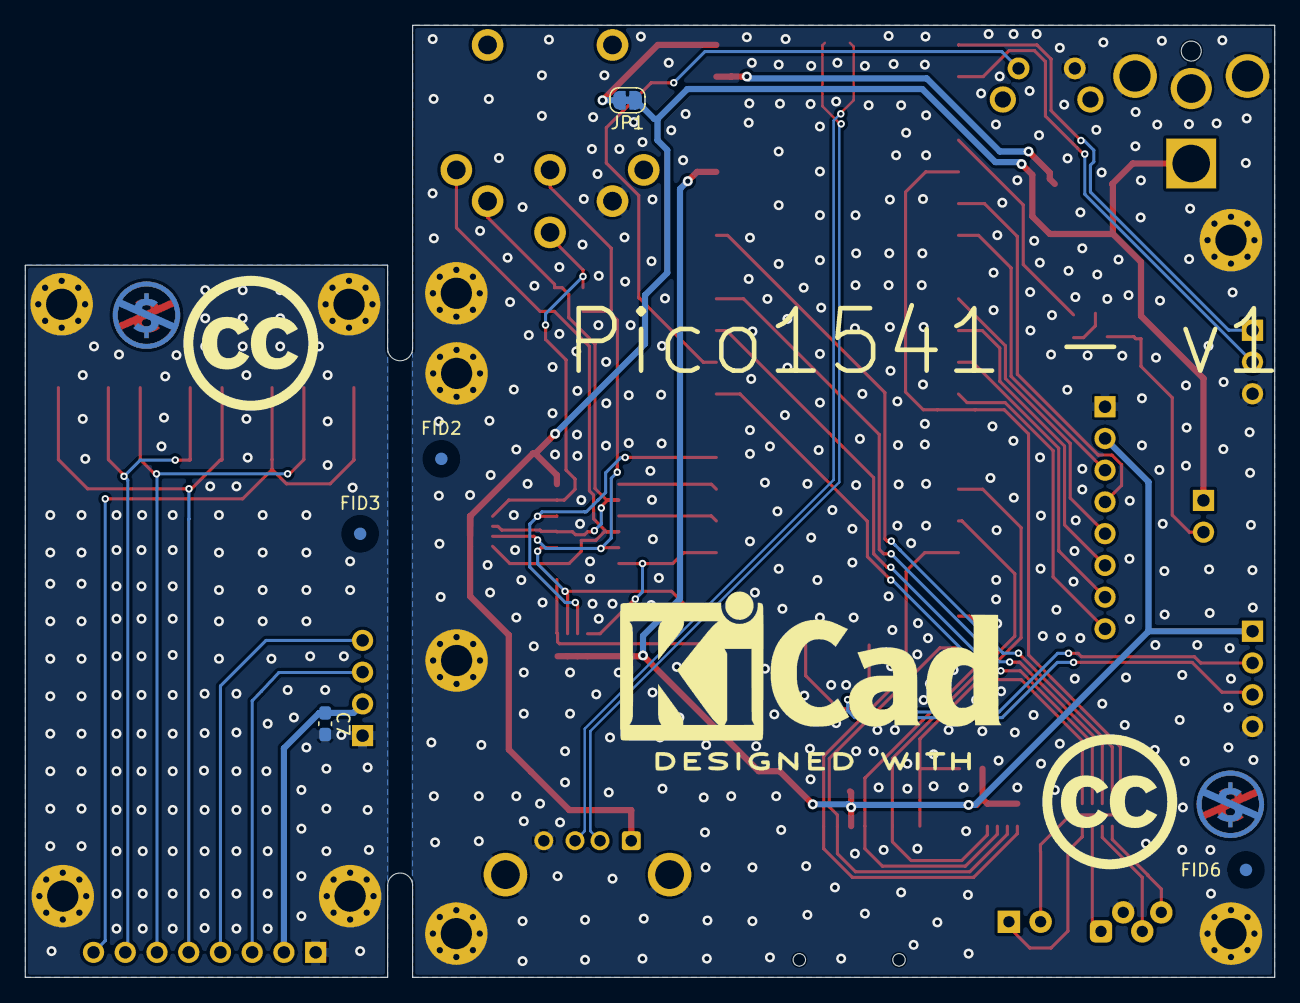
[picture p10: board Pico1541.kicad_pcb from below]

Board: 2 copper layers, 100.0 x 76.2 mm, 53 parts (5 on the bottom side), 53 nets.
