johnnyegel/Pico1541/crates/pico1541-emulator/src/drivemechanics.rs

use pico1541_common::track_buffer::{EmulatorHandle, TrackBuffer, TrackIdentifier};
use pico1541_common::{interface::HostInterface, magnetic_surface::MagneticSurface};

pub struct ReadHeadSignals {
    pub byte_opt: Option<u8>,
    pub is_sync: bool,
}

use crate::via6522::Via6522;

// The read head steps in half-track increments, so we represent the head position in half-tracks (0.5 track steps).
// We also keep a half-track position for the head, where Half-track 0 corresponds to Track 0,
// Half-track -2 corresponds to Track 0, Half-track 0 corresponds to Track 1, and so on.
// Track 18 (the directory track) then corresponds to Half-track 36 (2 * 18).
// NOTE! Min track is -2, which represent a non-existing Track 0. This accomodates the fact that
//       the head can be stepped outwards beyond Track 1.
const MIN_HALF_TRACK: i8 = -2;
const MAX_HALF_TRACK: i8 = 85; // Half-track 85 corresponds to Track 42.5, which is the maximum physical reach of the head on a 1541 drive.
const INITIAL_HALF_TRACK: i8 = 34; // Start at track 18 (Half-track 34)

/// DriveMechanics struct to represent the state of the drive's mechanical components, such as the head position and motor state.
pub struct DriveMechanics<S: MagneticSurface> {
    /// The Track the head is positioned over (not necessarily the track being read)
    pub halftrack_head_pos: i8,

    surface: S,
    pub track_handle: EmulatorHandle,
    pub current_identifier: TrackIdentifier,

    last_requested_sector: u8,
    last_active_index: u8,
}

impl<S: MagneticSurface> DriveMechanics<S> {
    pub fn new(surface: S, track_handle: EmulatorHandle) -> Self {
        track_handle.update_head_half_track(INITIAL_HALF_TRACK as u8);
        Self {
            halftrack_head_pos: INITIAL_HALF_TRACK,
            surface,
            track_handle,
            current_identifier: TrackIdentifier::void(),
            last_requested_sector: 255,
            last_active_index: 0,
        }
    }
}

impl<S: MagneticSurface> DriveMechanics<S> {
    #[link_section = ".core1_text"]
    #[inline(always)]
    pub fn surface_mut(&mut self) -> &mut S {
        &mut self.surface
    }

    pub fn reset(&mut self) {
        self.halftrack_head_pos = INITIAL_HALF_TRACK;
        self.current_identifier = TrackIdentifier::void();
        self.last_requested_sector = 0xFF;
        self.surface.set_motor_running(true, 0);
        pico1541_common::sound::notify_motor(true);
    }

    pub fn is_write_protected(&self) -> bool {
        self.track_handle.is_write_protected()
    }

    pub fn write_byte_at(&mut self, index: u32, data: u8) {
        self.track_handle.seek_to_byte(index);
        let expected_identifier = self.current_identifier;
        self.track_handle
            .next_write_byte(expected_identifier, 0xFF, data);
    }

    #[link_section = ".core1_text"]
    #[inline(always)]
    pub fn half_track(&self) -> u8 {
        // Do not expose the physical half-track outside the drive mechanics.
        self.halftrack_head_pos.clamp(0, MAX_HALF_TRACK) as u8
    }

    #[link_section = ".core1_text"]
    #[inline(always)]
    pub fn track_byte_pos_ix(&self) -> usize {
        self.surface.get_absolute_head_position(0) as usize
    }

    #[link_section = ".core1_text"]
    #[inline(always)]
    pub fn led_on(&self, via2: &Via6522) -> bool {
        (via2.get_pb_out() & pico1541_common::context::via::VIA2_MASK_ACTLED) != 0
    }

    #[link_section = ".core1_text"]
    #[inline(always)]
    pub fn motor_on(&self, via2: &Via6522) -> bool {
        (via2.get_pb_out() & pico1541_common::context::via::VIA2_MASK_MOTOR) != 0
    }

    #[link_section = ".core1_text"]
    #[inline(always)]
    pub fn advance_read_head(&mut self, elapsed: u32, master_clock: u32) -> ReadHeadSignals {
        self.check_active_index(master_clock);
        ReadHeadSignals {
            byte_opt: self.surface.try_read_byte(elapsed),
            is_sync: self.surface.is_sync_active(),
        }
    }

    #[link_section = ".core1_text"]
    #[inline(always)]
    pub fn advance_write_head(&mut self, elapsed: u32, master_clock: u32, byte: u8) {
        self.check_active_index(master_clock);
        // Writing ignores elapsed for time advancement because the surface time is driven by it.
        // Wait, the surface needs to advance by elapsed!
        // try_read_byte advances time. The write mode just advances time by `elapsed` cycles but doesn't output bytes.
        // Actually, try_read_byte is the only way to advance the surface time right now.
        // Let's use try_read_byte to advance time and just ignore the output byte.
        let _ = self.surface.try_read_byte(elapsed);
        let index = self.surface.get_absolute_head_position(0);
        self.write_byte_at(index, byte);
    }

    #[link_section = ".core1_text"]
    #[inline(always)]
    fn check_active_index(&mut self, master_clock: u32) {
        let current_active_index = self.track_handle.get_generation();
        if current_active_index != self.last_active_index {
            self.last_active_index = current_active_index;
            self.evaluate_track_source(master_clock);
        }
    }

    // ========== Internal helper functions ==================================================

    pub fn force_state_for_testing(&mut self, halftrack: u8, speed_zone: u8, master_clock: u32) {
        let new_track_identifier = TrackIdentifier::new(halftrack, speed_zone);
        self.halftrack_head_pos = halftrack as i8;
        self.track_handle.update_head_half_track(halftrack);
        self.surface.set_speed_zone(speed_zone);
        self.evaluate_track_identifier(new_track_identifier, master_clock);
    }

    /// Updates the drive mechanics state, and issues events accordingly.
    #[link_section = ".core1_text"]
    #[inline(always)]
    pub fn update_state<H: HostInterface>(
        &mut self,
        full_state: u8,
        last_state: u8,
        hardware: &mut H,
        master_clock: u32,
    ) {
        // :: Update stepper, motor and speed zones
        let state_changes = full_state ^ last_state;

        // :? Did speed-zone change? (PB5, PB6)
        if (state_changes & pico1541_common::context::via::VIA2_MASK_SPEED_ZONE) != 0 {
            // -> Yes, then update the speed zone and evaluate the track identifier.
            let speed_zone = (full_state & pico1541_common::context::via::VIA2_MASK_SPEED_ZONE)
                >> pico1541_common::context::via::VIA2_SHIFT_SPEED_ZONE;
            let new_track_identifier = self.current_identifier.with_speed_zone(speed_zone);
            self.surface.set_speed_zone(speed_zone);
            self.evaluate_track_identifier(new_track_identifier, master_clock);
        }

        // :? Did stepper motor phase change? (PB0, PB1)
        let is_track_step = state_changes & pico1541_common::context::via::VIA2_MASK_STEP != 0;
        if is_track_step {
            // -> Yes, then determine the direction and the next track position.
            let last_phase = last_state & pico1541_common::context::via::VIA2_MASK_STEP;
            let new_phase = full_state & pico1541_common::context::via::VIA2_MASK_STEP;
            let delta = (new_phase.wrapping_sub(last_phase)
                & pico1541_common::context::via::VIA2_MASK_STEP) as i8;

            let last_half_track_pos = self.halftrack_head_pos;
            let step: i8 = match delta {
                1 => 1,  // Step IN
                3 => -1, // Step OUT
                _ => 0,
            };

            let bumped = (step < 0 && last_half_track_pos <= MIN_HALF_TRACK)
                || (step > 0 && last_half_track_pos >= MAX_HALF_TRACK);

            pico1541_common::sound::notify_step(bumped);

            if step != 0 {
                self.halftrack_head_pos =
                    (last_half_track_pos + step).clamp(MIN_HALF_TRACK, MAX_HALF_TRACK);

                if self.halftrack_head_pos >= 0 && self.halftrack_head_pos <= MAX_HALF_TRACK {
                    let current_half_track = self.halftrack_head_pos as u8;
                    let new_track_identifier =
                        self.current_identifier.with_half_track(current_half_track);
                    self.track_handle.update_head_half_track(current_half_track);
                    self.evaluate_track_identifier(new_track_identifier, master_clock);

                    hardware.track_changed(current_half_track);
                }
            }
        }

        if (state_changes & pico1541_common::context::via::VIA2_MASK_MOTOR) != 0 {
            let motor_on = (full_state & pico1541_common::context::via::VIA2_MASK_MOTOR) != 0;
            self.surface.set_motor_running(motor_on, master_clock);
            pico1541_common::sound::notify_motor(motor_on);
        }
    }

    /// Helper to update state with argument order `(full_state, last_state, master_clock, hardware)`.
    #[inline(always)]
    pub fn update_from_state<H: HostInterface>(
        &mut self,
        full_state: u8,
        last_state: u8,
        master_clock: u32,
        hardware: &mut H,
    ) {
        self.update_state(full_state, last_state, hardware, master_clock);
    }

    #[link_section = ".core1_text"]
    #[inline(always)]
    fn evaluate_track_identifier(
        &mut self,
        new_track_identifier: TrackIdentifier,
        master_clock: u32,
    ) {
        // :? Has identifier changed?
        if self.current_identifier != new_track_identifier {
            // -> Yes, then we need to update the track source.
            self.current_identifier = new_track_identifier;
            self.evaluate_track_source(master_clock);
        }
    }

    #[link_section = ".core1_text"]
    #[inline(always)]
    fn evaluate_track_source(&mut self, master_clock: u32) {
        let loaded_identifier = self.track_handle.get_active_track_identifier();

        if self.current_identifier == loaded_identifier {
            let length = self.track_handle.get_active_track_length() as u32;
            if length > 0 {
                let stream = self.track_handle.get_active_track_buffer();
                self.surface.set_stream_source(stream, master_clock);
            } else {
                self.surface
                    .set_stream_source(TrackBuffer::noise(), master_clock);
            }
        } else {
            self.surface
                .set_stream_source(TrackBuffer::noise(), master_clock);
        }
    }
}
