johnnyegel/Pico1541/crates/pico1541-rp2040-emulation/src/emulation.rs

use core::sync::atomic::Ordering;
use embassy_rp::gpio::{Input, Output};
use pico1541_common::context::ViaHardware;
use pico1541_common::snooper::{IecSnooper, SnooperConfig};
use pico1541_common::util::bit_align_u32;
use pico1541_manager::{EVENT_CHANNEL, TRACK_CHANNEL, CMD_CHANNEL, InternalCommand};
use pico1541_common::interface::HostInterface;
use crate::magnetic_surface::PioMagneticSurface;

use pico1541_common::DriveEvent;
use pico1541_emulator::{DriveMechanics, Emulator};

use embassy_rp::multicore::Stack;
use embassy_rp::pio::Pio;
use embassy_rp::peripherals::PIO0;
use embassy_rp::peripherals::CORE1;

use cortex_m::peripheral::SYST;
use pico1541_common::SYSTEM_CLOCK_FREQ;
use pico1541_common::track_buffer::EmulatorHandle;

pub struct EmulatorHardware {
    pub pin_16: embassy_rp::Peri<'static, embassy_rp::peripherals::PIN_16>,
    pub pin_17: embassy_rp::Peri<'static, embassy_rp::peripherals::PIN_17>,
    pub pin_18: embassy_rp::Peri<'static, embassy_rp::peripherals::PIN_18>,
    pub pin_19: embassy_rp::Peri<'static, embassy_rp::peripherals::PIN_19>,
    pub pin_20: embassy_rp::Peri<'static, embassy_rp::peripherals::PIN_20>,
    pub pin_21: embassy_rp::Peri<'static, embassy_rp::peripherals::PIN_21>,
    pub pin_22: embassy_rp::Peri<'static, embassy_rp::peripherals::PIN_22>,
    pub pin_3: embassy_rp::Peri<'static, embassy_rp::peripherals::PIN_3>,
    pub pin_0: embassy_rp::Peri<'static, embassy_rp::peripherals::PIN_0>,
    pub pin_1: embassy_rp::Peri<'static, embassy_rp::peripherals::PIN_1>,
}

pub fn spawn_core1(
    core1: embassy_rp::Peri<'static, CORE1>,
    stack: &'static mut Stack<8192>,
    hardware: EmulatorHardware,
    snooper_config: &'static SnooperConfig,
    drive_id: u8,
    pio0: Pio<'static, PIO0>,
    emulator_handle: EmulatorHandle,
    rom_buffer: &'static [u8; 16384],
) {
    let pins_iec = IecPins {
        _data_rx: embassy_rp::gpio::Input::new(hardware.pin_16, embassy_rp::gpio::Pull::None),
        _clk_rx: embassy_rp::gpio::Input::new(hardware.pin_17, embassy_rp::gpio::Pull::None),
        _atn_rx: embassy_rp::gpio::Input::new(hardware.pin_18, embassy_rp::gpio::Pull::None),
        _data_tx: embassy_rp::gpio::Output::new(hardware.pin_19, embassy_rp::gpio::Level::Low),
        _clk_tx: embassy_rp::gpio::Output::new(hardware.pin_20, embassy_rp::gpio::Level::Low),
        _reset_rx: embassy_rp::gpio::Input::new(hardware.pin_21, embassy_rp::gpio::Pull::Up),
    };

    let pins_led = LedPins {
        _led_pos: embassy_rp::gpio::Output::new(hardware.pin_22, embassy_rp::gpio::Level::Low),
        _led_neg: embassy_rp::gpio::Output::new(hardware.pin_3, embassy_rp::gpio::Level::Low),
    };

    let pins_debug = DebugPins {
        _dbg_0: embassy_rp::gpio::Output::new(hardware.pin_0, embassy_rp::gpio::Level::Low),
        _dbg_1: embassy_rp::gpio::Output::new(hardware.pin_1, embassy_rp::gpio::Level::Low),    
    };

    let mut bridge = HardwareBridge::new(snooper_config, pins_iec, pins_led, pins_debug);

    embassy_rp::multicore::spawn_core1(core1, stack, move || {
        #[link_section = ".sram3"]
        static mut EMULATOR: core::mem::MaybeUninit<Emulator<HardwareBridge, PioMagneticSurface>> = core::mem::MaybeUninit::uninit();

        defmt::info!("Core 1 spawned! Initializing emulator...");

        let drive = unsafe {
            let ptr: *mut Emulator<HardwareBridge, PioMagneticSurface> = core::ptr::addr_of_mut!(EMULATOR).cast();
            let surface = PioMagneticSurface::new(pio0);
            let mechanics = DriveMechanics::new(surface, emulator_handle);
            core::ptr::write(ptr, Emulator::new(rom_buffer, drive_id, mechanics));
            &mut *ptr
        };
        drive.reset(&mut bridge);
        
        defmt::info!("Emulator initialized. Starting run loop...");

        cortex_m::interrupt::disable(); // Guarantee no IRQs preempt the emulator core
        run_emulator(drive, &mut bridge, rom_buffer);
    });
}

#[link_section = ".data.ram_func"]
#[inline(never)]
pub fn run_emulator(
    emulator: &mut Emulator<HardwareBridge, PioMagneticSurface>,
    hw: &mut HardwareBridge,
    rom_buffer: &'static [u8; 16384],
) -> ! {
    hw.timekeeper.init_on_core();
    
    let mut was_reset = true;
    hw.timekeeper.update_base(emulator.cycles);

    loop {
        /* FIXME! Disable HALT request for now!
        if hw.check_halt_requested() {
            let start = embassy_rp::pac::TIMER.timelr().read();
            while embassy_rp::pac::TIMER.timelr().read().wrapping_sub(start) < 100 {
                cortex_m::asm::nop();
            }
            // Update base time so we don't instantly try to catch up the halted time
            hw.timekeeper.update_base(emulator.cycles);
            continue;
        } */

        let is_reset = if hw.consume_trigger_reset() {
            emulator.update_rom(rom_buffer);
            true
        } else {
            hw.is_reset_line_asserted()
        };

        // :? Are we in reset?
        if is_reset {
            // -> Yes, then clear the was reset flag, and ensure the timekeeper is updated.
            was_reset = true;
            hw.timekeeper.update_base(emulator.cycles);
            cortex_m::asm::nop();
        } else {
            // -> No :? Was the reset line previously asserted?
            if was_reset {
                // -> Yes, then clear the was reset flag, and reset the emulator.
                was_reset = false;
                emulator.reset(hw);
                hw.timekeeper.update_base(emulator.cycles);
            }
            
            // :: Advance the emulator by 500 ticks
            for _ in 0..500 {
                emulator.tick(hw);
            }
        }

        // Report exactly on every loop, HostInterface does a fast atomic write
        hw.report_performance_counters(emulator.cycles, hw.timekeeper.idle_counter);
    }
}

pub struct TimeKeeper {
    pub base_time_24: u32,
    pub idle_counter: u32,
}

impl TimeKeeper {
    #[inline(always)]
    fn now_24() -> u32 {
        // SYST_CVR (Current Value Register) is a 24-bit down counter.
        // We invert it to a 24-bit up counter.
        0x00FFFFFF - SYST::get_current()
    }

    pub fn new() -> Self {
        Self {
            base_time_24: 0,
            idle_counter: 0,
        }
    }

    pub fn init_on_core(&mut self) {
        // Use the cortex_m HAL to safely configure SysTick ON THIS CORE.
        // SysTick is per-core! If `TimeKeeper::new` is called on Core 0 but used
        // on Core 1, Core 1's SysTick will remain disabled and freeze the emulator.
        // We use SystClkSource::Core (250MHz) to ensure it is always ticking.
        let mut syst = unsafe { cortex_m::Peripherals::steal().SYST };
        syst.set_clock_source(cortex_m::peripheral::syst::SystClkSource::Core);
        syst.set_reload(0x00FFFFFF);
        syst.clear_current();
        syst.enable_counter();
        self.base_time_24 = Self::now_24();
    }

    #[inline(always)]
    pub fn update_base(&mut self, current_cycles: u32) {
        // 1 cycle = 1 us. At Core frequency, 1us = (SYSTEM_CLOCK_FREQ / 1_000_000) ticks.
        let current_ticks = current_cycles.wrapping_mul(SYSTEM_CLOCK_FREQ / 1_000_000);
        self.base_time_24 = Self::now_24().wrapping_sub(current_ticks) & 0x00FFFFFF;
    }

    #[link_section = ".data.ram_func"]
    #[inline(always)]
    pub fn spin_until(&mut self, target_cycle: u32) {
        let target_ticks = target_cycle.wrapping_mul(SYSTEM_CLOCK_FREQ / 1_000_000);
        let target_time = self.base_time_24.wrapping_add(target_ticks) & 0x00FFFFFF;

        while target_time.wrapping_sub(Self::now_24()) & 0x00FFFFFF < 0x800000 {
            self.idle_counter = self.idle_counter.wrapping_add(1);
            cortex_m::asm::nop();
        }
    }

    #[link_section = ".data.ram_func"]
    #[inline(always)]
    pub fn spin_until_half(&mut self, target_cycle: u32) {
        //let target_ticks = target_cycle.wrapping_mul(SYSTEM_CLOCK_FREQ / 1_000_000)
        //    .wrapping_add(SYSTEM_CLOCK_FREQ / 2_000_000);
        let target_ticks = target_cycle.wrapping_mul(SYSTEM_CLOCK_FREQ / 1_000_000);
        let target_time = self.base_time_24.wrapping_add(target_ticks) & 0x00FFFFFF;

        while target_time.wrapping_sub(Self::now_24()) & 0x00FFFFFF < 0x800000 {
            self.idle_counter = self.idle_counter.wrapping_add(1);
            cortex_m::asm::nop();
        }
    }
}

struct IecPins {
    _data_rx: Input<'static>,
    _clk_rx: Input<'static>,
    _atn_rx: Input<'static>,
    _data_tx: Output<'static>,
    _clk_tx: Output<'static>,
    _reset_rx: Input<'static>,
}

struct LedPins {
    _led_pos: Output<'static>,
    _led_neg: Output<'static>,
}

struct DebugPins {
    _dbg_0: Output<'static>,
    _dbg_1: Output<'static>,
}

pub struct HardwareBridge {
    pub timekeeper: TimeKeeper,
    _snooper: IecSnooper,
    config: &'static SnooperConfig,
    motor_on: bool,
    _pins_iec: IecPins,
    _pins_led: LedPins,
    _pins_debug: DebugPins,
}

impl HardwareBridge {
    // Constants for GPIO IEC pin bit position
    const GPIO_DEBUG_BIT_0: usize = 0;
    const GPIO_DEBUG_BIT_1: usize = 1;
    const GPIO_IEC_BIT_DATA_RX: usize = 16; // GPIO 16 (PB0)
    const GPIO_IEC_BIT_CLK_RX: usize = 17;  // GPIO 17 (PB2)
    const GPIO_IEC_BIT_ATN_RX: usize = 18;  // GPIO 18 (PB7)
    const GPIO_IEC_BIT_DATA_TX: usize = 19; // GPIO 19 (PB0)
    const GPIO_IEC_BIT_CLK_TX: usize = 20;  // GPIO 20 (PB1)
    const GPIO_IEC_BIT_RESET: usize = 21;   // GPIO 21 (PB6)

    // Constants for GPIO pin masking
    const GPIO_DEBUG_MASK_0: u32 = 1 << Self::GPIO_DEBUG_BIT_0;
    const GPIO_DEBUG_MASK_1: u32 = 1 << Self::GPIO_DEBUG_BIT_1;
    const GPIO_IEC_MASK_DATA_RX: u32 = 1 << Self::GPIO_IEC_BIT_DATA_RX;
    const GPIO_IEC_MASK_CLK_RX: u32 = 1 << Self::GPIO_IEC_BIT_CLK_RX;
    const GPIO_IEC_MASK_ATN_RX: u32 = 1 << Self::GPIO_IEC_BIT_ATN_RX;
    const GPIO_IEC_MASK_DATA_TX: u32 = 1 << Self::GPIO_IEC_BIT_DATA_TX;
    const GPIO_IEC_MASK_CLK_TX: u32 = 1 << Self::GPIO_IEC_BIT_CLK_TX;
    const GPIO_IEC_MASK_RESET: u32 = 1 << Self::GPIO_IEC_BIT_RESET;

    // Constants for GPIO LED pins
    const GPIO_LED_BIT_GREEN: usize = 22;  // GPIO 22 (LED)
    const GPIO_LED_BIT_RED: usize = 3;   // GPIO 3 (LED)

    const GPIO_LED_MASK_GREEN: u32 = 1 << Self::GPIO_LED_BIT_GREEN;
    const GPIO_LED_MASK_RED: u32 = 1 << Self::GPIO_LED_BIT_RED;


    fn new(snooper_config: &'static SnooperConfig,
            pins_iec: IecPins, pins_led: LedPins, pins_debug: DebugPins) -> Self {

        let device_id = snooper_config.device_id.load(Ordering::Relaxed);
        let bridge = Self {
            timekeeper: TimeKeeper::new(),
            _snooper: IecSnooper::new(device_id),
            config: snooper_config,
            motor_on: false,
            _pins_iec: pins_iec,
            _pins_led: pins_led,
            _pins_debug: pins_debug
        };
        bridge
    }
}

impl HostInterface for HardwareBridge {
    
    #[link_section = ".data.ram_func"]
    #[inline(always)]
    fn send_event(&mut self, event: DriveEvent) {
        // try_send is non-blocking and safe for Core 0.
        let _ = EVENT_CHANNEL.try_send(event);
    }

    #[link_section = ".data.ram_func"]
    #[inline(always)]
    fn set_debug_0(&mut self) {
        embassy_rp::pac::SIO.gpio_out(0).value_set().write_value(Self::GPIO_DEBUG_MASK_0);
    }

    #[link_section = ".data.ram_func"]
    #[inline(always)]
    fn set_debug_1(&mut self) {
        embassy_rp::pac::SIO.gpio_out(0).value_set().write_value(Self::GPIO_DEBUG_MASK_1);
    }

    #[link_section = ".data.ram_func"]
    #[inline(always)]
    fn clear_debug_pins(&mut self) {
        embassy_rp::pac::SIO.gpio_out(0).value_clr().write_value(Self::GPIO_DEBUG_MASK_0 /*| Self::GPIO_DEBUG_MASK_1*/);
    }

    #[link_section = ".data.ram_func"]
    #[inline(always)]
    fn is_hijacked(&self) -> bool {
        self.config.hijack_active.load(Ordering::Relaxed)
    }
    
    #[link_section = ".data.ram_func"]
    #[inline(always)]
    fn pop_discard_request(&mut self) -> bool {
        self.config.discard_request.swap(false, Ordering::Relaxed)
    }

    #[link_section = ".data.ram_func"]
    #[inline(always)]
    fn update_iec_addresses(&mut self, listen: u8, talk: u8) {
        self.config.listen_addr.store(listen, Ordering::Relaxed);
        self.config.talk_addr.store(talk, Ordering::Relaxed);
    }

    
    #[link_section = ".data.ram_func"]
    #[inline(always)]
    fn track_changed(&mut self, half_track: u8) {
        // We notify the TRACK_CHANNEL directly instead of using DriveEvent
        // First we drain the channel to avoid blocking if the manager is behind
        while TRACK_CHANNEL.try_receive().is_ok() {}
        let _ = TRACK_CHANNEL.try_send(half_track);
        
        // Pend TIMER_IRQ_3 on Core 0 to wake up the DiskTask!
        embassy_rp::pac::TIMER.intf().write(|w| w.set_alarm(3, true));
    }

    #[link_section = ".data.ram_func"]
    #[inline(always)]
    fn get_device_id(&self) -> u8 {
        self.config.device_id.load(Ordering::Relaxed)
    }

    #[link_section = ".data.ram_func"]
    #[inline(always)]
    fn spin_until(&mut self, target_cycle: u32) {
        self.timekeeper.spin_until(target_cycle);
    }
    
    #[link_section = ".data.ram_func"]
    #[inline(always)]
    fn spin_until_half(&mut self, target_cycle: u32) {
        self.timekeeper.spin_until_half(target_cycle);
    }

    #[link_section = ".data.ram_func"]
    #[inline(always)]
    fn check_halt_requested(&self) -> bool {
        self.config.halt_emulator.load(Ordering::Relaxed)
    }

    #[link_section = ".data.ram_func"]
    #[inline(always)]
    fn report_performance_counters(&mut self, ticks: u32, idles: u32) {
        self.config.emu_total_ticks.store(ticks, Ordering::Relaxed);
        self.config.emu_total_idles.store(idles, Ordering::Relaxed);
    }
}

impl ViaHardware for HardwareBridge {

    #[link_section = ".data.ram_func"]
    #[inline(always)]
    fn read_iec_port(&mut self) -> u8 {
        // Sample GPIO inputs
        let pins = embassy_rp::pac::SIO.gpio_in(0).read();

        // Align the bits to match the VIA1 input register layout
        let data = bit_align_u32(pins & Self::GPIO_IEC_MASK_DATA_RX, 
            Self::GPIO_IEC_BIT_DATA_RX, Self::VIA1_IEC_BIT_DATA_RX) as u8;
        let clk = bit_align_u32(pins & Self::GPIO_IEC_MASK_CLK_RX, 
            Self::GPIO_IEC_BIT_CLK_RX, Self::VIA1_IEC_BIT_CLK_RX) as u8;
        let atn = bit_align_u32(pins & Self::GPIO_IEC_MASK_ATN_RX, 
            Self::GPIO_IEC_BIT_ATN_RX, Self::VIA1_IEC_BIT_ATN_RX) as u8;

        // Return the combined value in the VIA1 input register format
        data | clk | atn
    }

    #[link_section = ".data.ram_func"]
    #[inline(always)]
    fn write_iec_port(&mut self, via_port_b: u8) {

        let pb_data_mask = bit_align_u32((via_port_b & Self::VIA1_IEC_MASK_DATA_TX) as u32,
            Self::VIA1_IEC_BIT_DATA_TX, Self::GPIO_IEC_BIT_DATA_TX);

        // IEC_CLK_TX is bit 3, we want it at bit 20 -> shift by 17
        let pb_clk_mask = bit_align_u32((via_port_b & Self::VIA1_IEC_MASK_CLK_TX) as u32,
            Self::VIA1_IEC_BIT_CLK_TX, Self::GPIO_IEC_BIT_CLK_TX);

        // FIXME! Debug pin 1 should not be set when all is functioning normally. DEBUGGING ONLY!
        let target_state = pb_data_mask | pb_clk_mask;
        let mask = Self::GPIO_IEC_MASK_DATA_TX | Self::GPIO_IEC_MASK_CLK_TX;
        let current_state = embassy_rp::pac::SIO.gpio_out(0).value().read();
        let xor_mask = (current_state ^ target_state) & mask;   
        
        embassy_rp::pac::SIO.gpio_out(0).value_xor().write_value(xor_mask | Self::GPIO_DEBUG_MASK_1);
    }

    #[link_section = ".data.ram_func"]
    #[inline(always)]
    fn write_mechanics_port(&mut self, via_port_b: u8) {
        // Map the VIA2 activity LED pin to the RED GPIO LED pin
        let led_bit = bit_align_u32((via_port_b & Self::VIA2_MASK_LED) as u32,
                Self::VIA2_BIT_LED, Self::GPIO_LED_BIT_RED);

        let motor_bit = bit_align_u32((via_port_b & Self::VIA2_MASK_MOTOR) as u32,
                Self::VIA2_BIT_MOTOR, Self::GPIO_LED_BIT_GREEN);

        let led_override = bit_align_u32(led_bit, 
                Self::GPIO_LED_BIT_RED, Self::GPIO_LED_BIT_GREEN);

        let set_mask = led_bit | (motor_bit & !led_override);
        let clr_mask = !set_mask & (Self::GPIO_LED_MASK_RED | Self::GPIO_LED_MASK_GREEN);

        embassy_rp::pac::SIO.gpio_out(0).value_set().write_value(set_mask);
        embassy_rp::pac::SIO.gpio_out(0).value_clr().write_value(clr_mask);

        let motor_on_bool = motor_bit != 0;
        if motor_on_bool != self.motor_on {
            self.motor_on = motor_on_bool;
            let _ = CMD_CHANNEL.try_send(InternalCommand::MotorState(motor_on_bool));
        }
    }

    #[link_section = ".data.ram_func"]
    #[inline(always)]
    fn consume_trigger_reset(&mut self) -> bool {
        if self.config.trigger_reset.load(Ordering::Relaxed) {
            self.config.trigger_reset.store(false, Ordering::Relaxed);
            true
        } else {
            false
        }
    }

    #[link_section = ".data.ram_func"]
    #[inline(always)]
    fn is_reset_line_asserted(&self) -> bool {
        embassy_rp::pac::SIO.gpio_in(0).read() & Self::GPIO_IEC_MASK_RESET != 0
    }
}
