johnnyegel/Pico1541/crates/pico1541-common/src/snooper.rs

use crate::interface::DriveEvent;
use core::fmt::{self, Display};
use portable_atomic::{AtomicBool, AtomicU8, Ordering};

/// Represents the bus state of the IEC bus lines
/// Bit 0: DATA, Bit 1: CLK, Bit 2: ATN
#[derive(Debug, Clone, Copy, PartialEq, Default)]
pub struct IecBusState(pub u8);

impl IecBusState {
    pub const DATA_BIT: u8 = 0b001;
    pub const CLK_BIT: u8 = 0b010;
    pub const ATN_BIT: u8 = 0b100;

    #[inline(always)]
    pub fn get_data(&self) -> bool {
        self.0 & 0b001 != 0
    }
    #[inline(always)]
    pub fn get_clk(&self) -> bool {
        self.0 & 0b010 != 0
    }
    #[inline(always)]
    pub fn get_atn(&self) -> bool {
        self.0 & 0b100 != 0
    }

    #[inline(always)]
    pub fn set_data(&mut self, asserted: bool) {
        if asserted {
            self.0 |= Self::DATA_BIT;
        } else {
            self.0 &= !Self::DATA_BIT;
        }
    }

    #[inline(always)]
    pub fn set_clk(&mut self, asserted: bool) {
        if asserted {
            self.0 |= Self::CLK_BIT;
        } else {
            self.0 &= !Self::CLK_BIT;
        }
    }

    #[inline(always)]
    pub fn set_atn(&mut self, asserted: bool) {
        if asserted {
            self.0 |= Self::ATN_BIT;
        } else {
            self.0 &= !Self::ATN_BIT;
        }
    }

    #[inline(always)]
    pub fn combine(&self, other: &IecBusState) -> IecBusState {
        IecBusState(self.0 | other.0)
    }

    #[inline(always)]
    pub fn delta(&self, last_state: &IecBusState) -> IecBusState {
        IecBusState(self.0 ^ last_state.0)
    }
}

impl Display for IecBusState {
    fn fmt(&self, f: &mut fmt::Formatter<'_>) -> fmt::Result {
        write!(
            f,
            "IecBusState({:#04X}: ATN={}, CLK={}, DATA={})",
            self.0,
            self.get_atn(),
            self.get_clk(),
            self.get_data()
        )
    }
}

pub struct SnooperConfig {
    pub device_id: AtomicU8,
    pub listen_addr: AtomicU8,
    pub talk_addr: AtomicU8,
    pub hijack_active: AtomicBool,
    pub discard_request: AtomicBool,
    pub should_drive_data: AtomicBool,
    pub emu_speed_hz: portable_atomic::AtomicU32,
    pub core0_avg_raw: portable_atomic::AtomicU32,
    pub core0_max_raw: portable_atomic::AtomicU32,
    pub core1_avg_raw: portable_atomic::AtomicU32,
    pub core1_max_raw: portable_atomic::AtomicU32,
    pub diag_old_tick: portable_atomic::AtomicU32,
    pub diag_startup_ticks: portable_atomic::AtomicU32,
    pub trigger_reset: AtomicBool,
    pub halt_emulator: AtomicBool,
    pub emu_total_ticks: portable_atomic::AtomicU32,
    pub emu_total_idles: portable_atomic::AtomicU32,
    pub motor_on: AtomicBool,
    pub half_track: AtomicU8,
}

impl SnooperConfig {
    pub const fn new(device_id: u8) -> Self {
        Self {
            device_id: AtomicU8::new(device_id),
            listen_addr: AtomicU8::new(0x20 | (device_id & 0xF)),
            talk_addr: AtomicU8::new(0x40 | (device_id & 0xF)),
            hijack_active: AtomicBool::new(false),
            discard_request: AtomicBool::new(false),
            should_drive_data: AtomicBool::new(false),
            emu_speed_hz: portable_atomic::AtomicU32::new(0),
            core0_avg_raw: portable_atomic::AtomicU32::new(0),
            core0_max_raw: portable_atomic::AtomicU32::new(0),
            core1_avg_raw: portable_atomic::AtomicU32::new(0),
            core1_max_raw: portable_atomic::AtomicU32::new(0),
            diag_old_tick: portable_atomic::AtomicU32::new(0),
            diag_startup_ticks: portable_atomic::AtomicU32::new(0),
            trigger_reset: AtomicBool::new(false),
            halt_emulator: AtomicBool::new(false),
            emu_total_ticks: portable_atomic::AtomicU32::new(0),
            emu_total_idles: portable_atomic::AtomicU32::new(0),
            motor_on: AtomicBool::new(false),
            half_track: AtomicU8::new(36), // Default track 18
        }
    }

    pub fn update_device_id(&self, device_id: u8) {
        self.device_id.store(device_id, Ordering::Relaxed);
        self.listen_addr
            .store(0x20 | (device_id & 0xF), Ordering::Relaxed);
        self.talk_addr
            .store(0x40 | (device_id & 0xF), Ordering::Relaxed);
    }
}

/// Struct to represent edges on the IEC bus
struct IecBusEdge {
    state: IecBusState,
    delta: IecBusState,
}

impl IecBusEdge {
    /// Returns true if the clock line has an edge matching the expected level.
    #[link_section = ".core1_text"]
    #[inline(always)]
    pub fn is_clk(&self, expect: bool) -> bool {
        self.delta.get_clk() && self.state.get_clk() == expect
    }
}

#[derive(Debug, PartialEq, Eq, Clone, Copy)]
enum SnooperState {
    Idle,
    Receiving,
    WaitTurnaround,
}

/// Implements a snooper that monitors the IEC bus lines and decodes commands sent to the drive
pub struct IecSnooper {
    listen_addr: u8,

    last_iec: IecBusState,
    state: SnooperState,
    bit_count: u8,
    current_byte: u8,
    is_eoi: bool,
    is_atn: bool,

    is_listening: bool,
    secondary_address: u8,
    idle_cycles: u32,
    has_notified_idle: bool,
}

impl IecSnooper {
    pub fn new(device_id: u8) -> Self {
        Self {
            listen_addr: 0x20 | (device_id & 0xF),
            last_iec: IecBusState::default(),
            state: SnooperState::Idle,
            bit_count: 0,
            current_byte: 0,
            is_eoi: false,
            is_atn: false,
            is_listening: false,
            secondary_address: 0,
            idle_cycles: 0,
            has_notified_idle: false,
        }
    }

    pub fn set_listen_addr(&mut self, listen_address: u8) {
        self.listen_addr = listen_address;
    }

    #[link_section = ".core1_text"]
    #[inline(always)]
    pub fn update<F: FnMut(DriveEvent)>(&mut self, iec_state: IecBusState, mut dispatch: F) {
        // Detect edge changed and return early if no change
        let delta = iec_state.delta(&self.last_iec);
        if delta.0 == 0 {
            if iec_state.0 == 0 {
                if self.idle_cycles < 250_000 {
                    self.idle_cycles += 1;
                } else if !self.has_notified_idle {
                    self.has_notified_idle = true;
                    dispatch(DriveEvent::IecBusIdleTimeout);
                }
            }
            return;
        }

        self.idle_cycles = 0;
        self.has_notified_idle = false;

        // Capture the edge information, and update the last known state
        let edge = IecBusEdge {
            state: iec_state,
            delta,
        };
        self.last_iec = iec_state;

        // :? Is this an ATN edge?
        if delta.get_atn() {
            if iec_state.get_atn() {
                // ATN went LOW (Asserted)
                if self.is_listening {
                    // DATA phase ended by host pulling ATN low
                    dispatch(DriveEvent::IecSnoopEndOfTransaction);
                }
            } else {
                // ATN went HIGH (Released). Transaction fully complete.
                dispatch(DriveEvent::IecSnoopTransactionComplete);
            }
            self.state = SnooperState::Idle;
            return;
        }

        // Start of data: CLK edge release, DATA asserted
        match self.state {
            SnooperState::Idle => {
                // Talker pulls CLK low (True) to signal start of a byte transfer
                if edge.is_clk(true) {
                    // NOTE! EOI detection requires timing (200us pause) or seeing drive lines.
                    // Since we only see host lines and have no timer here, we rely on
                    // ATN/UNLISTEN transitions to finalize commands.
                    self.is_eoi = false;
                    self.is_atn = iec_state.get_atn();

                    self.state = SnooperState::Receiving;
                    self.bit_count = 0;
                    self.current_byte = 0;
                }
            }
            SnooperState::Receiving => {
                // Bits are valid on the rising edge of CLK (Release/False)
                if edge.is_clk(false) {
                    // Capture the bit value (inverted logic: Released=1, Asserted=0)
                    let bit = if !iec_state.get_data() { 1 } else { 0 };
                    self.current_byte |= bit << self.bit_count;
                    self.bit_count += 1;

                    // :? Full byte received?
                    if self.bit_count == 8 {
                        // -> Yes, process the byte
                        self.dispatch_byte(
                            self.current_byte,
                            self.is_atn,
                            self.is_eoi,
                            &mut dispatch,
                        );
                        self.state = SnooperState::WaitTurnaround;
                    }
                }
            }
            SnooperState::WaitTurnaround => {
                // After 8 bits, the talker pulls CLK low again (True) to wait for ACK.
                // We wait for this falling edge before going back to Idle.
                if edge.is_clk(true) {
                    self.state = SnooperState::Idle;
                }
            }
        }
    }

    #[link_section = ".core1_text"]
    fn dispatch_byte<F: FnMut(DriveEvent)>(
        &mut self,
        byte: u8,
        atn: bool,
        eoi: bool,
        dispatch: &mut F,
    ) {
        log::debug!(
            "[Snooper] Received byte 0x{:02X} (ATN={}, EOI={})",
            byte,
            atn,
            eoi
        );
        // :? Is this an ATN byte?
        if atn {
            // :? Is it a secondary address?
            // 0x60..0x6F = DATA, 0xE0..0xEF = CLOSE, 0xF0..0xFF = OPEN
            let is_sa = (byte & 0xE0) == 0x60 || (byte & 0xE0) == 0xE0 || (byte & 0xF0) == 0xF0;
            if is_sa {
                if self.is_listening {
                    self.secondary_address = byte;
                    if (byte & 0xF0) == 0xE0 {
                        dispatch(DriveEvent::IecCloseChannel(byte & 0x0F));
                    } else {
                        dispatch(DriveEvent::IecSnoopSecondaryAddress(byte));
                    }
                }
            } else if byte == self.listen_addr {
                // -> No, but this byte is our listen address, so we should start listening
                self.is_listening = true;
            } else if byte == 0x3F {
                // UNLISTEN
                if self.is_listening {
                    dispatch(DriveEvent::IecSnoopEndOfTransaction);
                }
                self.is_listening = false;
            }
            return;
        }

        // E -> No, are we listening?
        if !self.is_listening {
            // -> No, then we ignore this byte
            return;
        }

        // E -> Yes, then this is a data byte we should capture
        dispatch(DriveEvent::IecSnoopByteReceived(byte, eoi));

        if eoi {
            self.is_listening = false;
        }
    }
}

pub struct IecSnoopByteHandler {
    buffer: [u8; 32],
    pos: usize,
    secondary_address: u8,
    hijack_active: bool,
    eoi_received: bool,
    transaction_complete: bool,
    cmd_len: usize,
}

impl IecSnoopByteHandler {
    pub fn new() -> Self {
        Self {
            buffer: [0; 32],
            pos: 0,
            secondary_address: 0,
            hijack_active: false,
            eoi_received: false,
            transaction_complete: false,
            cmd_len: 0,
        }
    }
}

impl Default for IecSnoopByteHandler {
    fn default() -> Self {
        Self::new()
    }
}

impl IecSnoopByteHandler {
    #[link_section = ".core1_text"]
    pub fn handle(&mut self, event: DriveEvent, mut dispatch: &mut dyn FnMut(DriveEvent)) {
        match event {
            DriveEvent::IecSnoopSecondaryAddress(sa) => {
                self.pos = 0;
                self.cmd_len = 0;
                self.secondary_address = sa;
                self.hijack_active = false;
                self.eoi_received = false;
                self.transaction_complete = false;
            }
            DriveEvent::IecSnoopByteReceived(byte, eoi) => {
                if self.pos < self.buffer.len() {
                    self.buffer[self.pos] = byte;
                    self.pos += 1;
                }

                // Check for hijack condition: starts with "CD"
                if self.pos >= 2
                    && (self.buffer[0] == b'C' || self.buffer[0] == b'c')
                    && (self.buffer[1] == b'D' || self.buffer[1] == b'd')
                {
                    self.hijack_active = true;
                }

                if eoi {
                    self.finish_command(&mut dispatch);
                }
            }
            DriveEvent::IecSnoopEndOfTransaction => {
                self.finish_command(&mut dispatch);
            }
            DriveEvent::IecSnoopTransactionComplete => {
                self.transaction_complete = true;
            }
            _ => {}
        }
    }

    fn finish_command(&mut self, mut dispatch: impl FnMut(DriveEvent)) {
        if self.pos > 0 {
            // Emit IecCommand if it's on the command channel (SA 15) or hijacked
            let sa = self.secondary_address & 0x0F;
            let is_dir_command = self.pos > 0 && self.buffer[0] == b'$';
            if sa == 15 || self.hijack_active || is_dir_command {
                let mut data = [0u8; 32];
                let len = self.pos.min(32);
                data[..len].copy_from_slice(&self.buffer[..len]);
                dispatch(DriveEvent::IecCommand {
                    data,
                    len: len as u8,
                });
            }
            self.cmd_len = self.pos;
            self.pos = 0; // Clear for next command
            self.eoi_received = true;
        }
    }

    pub fn is_hijacked(&self) -> bool {
        self.hijack_active
    }

    pub fn should_discard(&self) -> bool {
        self.hijack_active && self.transaction_complete
    }

    pub fn get_command(&self) -> Option<&str> {
        let len = if self.pos > 0 { self.pos } else { self.cmd_len };
        if len > 0 {
            core::str::from_utf8(&self.buffer[..len]).ok()
        } else {
            None
        }
    }
}
