johnnyegel/Pico1541/crates/pico1541-manager/src/tasks/mount_manager.rs

use embedded_io_async::{Read, Seek};
use crate::formats::{AnyDiskImage, DiskImage};
use pico1541_common::track_buffer::{ManagerHandle, TrackLayout};
use crate::storage::DirectorySource;
use crate::{CMD_CHANNEL, TRACK_REQUEST, TRACK_SIGNAL, InternalCommand, MountPayload};
use core::sync::atomic::Ordering;
use embassy_futures::select::{select, select3, Either, Either3};
#[cfg(feature = "defmt")]
use defmt::{info, warn, error, debug};
#[cfg(not(feature = "defmt"))]
use log::{info, warn, error, debug};

use embassy_sync::blocking_mutex::raw::CriticalSectionRawMutex;
use embassy_sync::mutex::Mutex;

pub trait FileOpener {
    type FileStorage: embedded_io_async::Read + embedded_io_async::Seek + 'static;
    async fn open_file(&self, requested_petscii: &[u8]) -> Result<Self::FileStorage, crate::formats::Error>;
    fn open_sd_file(&self, path: &str) -> Self::FileStorage;
    fn open_internal_file(&self, path: &str) -> Self::FileStorage;
    async fn list_dir_range(
        &self,
        path: &str,
        use_internal: bool,
        start_index: usize,
        count: usize,
        callback: impl FnMut(crate::storage::DirectoryEntry),
    ) -> Result<(), crate::formats::Error>;
}

pub fn match_c64_filename(entry_name: &[u8; 16], req_name: &[u8]) -> bool {
    let mut entry_len = 16;
    while entry_len > 0 && entry_name[entry_len - 1] == 0xA0 {
        entry_len -= 1;
    }
    
    let mut req_len = req_name.len();
    while req_len > 0 && req_name[req_len - 1] == 0xA0 {
        req_len -= 1;
    }
    
    if req_len == 0 || entry_len == 0 {
        return false;
    }

    let mut e_idx = 0;
    let mut r_idx = 0;
    
    while r_idx < req_len && e_idx < entry_len {
        let r_char = req_name[r_idx];
        if r_char == 0x2A { // '*'
            return true;
        } else if r_char == 0x3F { // '?'
            // matches any char
        } else if entry_name[e_idx] != r_char {
            break;
        }
        e_idx += 1;
        r_idx += 1;
    }
    
    if r_idx < req_len && req_name[r_idx] == 0x2A {
        return true;
    }
    
    if r_idx == req_len && e_idx == entry_len {
        return true;
    }
    
    if r_idx == req_len {
        let extensions: &[&[u8]] = &[b".PRG", b".SEQ", b".USR", b".DEL", b".DIR"];
        for ext in extensions {
            if entry_len == r_idx + ext.len() {
                let mut match_found = true;
                for i in 0..ext.len() {
                    let ext_char = crate::storage::ascii_to_petscii(ext[i]);
                    if entry_name[r_idx + i] != ext_char {
                        match_found = false;
                        break;
                    }
                }
                if match_found {
                    return true;
                }
            }
        }
    }
    
    false
}


pub struct MountManagerTask<S: Read + Seek + 'static, O: FileOpener<FileStorage = S>, L: crate::driver::RgbLedDriver> {
    disk_image: Option<AnyDiskImage<S, crate::storage::PagedDirectorySource<144>>>,
    track_handle: ManagerHandle,
    opener: O,
    leds: L,
    mounted_dir: &'static Mutex<CriticalSectionRawMutex, (heapless::String<128>, bool)>,
    pre_cached_ht: Option<(u8, pico1541_common::track_buffer::TrackLayout, usize, Option<u8>)>,
    last_step_direction: i8,
}

impl<S: Read + Seek + 'static, O: FileOpener<FileStorage = S>, L: crate::driver::RgbLedDriver> MountManagerTask<S, O, L> {
    pub fn new(
        track_handle: ManagerHandle,
        opener: O,
        leds: L,
        mounted_dir: &'static Mutex<CriticalSectionRawMutex, (heapless::String<128>, bool)>,
    ) -> Self {
        Self {
            disk_image: None,
            track_handle,
            opener,
            leds,
            mounted_dir,
            pre_cached_ht: None,
            last_step_direction: 2,
        }
    }


    async fn cache_adjacent_tracks(&mut self) -> Option<u8> {
        let current_ht = self.track_handle.get_head_half_track();
        
        let desired_track = (current_ht as i16 + self.last_step_direction as i16) as u8;
        if desired_track == 0 || desired_track > 84 {
            return None;
        }

        if let Some((ht, _, _, _)) = self.pre_cached_ht {
            if ht == desired_track {
                return None; // Already cached!
            }
        }

        let mut disk_opt = self.disk_image.as_mut();
        if let Some(disk) = disk_opt.as_mut() {
            let data = self.track_handle.start_track_load();
            match embassy_futures::select::select(disk.read_track(desired_track, data), TRACK_SIGNAL.wait()).await {
                embassy_futures::select::Either::First(Ok(layout)) => {
                    self.pre_cached_ht = Some((desired_track, layout.0, layout.1, layout.2));
                    debug!("Pre-cached Track {}.{} (HT: {}) into back buffer", (desired_track / 2) + 1, desired_track % 2, desired_track);
                    return None;
                }
                embassy_futures::select::Either::First(Err(_)) => {
                    return None;
                }
                embassy_futures::select::Either::Second(_) => {
                    return Some(TRACK_REQUEST.load(Ordering::Relaxed));
                }
            }
        }
        None
    }

    async fn handle_track_event(&mut self, half_track: u8) {
        let mut target_ht = half_track;

        loop {
            let requested = TRACK_REQUEST.load(Ordering::Relaxed);
            if requested != target_ht {
                target_ht = requested;
            }
            
            // Update direction based on the previously active track
            let active_ht = self.track_handle.get_active_track_identifier().half_track();
            if active_ht != 0xFF {
                let diff = target_ht as i16 - active_ht as i16;
                if diff != 0 {
                    self.last_step_direction = if diff > 0 { 2 } else { -2 };
                }
            }
            
            debug!("Manager loading Track {}.{} (HT: {})", (target_ht / 2) + 1, target_ht % 2, target_ht);

            // Check if it's already pre-cached in the back buffer!
            if let Some((ht, layout, length, speed_zone)) = self.pre_cached_ht {
                if ht == target_ht {
                    // It's perfectly ready in the back buffer. Just commit it!
                    self.track_handle.commit_loaded_track(
                        pico1541_common::track_buffer::TrackIdentifier::new(target_ht, speed_zone.unwrap_or_else(|| pico1541_common::track_buffer::default_speed_zone(target_ht))),
                        layout,
                        length
                    );
                    self.pre_cached_ht = None; // Used it!
                    info!("Track {}.{} (HT: {}) load took 0 ms (PRE-CACHED)", (target_ht / 2) + 1, target_ht % 2, target_ht);
                    break;
                }
            }
            
            // Not cached, we will use the back buffer for the new read.
            let saved_pre_cache = self.pre_cached_ht.take();

            // Prevent DOS from reading the old track data by stalling it safely.
            let old_layout = self.track_handle.get_active_layout();
            self.track_handle.set_active_layout(TrackLayout::Void);

            let mut disk_opt = self.disk_image.as_mut();
            if let Some(disk) = disk_opt.as_mut() {
                let data = self.track_handle.start_track_load();
                
                let start_time = embassy_time::Instant::now();
                // Read track but CANCEL if the head steps again!
                match select(disk.read_track(target_ht, data), TRACK_SIGNAL.wait()).await {
                    Either::First(Ok(layout)) => {
                        let speed_zone = layout.2.unwrap_or_else(|| pico1541_common::track_buffer::default_speed_zone(target_ht));
                        let identifier = pico1541_common::track_buffer::TrackIdentifier::new(target_ht, speed_zone);
                        
                        if layout.0 == TrackLayout::Void {
                            // If the track is completely empty, there's no need to commit the back-buffer
                            // (which swaps buffers and pads it with 0x55). We just update the active identifier!
                            self.track_handle.set_active_track_identifier(identifier);
                            self.pre_cached_ht = saved_pre_cache; // Restore it, the back buffer wasn't clobbered!
                        } else {
                            self.track_handle.commit_loaded_track(identifier, layout.0, layout.1);
                        }
                        
                        let elapsed = start_time.elapsed().as_millis();
                        info!("Track {}.{} (HT: {}) load took {} ms", (target_ht / 2) + 1, target_ht % 2, target_ht, elapsed);
                        break; // Success, done loading the track!
                    }
                    Either::First(Err(e)) => {
                        error!("Failed to read track: {:?}", &e);
                        self.track_handle.set_active_layout(old_layout);
                        break;
                    }
                    Either::Second(_) => {
                        // The head stepped WHILE we were reading from the SD card!
                        // The read is aborted. We loop around to start reading the NEW track!
                        target_ht = TRACK_REQUEST.load(Ordering::Relaxed);
                        continue;
                    }
                }
            } else {
                self.track_handle.commit_loaded_track(pico1541_common::track_buffer::TrackIdentifier::new(target_ht, pico1541_common::track_buffer::default_speed_zone(target_ht)), TrackLayout::Void, 0);
                info!("Half-Track {} is void...", target_ht);
                break;
            }
        }
    }

    pub async fn run(&mut self) {
        let mut motor_on = false;
        loop {
            if TRACK_SIGNAL.signaled() {
                let half_track = TRACK_REQUEST.load(Ordering::Relaxed);
                TRACK_SIGNAL.reset();
                self.handle_track_event(half_track).await;
                continue;
            }

            let track_fut = TRACK_SIGNAL.wait();
            let timer_fut = embassy_time::Timer::after_millis(20);
            let cmd_fut = CMD_CHANNEL.receive();

            match select3(track_fut, timer_fut, cmd_fut).await {
                Either3::First(_) => {
                    self.handle_track_event(TRACK_REQUEST.load(Ordering::Relaxed)).await;
                }
                Either3::Second(_) => {
                    // (first_missing_block, batch_count)
                    let mut block_batch: Option<(usize, usize)> = None;
                    {
                        let mut disk_opt = self.disk_image.as_mut();
                        if let Some(disk) = disk_opt.as_mut() {
                            if let Some(vdir) = disk.as_virtual_disk_mut() {
                                // Periodic update of directory buffer only when motor is on
                                if motor_on {
                                    let current_idx = self.track_handle.get_current_byte_idx();
                                    
                                    if vdir.file_storage.is_some() {
                                        // Track 1: File streaming (StriddenWarp)
                                        let data = self.track_handle.start_track_modification();
                                        if vdir.update_dynamic_buffer(current_idx, data).await {
                                            self.track_handle.commit_modified_track();
                                        }
                                    } else if !vdir.source.as_paged_mut().map(|p| p.is_exhausted()).unwrap_or(true) {
                                        // Track 18: Directory Listing (Accurate(7142))
                                        let s1 = vdir.sector1_idx;
                                        let s2 = vdir.sector2_idx;
                                        
                                        if s1 > 0 && s2 > 0 {
                                            let s2_end = s2 + 325;
                                            let s1_start = s1.saturating_sub(40);
                                            
                                            // Dead zone between Sector 2 and Sector 1
                                            if current_idx > s2_end && current_idx < s1_start {
                                                if vdir.next_sector_to_update == 2 {
                                                    // Head has passed Sector 2. Swap to the next batch!
                                                    let data = self.track_handle.start_track_modification();
                                                    vdir.force_update_directory_sectors(data).await;
                                                    self.track_handle.commit_modified_track();
                                                    
                                                    // Prevent further swaps until we pass Sector 2 again
                                                    vdir.next_sector_to_update = 1;
                                                }
                                            } else if current_idx < s2 {
                                                // Reset the trigger flag when head loops around before Sector 2
                                                vdir.next_sector_to_update = 2;
                                            }
                                        }
                                    }
                                }

                                // Background prefetching for paged directory source
                                if let Some(paged) = vdir.source.as_paged_mut() {
                                    // Stop prefetching once the directory end has been discovered.
                                    if !paged.is_exhausted() {
                                        let current_idx = paged.current_read_index();
                                        let current_block = current_idx / 16;
                                        let (start_block, end_block) = paged.loaded_range();

                                        // Collect consecutive missing blocks in the lookahead window.
                                        // One list_dir_range call covers them all in a single forward
                                        // scan, avoiding O(N) re-scans from entry 0.
                                        let mut batch_start = None;
                                        let mut batch_end = 0usize;
                                        for offset in 0..3 {
                                            let tb = current_block + offset;
                                            if tb < start_block || tb >= end_block {
                                                if batch_start.is_none() {
                                                    batch_start = Some(tb);
                                                    batch_end = tb + 1;
                                                } else if tb == batch_end {
                                                    batch_end += 1;
                                                }
                                            }
                                        }

                                        if let Some(bs) = batch_start {
                                            block_batch = Some((bs, batch_end - bs));
                                        }
                                    }
                                }
                            }
                        }
                    }

                    if false /* let Some((blocks_start, blocks_count)) = block_batch */ {
                        let (blocks_start, blocks_count) = block_batch.unwrap();

                        // Mark active track as Void during background directory fetch to prevent Core 0 emu hang/timeouts.
                        let old_layout = self.track_handle.get_active_layout();
                        self.track_handle.set_active_layout(TrackLayout::Void);

                        let (path, use_internal) = {
                            let guard = self.mounted_dir.lock().await;
                            (guard.0.clone(), guard.1)
                        };

                        // Fetch all missing blocks in a single sequential pass.
                        // Each block holds 16 entries; use a 3×16=48 entry buffer max.
                        let fetch_start = blocks_start * 16;
                        let fetch_count = blocks_count * 16;
                        let mut all_entries = heapless::Vec::<crate::storage::DirectoryEntry, 48>::new();
                        let fetch_res = self.opener.list_dir_range(
                            path.as_str(),
                            use_internal,
                            fetch_start,
                            fetch_count,
                            |entry| {
                                let _ = all_entries.push(entry);
                            }
                        ).await;

                        if fetch_res.is_ok() {
                            let mut disk_opt = self.disk_image.as_mut();
                            if let Some(disk) = disk_opt.as_mut() {
                                if let Some(vdir) = disk.as_virtual_disk_mut() {
                                    if let Some(paged) = vdir.source.as_paged_mut() {
                                        // Distribute fetched entries into their correct block slots.
                                        // set_block auto-detects end-of-directory from partial blocks.
                                        for b in 0..blocks_count {
                                            let slice_start = (b * 16).min(all_entries.len());
                                            let slice_end = (slice_start + 16).min(all_entries.len());
                                            let block_slice = &all_entries[slice_start..slice_end];
                                            
                                            let mut block_entries = heapless::Vec::<crate::storage::DirectoryEntry, 16>::new();
                                            for e in block_slice {
                                                let _ = block_entries.push(*e);
                                            }
                                            paged.set_block(blocks_start + b, &block_entries);
                                            if block_slice.len() < 16 {
                                                break; // We reached the end of the directory, don't write trailing empty blocks!
                                            }
                                        }

                                        // We fetched new blocks. If the active track is 18, we must regenerate the GCR data!
                                        let active_ht = self.track_handle.get_head_half_track();
                                        if active_ht == 34 || active_ht == 35 {
                                            vdir.next_sector_to_update = 1;
                                            let data = self.track_handle.start_track_modification();
                                            vdir.force_update_directory_sectors(data).await;
                                            self.track_handle.commit_modified_track();
                                            vdir.treadmill_spinup_delay = 10;
                                        }
                                    }
                                }
                            }
                        }

                        self.track_handle.set_active_layout(old_layout);
                    }

                    if let Some(new_ht) = self.cache_adjacent_tracks().await {
                        self.handle_track_event(new_ht).await;
                    }
                }
                Either3::Third(cmd) => {
                    match cmd {
                        InternalCommand::MotorState(active) => {
                            if active && !motor_on {
                                let mut disk_opt = self.disk_image.as_mut();
                                if let Some(disk) = disk_opt.as_mut() {
                                    if let Some(vdir) = disk.as_virtual_disk_mut() {
                                        vdir.source.rewind();
                                        vdir.next_sector_to_update = 1;
                                        let data = self.track_handle.start_track_modification();
                                        vdir.force_update_directory_sectors(data).await;
                                        self.track_handle.commit_modified_track();
                                        vdir.treadmill_spinup_delay = 10;
                                    }
                                }
                            }
                            motor_on = active;
                        }
                        
                        InternalCommand::Mount(payload) => {
                            let (path, use_internal, led_mode) = match payload {
                                MountPayload::VirtualDirectory(p, i) => {
                                    let dir_source = crate::storage::PagedDirectorySource::<144>::new(p.as_bytes());
                                    let vdisk = crate::formats::VirtualDiskImage::new(dir_source, p.as_bytes());
                                    self.disk_image = Some(crate::formats::AnyDiskImage::VirtualDisk(vdisk));
                                    (p, i, crate::driver::StatusLedMode::VirtualDisk)
                                }
                                MountPayload::D64(p, i) => {
                                    let file = if i {
                                        self.opener.open_internal_file(p.as_str())
                                    } else {
                                        self.opener.open_sd_file(p.as_str())
                                    };
                                    let d64 = crate::formats::D64Image::new(file);
                                    self.disk_image = Some(crate::formats::AnyDiskImage::D64(d64));
                                    (p, i, crate::driver::StatusLedMode::NonAccurateDisk)
                                }
                                MountPayload::G64(p, i) => {
                                    let file = if i {
                                        self.opener.open_internal_file(p.as_str())
                                    } else {
                                        self.opener.open_sd_file(p.as_str())
                                    };
                                    if let Ok(g64) = crate::formats::G64Image::from_storage(file).await {
                                        self.disk_image = Some(crate::formats::AnyDiskImage::G64(g64));
                                        (p, i, crate::driver::StatusLedMode::AccurateDisk)
                                    } else {
                                        self.disk_image = None;
                                        (p, i, crate::driver::StatusLedMode::Unmounted)
                                    }
                                }
                            };
                            
                            {
                                let mut guard = self.mounted_dir.lock().await;
                                guard.0 = path.clone();
                                guard.1 = use_internal;
                            }
                            self.leds.set_status(led_mode);
                            
                            info!("Disk Image mounted: {}. Simulating physical disk swap.", path.as_str());
                            
                            // 1. Unmount sequence (in case a disk was already there)
                            self.track_handle.set_active_layout(TrackLayout::Void);
                            self.track_handle.set_write_protected(true); // LOW (sliding out)
                            embassy_time::Timer::after_millis(50).await;
                            self.track_handle.set_write_protected(false); // HIGH (no disk)
                            
                            let mut disk_opt = self.disk_image.as_mut();
                            if !disk_opt.is_none() {
                                embassy_time::Timer::after_millis(400).await;
                                self.track_handle.set_write_protected(true); // LOW (sliding in)
                                embassy_time::Timer::after_millis(50).await;
                                self.track_handle.set_write_protected(true); // LOW (configured: always write protected)
                                
                                // Set force disk change flag
                                self.track_handle.set_force_disk_change(true);
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
