johnnyegel/Pico1541/crates/pico1541-common/src/formats.rs

use crate::gcr;
use crate::storage::DirectorySource;
use embedded_io_async::{Read, Seek, SeekFrom};

#[derive(Debug)]
#[cfg_attr(feature = "defmt", derive(defmt::Format))]
pub enum Error {
    Io,
    InvalidFormat,
    InvalidTrack,
    TrackTooLarge,
    FileNotFound,
}

use crate::track_buffer::TrackLayout;


#[allow(async_fn_in_trait)]
pub trait DiskImage {
    /// Loads a specific half-track into the provided buffer.
    /// Returns the layout of the loaded track.
    async fn read_track(&mut self, half_track: u8, dest: &mut [u8]) -> Result<(TrackLayout, usize, Option<u8>), Error>;
}

#[derive(Clone, Debug)]
pub struct TrackLookupTable {
    pub offsets: [Option<u32>; 86],
    pub speed_zones: [Option<u8>; 86],
}

impl TrackLookupTable {
    pub fn new() -> Self {
        Self {
            offsets: [None; 86],
            speed_zones: [None; 86],
        }
    }
}

impl Default for TrackLookupTable {
    fn default() -> Self {
        Self::new()
    }
}

#[inline(always)]
pub const fn sectors_per_track(track: u8) -> u8 {
    match track {
        1..=17 => 21,
        18..=24 => 19,
        25..=30 => 18,
        31..=40 => 17,
        _ => 0,
    }
}

pub struct VirtualDiskImage<S, D: DirectorySource> {
    pub source: D,
    pub file_storage: Option<S>,
    id: [u8; 2],
    pub sector1_idx: usize,
    pub sector2_idx: usize,
    pub next_sector_to_update: u8,
    pub shortcut_entry: Option<crate::storage::DirectoryEntry>,
    pub treadmill_spinup_delay: u16,
}
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
