johnnyegel/Pico1541/(commit log)

2026-03-25 Simplified the drive mechanics steper motor handling significantly.
2026-03-26 Implemented debug of interrupts
2026-03-27 Implemented motor spin-up delay.
2026-04-01 Added schematic for hardware
2026-04-02 Started PCB layout
2026-04-11 Completed PCB design. Still missing break-off tabs.
2026-04-11 Added mouse bites to PCB parts.
2026-04-12 Added Gerber files for final design for JLCPCB.
2026-04-12 Fixed via holes and created new Gerbers and ZIP for JLCPCB
2026-04-15 Fixed status test to work Added missing footprint dir for hardware
2026-04-19 Tried to implement a LockStep sync mechanism for IEC to drive communication. It currently do not work correctly.
    Fixed broken drive mechanics emulation. This was faulty, and was
    inconsistently handled. Now all drive mechanics events are fired
    from the drive mechanics, keeping the systembus clean.
2026-04-19 Added ROM assembly code. Added missing HW files from repo.
2026-04-21 Started on the Pico project. It compiles and creates an ELF. Removed mnemonics from 6502 emulator, as this does not belong there.
2026-04-21 Separated drivers into modules
2026-04-21 Added display driver
2026-04-26 Refined the Track implementation to use an Enum instead of a tuple, to make it clear what kind of track we are handling.
2026-05-04 Added test to verify correct mounting of a g64 image in the drive mechanics, without booting the drive.
2026-05-13 Included config file for Pico project.
2026-05-13 Added support for activity LED.
2026-05-13 Fixed RGB led footprint error. Pins 1 and 2 had wrong ordering.
2026-05-18 Trying to get stuff back on rails.
2026-05-18 Changed to use new emulator in pico project.
2026-05-20 Added working status LED.
2026-05-20 Implemented proper mount point handling. Implemented LED status according to image type.
2026-05-22 Implemented hadris-fat async FAT driver in the emulator.
2026-05-22 Removed unnecessary crate, and implemented custom sd card block device driver.
2026-05-23 Attempt at fixing the block device driver for the Sd MMC. Does not work.
2026-05-24 Another attempt at SD card block device driver.
2026-05-24 Fixed the custom block device driver for SD card :-D
2026-05-24 Set the default SD card speed to 25 MHz, which works flawlessly on my prototype board :-D
2026-05-24 Fixed short dir names and deep dir dis-mount.
2026-05-24 Improved the monting UX, where a image is marked as mounted and can be deselected by selecting it again (deselect).
2026-05-24 Fixed the UX for mounting disk images so if works really smooth. This is actually pretty awesomw :-)
2026-05-28 Added creation of LittleFS on build, which is included when flashing the device.
2026-05-28 Switched to use Core 1 for the emulator, while Core 0 runs the manager. This surprisingly decreased the CPU use of the emulator.
2026-05-28 Fixed button handling, and completed the ROM loading and changing.
2026-05-31 Implemented support for D64 and G64 image mounting.
2026-05-31 Fixed up the directory and mount point handling. Not perfect yet, but closing in on something working.
2026-06-06 Added logging of track layout
2026-06-07 Use double buffering for Active track to stabilize things.
2026-06-07 Another fix attempt not working. Switching to another fatfs lib.
2026-06-07 Moved LED control to emulator core, as the LED indication was not in sync with the emulator. This is much clearer now.
2026-06-08 Added bash script to attach to RTT logging on running target. Added memory snoop of target track and sector, to be able to understand what the drive is doing.
2026-06-09 Attempt to improve track loading delays.
2026-06-09 Another attempt to speed up track loading.
2026-06-10 Implemented a track buffer which handles double buffering and safety internally
2026-06-10 Fix track length loading in virtual_dir.rs
2026-06-10 Refactored track buffer to be much cleaner.
2026-06-11 Added timing logging for track fetch from SD card.
2026-06-11 Added more reliable track warping mechanism, by doing the warp only when the drive is actively polling bytes from the track. This makes this mechanism 100% accurate to what the drive is actually doin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
    Fixed warnings when compiling for the rp2040 target.
2026-06-12 Fixed speed sone handling, and changed Track IX to be half-track *2, which is cognitively easier to follow. This means Half-track 0 is now outside of the disk, and half-track 2 = Track 1 on the disk.
2026-06-12 Fixed sectors per track to be a common inline function. Changed track length, but this does not work.
2026-06-12 Restored the original Half-track 0 = Track 1, which makes more sense.
2026-06-12 Implemented more stable SO handling, to get perfect timing. Implemented track seek offset lookup table, to speed up track loading from SD card.
2026-06-13 Imolemented interrupt handler for track loading, to preempt other manager task and achieve consistent track load timing.
2026-06-17 Fix Track 18 interleave to 3 to prevent C64 IEC timeout during LOAD '*'
2026-06-17 Stabilized D64 track layout handling even more.
2026-06-18 Changed to use IRQ driven keyboard matrix driver, and refactored high-level keyboard handling to take care of high level events like hold and button combos.
2026-06-18 Fixed track loading bug in G64 images. This was likely contributing to fastloaders not working.
2026-06-19 The G64 track index was wrong. This is now fixed.
2026-06-19 Improved speed of track loading. Fixed bug that caused drive mechanics track to be misaligned with Track Buffer track.
2026-06-28 docs: Add PIO Magnetic Surface Emulation design spec
2026-06-28 docs: Add PIO Magnetic Surface implementation plan
2026-06-28 feat: Add MagneticSurface trait and Software fallback
2026-06-28 Refactor Emulator to use MagneticSurface trait
2026-06-28 feat: Add PIO state machine for magnetic surface
2026-06-28 feat: Implement PioMagneticSurface and DMA Ping-Pong loop
2026-06-28 fix: resolve PIO IRQ clearing bug and optimize G64 track parsing
2026-06-28 fix: resolve DMA alignment and byte swapping for PIO SYNC detection
2026-06-28 fix: replace broken chained DMA with CPU polling to ensure infinite track streaming
2026-06-28 fix: correctly trigger DMA channel by writing to CTRL_TRIG instead of AL3_TRANS_COUNT
2026-06-29 feat(pio): implement chained DMA and GPIO 10 SYNC output
2026-06-29 feat(pio): add debug logging of PIO bytes to UART
2026-06-29 fix(pio): revert to software DMA reset to fix loop timeout
2026-06-29 fix(pio): restore chained DMA with 8-byte alignment fix
2026-06-29 fix(pio): set GPIO 10 direction to output and log first 16 bytes of track
2026-06-29 chore(debug): hardcode GPIO 10 to high for logic analyzer wiring test
2026-06-29 fix(pio): use chained DMA ping-pong and align TrackBuffer to 8192 bytes
2026-06-29 fix(pio): restart DMA on buffer swap to prevent feeding uninitialized 0s
2026-06-29 fix: set pindirs in pio and dynamic clock based on track zone
2026-06-29 fix: DMA ping pong looping bug and sync pin active low logic
2026-06-29 feat: Exact arbitrary byte DMA tracking with instant reload polling
2026-06-29 fix: APB DMA unaligned access workaround using software bit-reversal
2026-06-30 Refactored the magnetic surface PIO model and implementation.
2026-07-01 Added PIO tests to verify the code without the need to test actual images on the device.
2026-07-01 Fixed the PIO magnetic surface handling after cleanup. Now it works again.
2026-07-03 perf: Remove dead is_sync_active() call from hot path
    The is_sync_active() call in DriveMechanics::tick_cycles was a one-way
    sync asserter (could only set is_sync=true, never clear it) called every
    tick through a virtual trait dispatch. For PioMagneticSurface it always
    returned false (pure dead code). For SoftwareMagneticSurface it was
    redundant since the sync state was already set by the 0xFFFFFFFF sentinel.
    - Give MagneticSurface::is_sync_active() a default impl returning false
    - Remove the per-tick is_sync_active() call from DriveMechanics
    - Remove redundant override from PioMagneticSurface
    Eliminates one virtual call per emulator tick (~1M/sec).
2026-07-03 perf: Cache PAC register pointers and optimize DMA restart in hot path
    All PIO and DMA register accesses in try_read_byte() now use cached raw
    pointers instead of constructing PAC proxy objects on every call. This
    eliminates the indexed register address computation (ch(0), sm(0),
    rxf(0), fstat()) that may not be fully optimized at -Os.
    Hot path changes:
    - fstat/rxf reads: raw read_volatile with cached pointers
    - DMA busy check: raw read_volatile on cached CTRL_TRIG pointer,
    bit 24 = BUSY
    - DMA restart: 3 write_volatile calls (read_addr, trans_count,
    ctrl_trig) using cached pointers and a pre-computed ctrl value
    with EN=true
    The cached_ctrl_enabled value is pre-computed at init and up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
2026-07-03 perf: Cache track pointer and length for zero-cost DMA restart
    The DMA restart path in try_read_byte() previously called
    get_full_buffer_ptr() and get_active_track_length() on every restart,
    each of which performs an atomic load of active_index + unsafe buffer
    dereference. Since the track data only changes on start_reading()
    (track switch or active_index change), cache the pointer and length
    in the struct.
    The DMA restart fast path now uses only cached values — no atomic
    loads, no pointer dereferences — just 3 raw write_volatile calls.
2026-07-07 Fully DMA driven magnetic surface.
2026-07-07 Fixed the DMA driven track streaming.
2026-07-07 feat: add CPU struct and jump table framework
2026-07-07 Fix CPU structure and jump table framework issues
    - Remove double counting of elapsed CPU cycles in op_unimpl
    - Add Default trait implementation for CPU
2026-07-07 Fix Task 4 regressions: restore interrupts, extract do_adc/do_sbc, add generation script
2026-07-08 fix: ensure drive mechanics sync frequently enough when motor is on
2026-07-08 feat: thread cycle_offset through CPU helpers
2026-07-10 Move track buffer code to SRAM
2026-07-10 Added larger delta min when motor is on.
2026-07-13 Added on-device tests for performance measurement.
2026-07-16 Fixed overflow in track speed calculation. Seems to work rock solid now :-D
2026-07-17 Fixed IRQ issue, where the IRQ was suppressed when it should not be.
    Added RAM dump facility. Fixed logic bug on ATN lines.
    Moved DMA reset to code (not sure if this is a good idea).
    Restored the DMA handling in the magnetic surface.
    Added missing fast loader tests.
2026-07-17 Fixed the LED and MOTOR states to be realistic in regards to the VIA direction register. The behavior was not correct before. Fixed some other minor details.
2026-07-17 Moved logging to not interfere with track loading timing. Fixed LEDs to they are off when the drive is held in reset.
2026-07-17 Fixed noise buffer to be more sensical, and in tune with what the DMA configuration is set up for.
2026-07-17 Changed to single output byte from DMA. Removed some unnecessary debug code, and reorganized the code to be much simpler in drivemechanics.
2026-07-19 fix: Add DDR writes and pass hardware context to VIA interrupts
2026-07-20 fix: Implement cycle-exact RP2040 timer spinlock for I/O
2026-07-21 Refactored the hardware layer to be simpler. Did some optimizations around handling of auto ATN ack, and ATN interrupt triggering.
2026-07-22 Fixed broken motor handling and some more ATN bugs due to code duplication.
2026-07-24 Fixed the performance tests after refactoring and optimization. The test results are currently nothing but astonishing!
2026-07-25 Refactor DMA start logic to DriveMechanics and fix unused mut warning
2026-07-27 Strictly decouple DMA reading from motor ON/OFF state
2026-07-27 Fixed track handling
2026-07-27 Refactored track to magnetic surface hand-off, to simplify the logic needed to determine if the data should be streamed or "analog noise".
    Cleaned up code afterwards and made sure all tests pass.
2026-07-30 Rewrote the magnetic sufrace DMA control to be SANE. Removed unused broken test block.
2026-07-30 Created PoC for track position recalculation on track change.
2026-07-30 Implemented dynamic head position scaling on track change.
2026-08-03 Fixed display driver to not crash if display is not there.
2026-08-06 Fixed jitter by putting missing functions in RAM.
2026-08-06 Added debug pin capture of sector retry events.
2026-08-06 Separated display state from the driver itself, to make the UI and driver work completely separate. Aka, the UI works under the hood, without the display even attached.
2026-08-06 Fixed issue with keyboard matrix, which seems to have caused some chip damage on the old board and was causing the UI to hang up.
2026-08-08 Added SO to debug pin, and removed non-functional and unnecessary error detection code.
2026-08-08 Refactor track cache to use zero-RAM prediction using DualCoreTrackBuffer back-buffer
2026-08-08 Fix step prediction direction logic to use previously active track
2026-08-08 Preserve pre-cached track state when stepping over empty half-tracks
2026-08-12 Set Core1 to have bus priority over DMA.
2026-08-13 Removed min_delta optimization completely, since it was only working when the motor was OFF. But we need optimization when the motor IS running, so this entire code block was pointless. We can simply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
2026-08-13 Track IEC access in emulator time, so we only catch up every 32 cycles if the IEC port has not been accessed explicitly by the CPU. This should avoid extra spin_waits when the IEC port is hammered by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
2026-08-13 Added comments ti ViaHardware trait. Added set reset state function, which is used to control the hardware (LEDs) when the device goes into or comes out of reset. This emulates the initial VIA input 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
2026-08-13 Removed debug pin usage for now.
2026-08-13 More optimization in the physical pin handling.
2026-08-14 Added 2 byte buffer for read bytes, to account for borderline read jittering. Now we never loose bytes, which may cause retries.
2026-08-14 Moved mounting responsibility to a dedicated mount manager. This is now responsible for the mounted image, and handling the status LED.
2026-08-16 Created V2 of schematics.
2026-08-18 Changed to use the PIO FIFO for byte read signalling, eliminating DMA and sentinel buffer overhead.
2026-08-19 Reduced the ATN poll interval to 4. This did not improve ATN driven demo loader sadly.
    Updated v2 schematic.
2026-08-20 Added symbol library which contains the CC logo. Added new mousebites footprint
2026-08-21 Added 1K pull-up on the data output pin, to make it possible to drive high by configuring the pin as an input. This can be done independently of the pin state, resulting in a hardware ATN ack functio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
2026-08-21 Removed overly complicated future prediction code, gaining no real benefits when really needed (when motor is running and files are read). This should be much simpler.
2026-08-25 Added scripts for analyzing VICE trace logs.
2026-08-27 Further simplified the Systembus implementation. Completely removed code from hot-loop motor on handling, as it was completely irrelevant when the motor is on. Changed cold functions to inline never!
2026-08-28 Fixed logging and avoid ERRORs on directory change due to disabled Virtual Directory feature. Fixed loading current track on mount, so the track is available in the buffer when the drive starts spinn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
2026-08-28 Implemented faster track change messaging using a Signal instead of a full-fledged channel. This minimizes the instructions needed to send a track change request to the manager.
2026-08-31 Fixed some minor warnings, and fixed formatting. Added new performance test. Did some cleaning up in track buffer.
2026-09-03 Refactored the mount manager from a huge monolith to a more separated set of modules.
2026-09-03 Fixed track buffer alignment issue, so it does not take up much more space than it actually needs, while keeping the boundaries DMA safe.
2026-09-04 Added scripts for convert logic analyzer and VICE traces to VDC format for visual inspection of the data.
2026-09-15 Added V2 Schematic PDF
2026-09-15 Fixes to get the emulator up and running on the Pico 2 fully.
2026-09-16 Fixed reset handling and LED behavior, which has been botched for some reason.
2026-09-16 Fixed VIA2 init issue which caused phantom stepping and track misalignment. This should now work as expected.
2026-09-17 Fix Track 1 VirtualDisk unreadable bug and cleanup
2026-09-17 Fix MountManager UI starvation and D64 disk ID generation on swap
2026-09-18 Fix timer usage for rp2040 and remove dangling tasks in main.rs
2026-09-18 fix: remove spammy timer logs
2026-09-18 refactor: decouple MountManager into TrackCacheTask and MountControllerTask
2026-09-18 refactor: inject Channel Sender/Receiver endpoints and encapsulate MOTOR_STATE
2026-09-18 refactor: permanently remove track preload/cache logic (YAGNI)
2026-09-19 Fixed some discrepencies in track loading. This seems to work quite stable.
2026-09-19 fix(nbz2nib): report decompressed size and track count, support -o CLI flag
2026-09-19 feat(manager): implement NibImage format driver
2026-09-19 fix(manager): bound NIB header track parsing and add multi-track test
2026-09-19 feat(manager): integrate NIB disk images into UI and MountManager
2026-09-19 refactor(manager): deduplicate file opening and add MountPayload::Nib unit test
2026-09-20 feat(manager): precalculate NIB track lengths at mount time
2026-09-20 feat(manager): handle CD: navigation and mount switching in MountControllerTask
2026-09-26 fix(manager): pre-populate directory track before first GCR commit
    - In mount_sequence(), after creating VirtualDiskImage with a fresh
    PagedDirectorySource, synchronously fetch the first 16 entries from
    list_dir_range() and populate block 0 via paged.set_block(0, ...).
    This ensures Track 18 GCR is generated with real entries rather than
    an empty directory.
    - Also removed the spurious paged.invalidate() call that immediately
    followed -- it was wiping the prefetch we just loaded. mount_sequence()
    always creates a brand-new PagedDirectorySource, so invalidation is
    a no-op at best and destructive at worst.
    Root cause: LOAD"$",8 would stream Track 18 to the C64 before the
    20ms tim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
2026-09-27 feat(manager): single PRG file mounting via track-1 treadmill
    - Add MountPayload::Prg(path, use_internal) for non-image file mounts.
    Status LED reports VirtualDisk mode, same as VirtualDirectory.
    - In mount_sequence(), detect non-image files via is_single_file() helper
    (any extension that is not .d64/.g64/.nib). For these:
    * Create VirtualDiskImage with a single shortcut DirectoryEntry at
    first_track=1, first_sector=1.
    * Open the file and attach it as vdir.file_storage so the existing
    track-1 treadmill in update_dynamic_buffer streams the bytes.
    - In VirtualDiskImage::read_track for track 1, pre-populate sectors 1
    and 2 with the first two 254-byte file blocks by c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
2026-09-27 fix(manager): stop disk-swap reset from clearing shortcut_entry and file_storage
    The disk-swap block in mount_sequence was calling set_shortcut_entry(None)
    and file_storage = None on the freshly-created VirtualDiskImage, destroying
    both the PRG shortcut directory entry and the file handle we had just set up.
    mount_sequence always creates a new VirtualDiskImage, so these clears had
    no useful effect for directory mounts (fields are already None by default)
    and actively broke PRG mounts (fields deliberately set).
    Removed both lines. Added a comment explaining why neither field should be
    reset here.
2026-09-27 fix(manager): prevent file-streaming treadmill from corrupting track 18 GCR
    Two related bugs caused a 21,READ ERROR (no sync) when listing the
    directory of a PRG mount:
    1. read_track(18): force_update_directory_sectors was called unconditionally
    at the end of track 18 GCR generation. In PRG mode file_storage is set,
    so update_dynamic_buffer went into file-streaming mode and overwrote the
    correctly-built directory sector 1 GCR with raw PRG bytes, destroying the
    sync marks. Fix: skip force_update when shortcut_entry is set (PRG mode).
    The sector was already encoded correctly in the main sector loop.
    2. timer.rs: the file-streaming branch ran whenever file_storage.is_some()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
2026-09-27 fix(manager): use Accurate layout for track 1 treadmill instead of Warped
    Warped(stride) positions the emulator at byte (sector_number × stride)
    when the ROM requests a sector. The stride was 366 but the actual GCR
    byte offsets for each sector are 69, 425, 781, ... (not 0, 366, 732, ...).
    This caused the emulator to seek into the middle of a different sector's
    data block, find no valid header sync, and report the sector as missing.
    The 1541 ROM responded with its standard retry: step head ±0.5 tracks
    and sweep the whole disk — visible in logs as the T18→T1→T17→T1 sweep.
    Fix: return TrackLayout::Accurate with the real written byte count,
    identical to track 18. Accurate simply wr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
2026-09-27 feat(manager): multi-track PRG virtual disk layout and 1541 job queue telemetry
    - Lay out PRG files across tracks 17 down to 1 using standard 21-sector
    formatting with interleave 10, instead of a brittle 2-sector timer treadmill.
    Track 17 holds blocks 0..20, Track 16 holds blocks 21..41, etc.
    - Set DirectoryEntry::from_file_info first_track to 17, first_sector to 0.
    - Fix Track 18 and skeleton track header/data sync bytes from 10 to 5 bytes,
    matching the GCR layout calculation (354 bytes base sector length) and
    eliminating directory track seek retries (18.0 -> 18.1 -> 18.0).
    - Populate valid BAM free block counts for tracks 1..35 on Track 18 sector 0.
    - Remove file streaming treadmil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
2026-09-27 fix(emulator): filter out boot-time RAM diagnostics from job queue logging
    During drive power-on and reset, the 1541 ROM executes a zero-page memory
    diagnostic that sweeps bash0.. across bash000..bash0FF. This produced hundreds
    of false job logs (0x80..0xFF) across all buffers.
    Filter these writes by requiring:
    1. Valid job opcode format (val & 0x8F == 0x80)
    2. DOS initialized flag set (0x001C != 0)
    3. Valid target track number (1..=40)
2026-09-27 fix(manager): sequential physical sectors for Track 18 and remove noisy job queue logging
    - Track 18 physical sector headers were scrambled with (physical_sector * 3) % 19,
    causing sector 1 and sector 2 to be positioned out of physical order and leading
    to missed revolutions and 18.0 -> 18.1 -> 18.0 retries. Fixed to sequential order (0..18).
    - Removed verbose [JOB QUEUE] logging from SystemBus::write which fired on boot
    RAM diagnostics and polluted the logs.
    - Added byte-exact unit test test_virtual_disk_prg_byte_exact verifying fb.prg
    GCR decode against original binary.
2026-09-28 docs(specs): add design spec for paged track 18 directory and track-mapped PRG loading
2026-09-28 docs(specs): add implementation plan for paged track 18 directory and track-mapped PRG loading
2026-09-28 feat(manager): paged directory source with navigation entries and track/sector mapping
2026-09-28 fix(manager): resolve off-by-one page indexing, arithmetic safety and page capacity drift
2026-09-28 feat(manager): static 19-sector sequential track 18 formatter without treadmill
2026-09-28 fix(manager): clean up legacy treadmill struct fields and assert empty sector chaining
2026-09-28 fix(manager): clean up track 18 condition and slice copy bounds
2026-09-28 feat(ipc): snoop 1541 job queue to select virtual file by track and sector
2026-09-28 fix(ipc): correct job bitmask, prevent mid-stream re-selection, and reload active track
2026-09-28 feat(manager): multi-track downward PRG streaming with offset start and track wrap
2026-09-28 fix(manager): wrap multi-track PRG streaming back to prg_start_track
2026-09-29 refactor(manager): truncate null bytes in new_dir and strengthen track 18 sector count test
2026-09-29 feat(manager): mount manager root slot handling and unified location state transitions
2026-09-29 refactor(manager): synchronize CURRENT_PAGE, handle page navigation in select_virtual_file, and accurate LED mode
2026-09-29 feat(ui): reactive OLED UI reflecting unified CURRENT_LOCATION
2026-09-29 refactor(ui): resolve review findings for reactive OLED UI and mount coordination
2026-09-29 refactor(ui): remove redundant browser mount block and prevent signaling loop
2026-10-11 fix(manager,emulator): eliminate virtual mount 500ms delay, set DOS wpsw on swap, and remove obsolete timer prefetch
2026-10-11 refactor(manager): clean up inline namespaces in mount_manager
2026-10-11 fix(manager): resolve mangled long directory names and case-insensitive mounted file tracking in OLED UI
2026-10-11 fix(manager): in-memory child resolution via ACTIVE_CHILDREN and unified Status LED in TrackCacheTask
2026-10-11 fix(manager): restore optical write-protect disk swap simulation and void track layout
2026-10-15 fix(manager): treat bare CD: probe as ignore in cd_handler
2026-10-15 fix(emulation): pause 6502 and hold IEC DATA low during track assembly
2026-10-16 fix(manager): ensure emulator is unhalted when mounting D64/G64 even if halted by CD command
2026-10-16 fix(nib2g64): Correct speed zone capacities and contiguous slice alignment
2026-10-16 feat: Implement MagneticSurface::poll_revolution and SoftwareMagneticSurface weak-bit variance
2026-10-16 refactor(rp2350): Use raw pointer volatile writes in poll_revolution to prevent DMA aliasing UB
2026-10-17 feat(emulator): integrate stepper clatter and motor state into sound triggers
2026-10-17 feat(rp2350): implement PWM sound driver and async SoundTask
2026-10-17 fix: eliminate bump race condition and increase settings channel capacity
2026-10-19 docs: add 1541 motor sound sample playback design specification
2026-10-19 docs: add 1541 motor sound sample playback implementation plan
2026-10-19 feat(common): add authentic 1541 motor hum sample and duty scaling
2026-10-19 feat(rp-common): add DMA motor sample playback to PwmPiezo
2026-10-19 fix(rp-common): optimize motor sample resume and add compiler fence
2026-10-19 fix(rp-common): unify motor hum start/resume and use sample count const
2026-10-19 feat(sound): integrate motor sample playback into sound_task and main
2026-10-19 fix(sound): avoid continuous buffer recalculation on idle motor and drain steps when muted
2026-10-19 fix(sound): clear motor_humming in play_tone, uniform step pause, and document DMA map
2026-10-19 chore: complete 1541 motor sample playback implementation and verification
2026-10-19 fix(sound): consume DMA channel tokens and add Cortex-M DMB barrier
2026-10-21 docs: add motor sound fade-in/out and click elimination design spec
2026-10-21 docs: add motor sound fade-in/out and click elimination implementation plan
2026-10-21 feat(common): implement sample_to_pwm_duty_faded for envelope scaling
2026-10-21 refactor(common): extract volume_gain helper and add edge case tests
2026-10-21 feat(rp-common): add envelope stepping and carrier-locked step click to PwmPiezo
2026-10-21 fix(rp-common): sync current_volume cache and add safety guards to PwmPiezo
2026-10-21 refactor(sound): unify timer sleep durations to FADE_STEP_DURATION_MS
2026-10-21 chore: verify 1541 motor sound fade-in/out and click elimination
2026-10-21 feat(sound): lower stepper click pitch to 600 Hz with configurable constants
2026-10-21 docs(specs): add authentic 1541 stepper and bump sample playback design
2026-10-21 docs(specs): add authentic 1541 stepper and bump sample playback plan
2026-10-21 feat(common): add authentic 1541 stepper and bump sample tables and duty scaling
2026-10-21 refactor(common): extract volume_gain helper and add rustdocs to stepper_sample
2026-10-21 feat(rp-common): add authentic stepper and bump sample DMA playback to PwmPiezo
2026-10-21 feat(sound): integrate authentic stepper sample playback into sound_task
2026-10-21 feat(common): add mixed_sample_to_pwm_duty_faded for continuous motor and stepper mixing
2026-10-21 refactor(common): reuse motor_sample volume_gain and expand mixed duty unit tests
2026-10-21 feat(rp-common): implement continuous-phase mixed DMA streaming in PwmPiezo
2026-10-21 fix(rp-common): switch to in-place buffer mixing to eliminate DMA reload truncation
2026-10-21 feat(common): reduce motor hum volume gain by 4x for subtle background hum
2026-10-21 feat(common): boost stepper clatter volume gain by 2.5x for distinct mechanical clicks
2026-10-21 feat(emulator): fire motor ON event on drive reset for authentic boot hum
